earabul-sudo/GBDP_CERN_Robot/Renders/20200414_IntegratedModel_EA_15_00_2020-May-28_08-21-39AM-000_CustomizedView31010884164_png.png

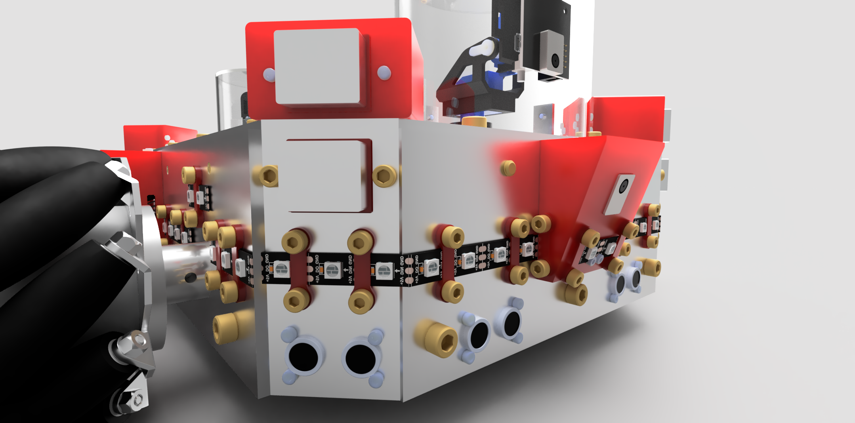
Renders/20200414_IntegratedModel_EA_15_00_2020-May-28_08-21-39AM-000_CustomizedView31010884164_png.png
