earabul-sudo/GBDP_CERN_Robot/Renders/20200414_IntegratedModel_EA_1600_2020-May-26_11-13-54AM-000_CustomizedView11686190738_png.png

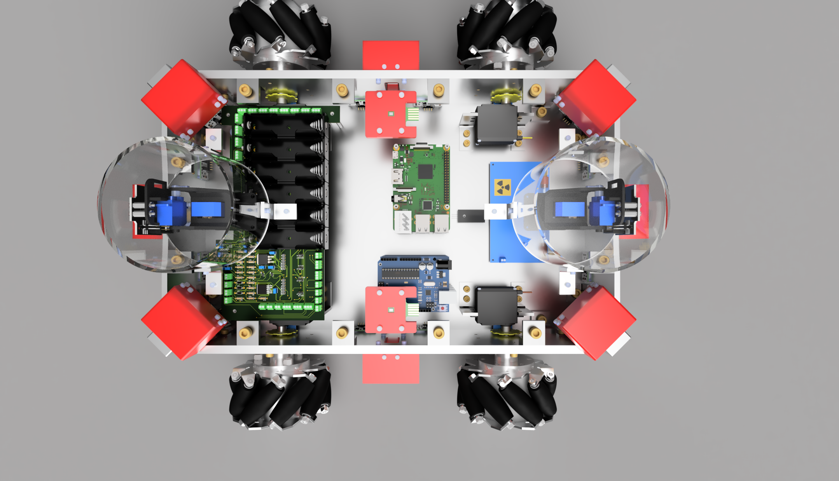
Renders/20200414_IntegratedModel_EA_1600_2020-May-26_11-13-54AM-000_CustomizedView11686190738_png.png
