earabul-sudo/GBDP_CERN_Robot/README.md

# GBDP_CERN_Robot

The report "20200524_PMReport_EA_04.pdf" can be read as the overview of the project.

The Complete CAD model can be found in;

https://a360.co/3e9NEjW

For any issues, please contact -> ea485@bath.ac.uk
