earabul-sudo/GBDP_CERN_Robot/Schematics_Drawings/LTC4150_Coulomb_Counter_BOB-master/documentation/spreadsheet.ods

Calculate the max current given the sense resistor
sense resistor | Rsense | 0.05 | ohm
max current | Imax | 1 | A
Calculate the sense resistor given the max current
max current | Imax | 1 | A
sense resistor | Rsense | 0.05 | ohm
Run the numbers
max current | Imax | 1 | A
sense resistor | Rsense | 0.05 | ohm
voltage gain | Vgf | 32.55 | Hz/V (from datasheet)
your current through Rs | I | 1 | A
frequency out | f | 1.63 | Hz
= one pulse every |  | 0.61 | s
one pulse equal to |  | 0.61 | coulomb
one pulse equal to |  | 0.0001707 | Ah
one amp-hour equals | 1 Ah = | 5859 | pulses
Calculate minimum pull-up resistor
computer supply | Vcc | 3.3 | V
Minimum pullup resistor | Rl > | 1750 | ohm
R1 |  | 75000 | ohm
R2 |  | 47000 | ohm
Eq 12 |  | 122000 | >= | 87500
Eq 13 | 1.9 <= | 2.03 | <= VDDmin (lowest batt V)
