earabul-sudo/GBDP_CERN_Robot/Renders/20200406_FrontBoard_EA_04_2020-May-25_08-08-47AM-000_CustomizedView26765888059_png.png

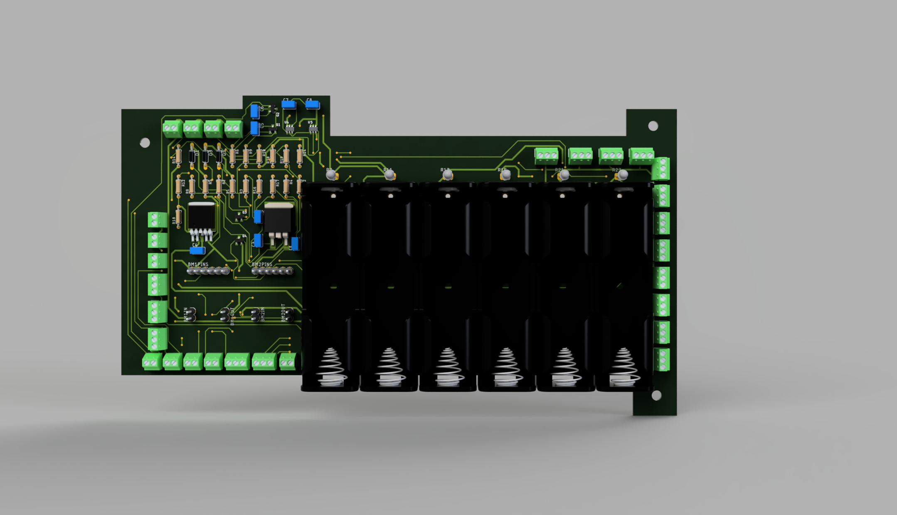
Renders/20200406_FrontBoard_EA_04_2020-May-25_08-08-47AM-000_CustomizedView26765888059_png.png
