earabul-sudo/GBDP_CERN_Robot/Renders/20200413_RaspberryPiStack_EA_00_2020-May-25_08-18-17AM-000_CustomizedView22463231648_png.png

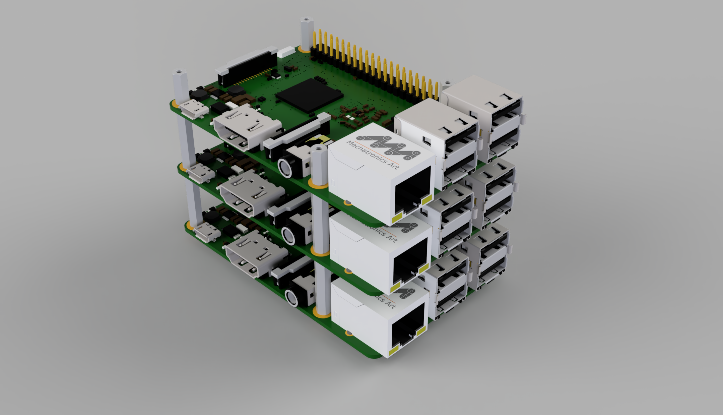
Renders/20200413_RaspberryPiStack_EA_00_2020-May-25_08-18-17AM-000_CustomizedView22463231648_png.png
