earabul-sudo/GBDP_CERN_Robot/Renders/20200414_ArduinoStack_EA_00_2020-May-25_08-23-36AM-000_CustomizedView26771065186_png.png

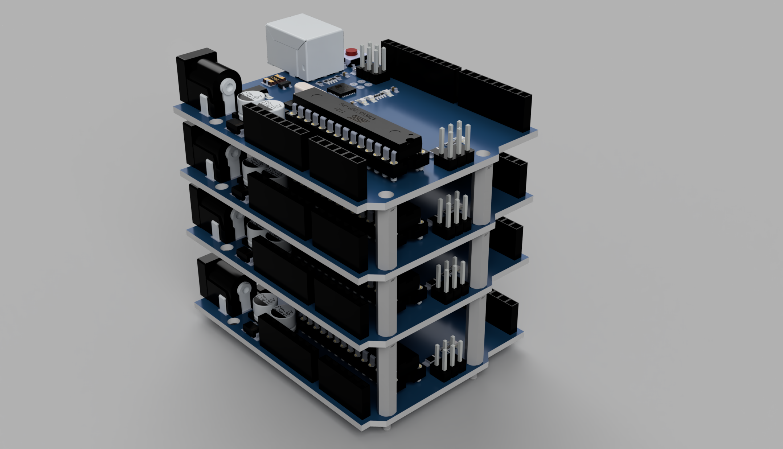
Renders/20200414_ArduinoStack_EA_00_2020-May-25_08-23-36AM-000_CustomizedView26771065186_png.png
