earabul-sudo/GBDP_CERN_Robot/Renders/20200414_IntegratedModel_EA_15_00_2020-Jun-01_04-20-42PM-000_CustomizedView44419950994_png.png

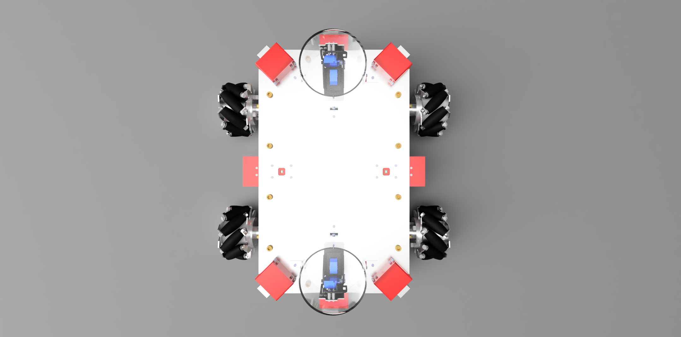
Renders/20200414_IntegratedModel_EA_15_00_2020-Jun-01_04-20-42PM-000_CustomizedView44419950994_png.png
