earabul-sudo/GBDP_CERN_Robot/Renders/20200414_IntegratedModel_EA_15_00_2020-Jun-02_04-21-08PM-000_CustomizedView185871683_png.png

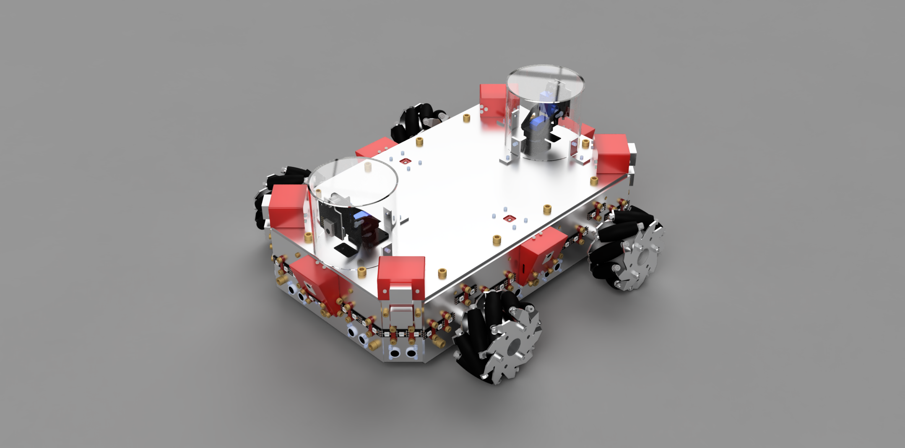
Renders/20200414_IntegratedModel_EA_15_00_2020-Jun-02_04-21-08PM-000_CustomizedView185871683_png.png
