earabul-sudo/GBDP_CERN_Robot/Renders/20200414_IntegratedModel_EA_15_00_2020-Jun-05_02-10-19PM-000_CustomizedView28039964760_png.png

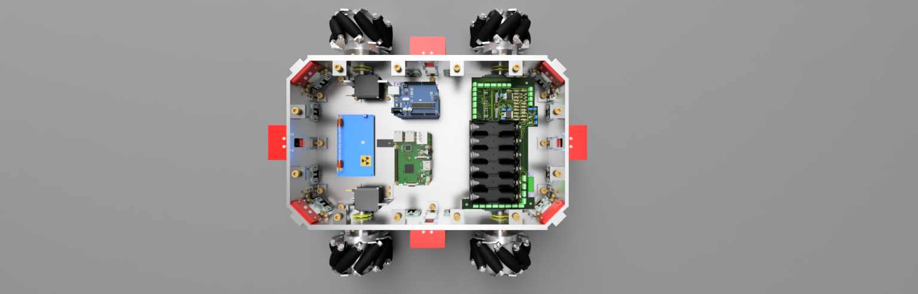
Renders/20200414_IntegratedModel_EA_15_00_2020-Jun-05_02-10-19PM-000_CustomizedView28039964760_png.png
