earabul-sudo/GBDP_CERN_Robot/Renders/20200414_IntegratedModel_EA_15_00_2020-Jun-05_02-23-30PM-000_CustomizedView17358813709_png.png

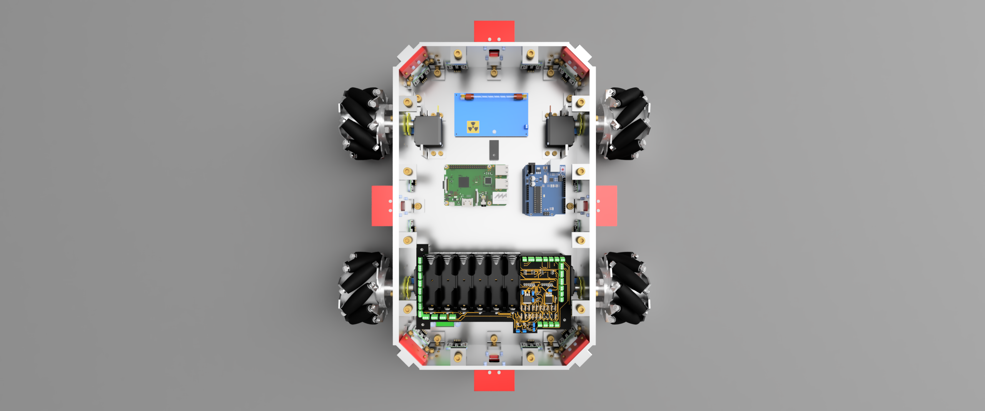
Renders/20200414_IntegratedModel_EA_15_00_2020-Jun-05_02-23-30PM-000_CustomizedView17358813709_png.png
