earabul-sudo/GBDP_CERN_Robot/Renders/20200414_IntegratedModel_EA_15_00_2020-May-24_08-03-37PM-000_CustomizedView12571228953_png.png

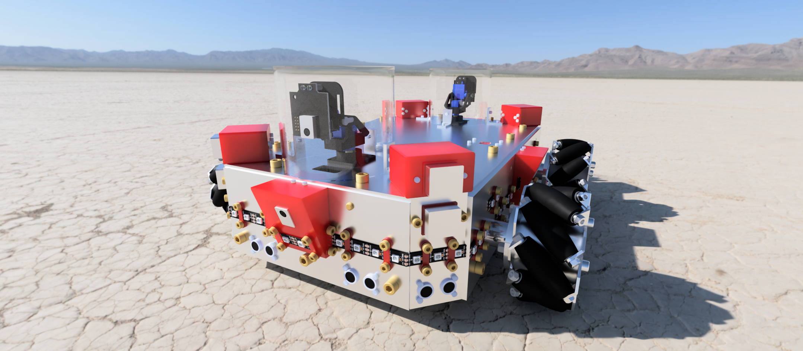
Renders/20200414_IntegratedModel_EA_15_00_2020-May-24_08-03-37PM-000_CustomizedView12571228953_png.png
