earabul-sudo/GBDP_CERN_Robot/Renders/20200414_IntegratedModel_EA_15_00_2020-May-25_07-35-35AM-000_CustomizedView1277902568_png.png

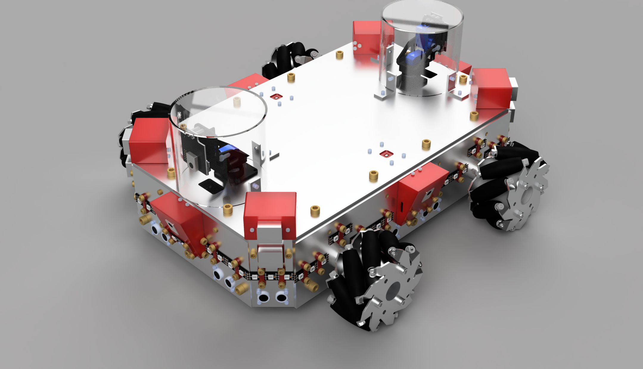
Renders/20200414_IntegratedModel_EA_15_00_2020-May-25_07-35-35AM-000_CustomizedView1277902568_png.png
