earabul-sudo/GBDP_CERN_Robot/Renders/20200414_IntegratedModel_EA_15_00_2020-May-25_08-12-26AM-000_CustomizedView5717836970_png.png

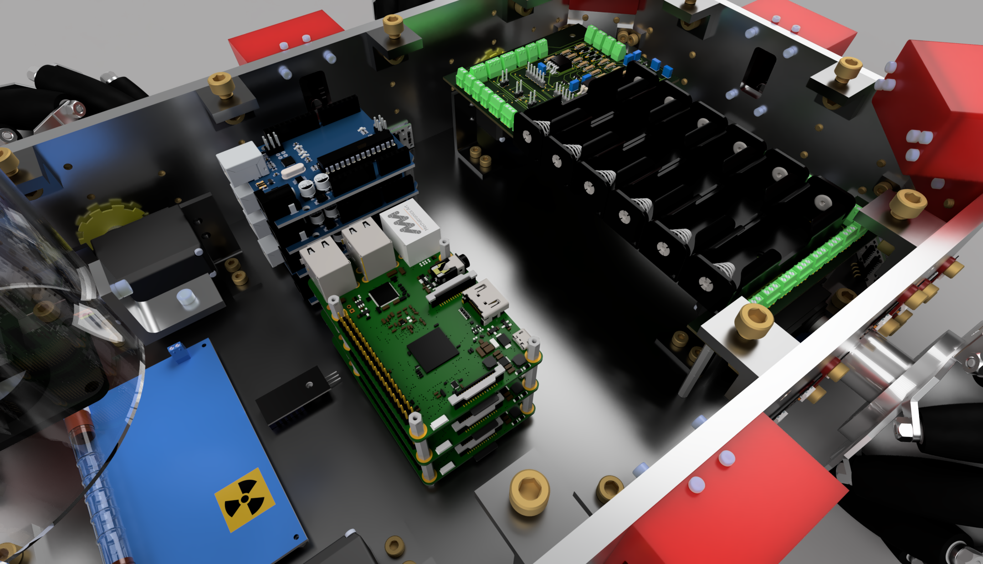
Renders/20200414_IntegratedModel_EA_15_00_2020-May-25_08-12-26AM-000_CustomizedView5717836970_png.png
