earabul-sudo/GBDP_CERN_Robot/Renders/20200414_IntegratedModel_EA_15_00_2020-May-28_08-05-02AM-000_CustomizedView13526864953_png.png

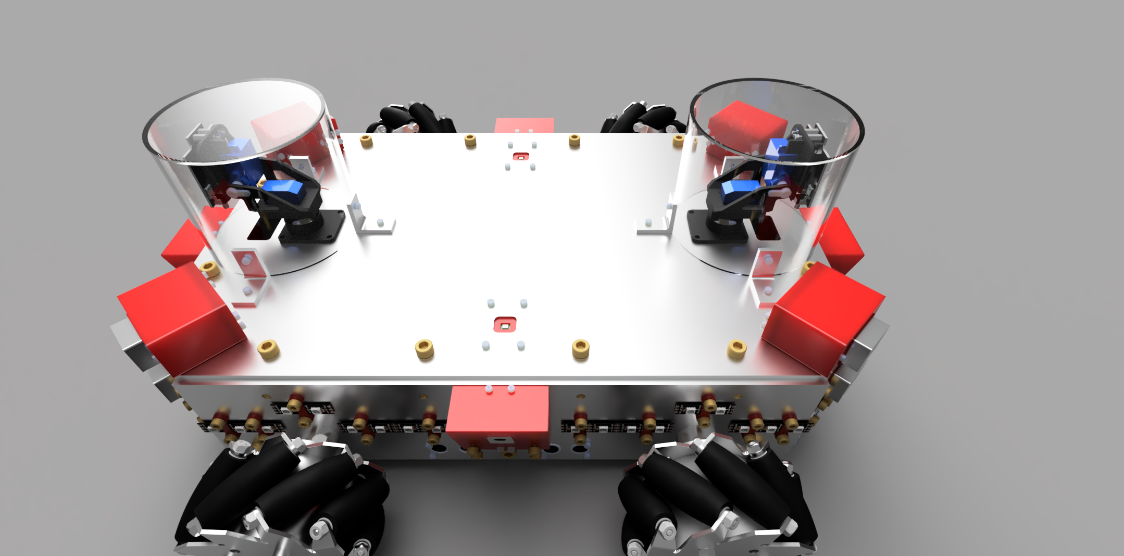
Renders/20200414_IntegratedModel_EA_15_00_2020-May-28_08-05-02AM-000_CustomizedView13526864953_png.png
