earabul-sudo/GBDP_CERN_Robot/Renders/20200414_IntegratedModel_EA_15_00_2020-May-28_08-20-58AM-000_CustomizedView8640977240_png.png

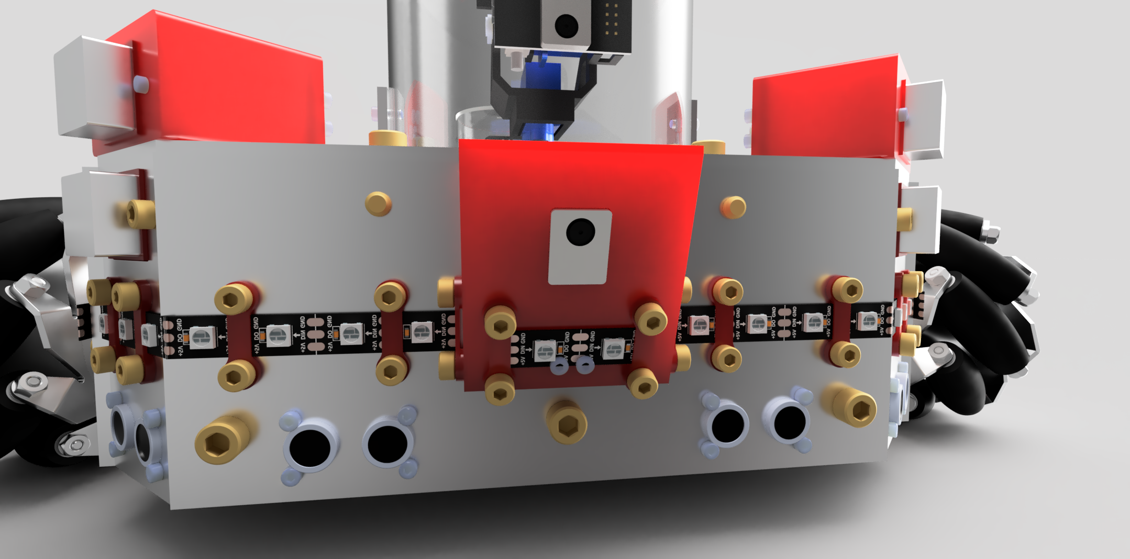
Renders/20200414_IntegratedModel_EA_15_00_2020-May-28_08-20-58AM-000_CustomizedView8640977240_png.png
