earabul-sudo/GBDP_CERN_Robot/Renders/20200414_IntegratedModel_EA_1600_2020-May-26_05-35-03PM-000_CustomizedView29689438640_png.png

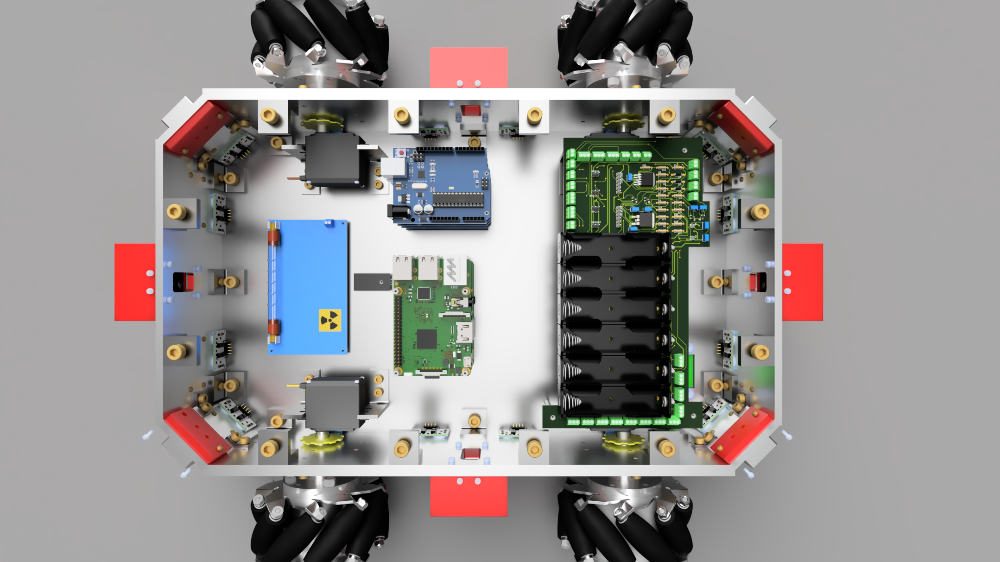
Renders/20200414_IntegratedModel_EA_1600_2020-May-26_05-35-03PM-000_CustomizedView29689438640_png.png
