earabul-sudo/GBDP_CERN_Robot/Renders/20200414_IntegratedModel_EA_1600_2020-May-26_11-09-33AM-000_CustomizedView14897361486_png.png

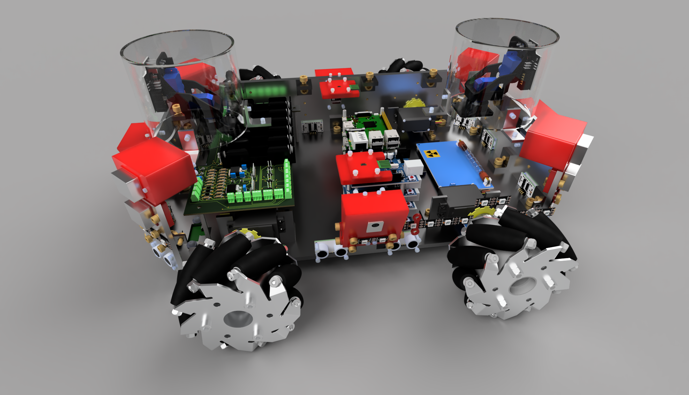
Renders/20200414_IntegratedModel_EA_1600_2020-May-26_11-09-33AM-000_CustomizedView14897361486_png.png
