earabul-sudo/GBDP_CERN_Robot/Schematics_Drawings/Grove-Optical_Rotary_Encoder-TCUT1600X01/Grove - Optical Rotary Encoder(TCUT1600X01).pdf

A

B

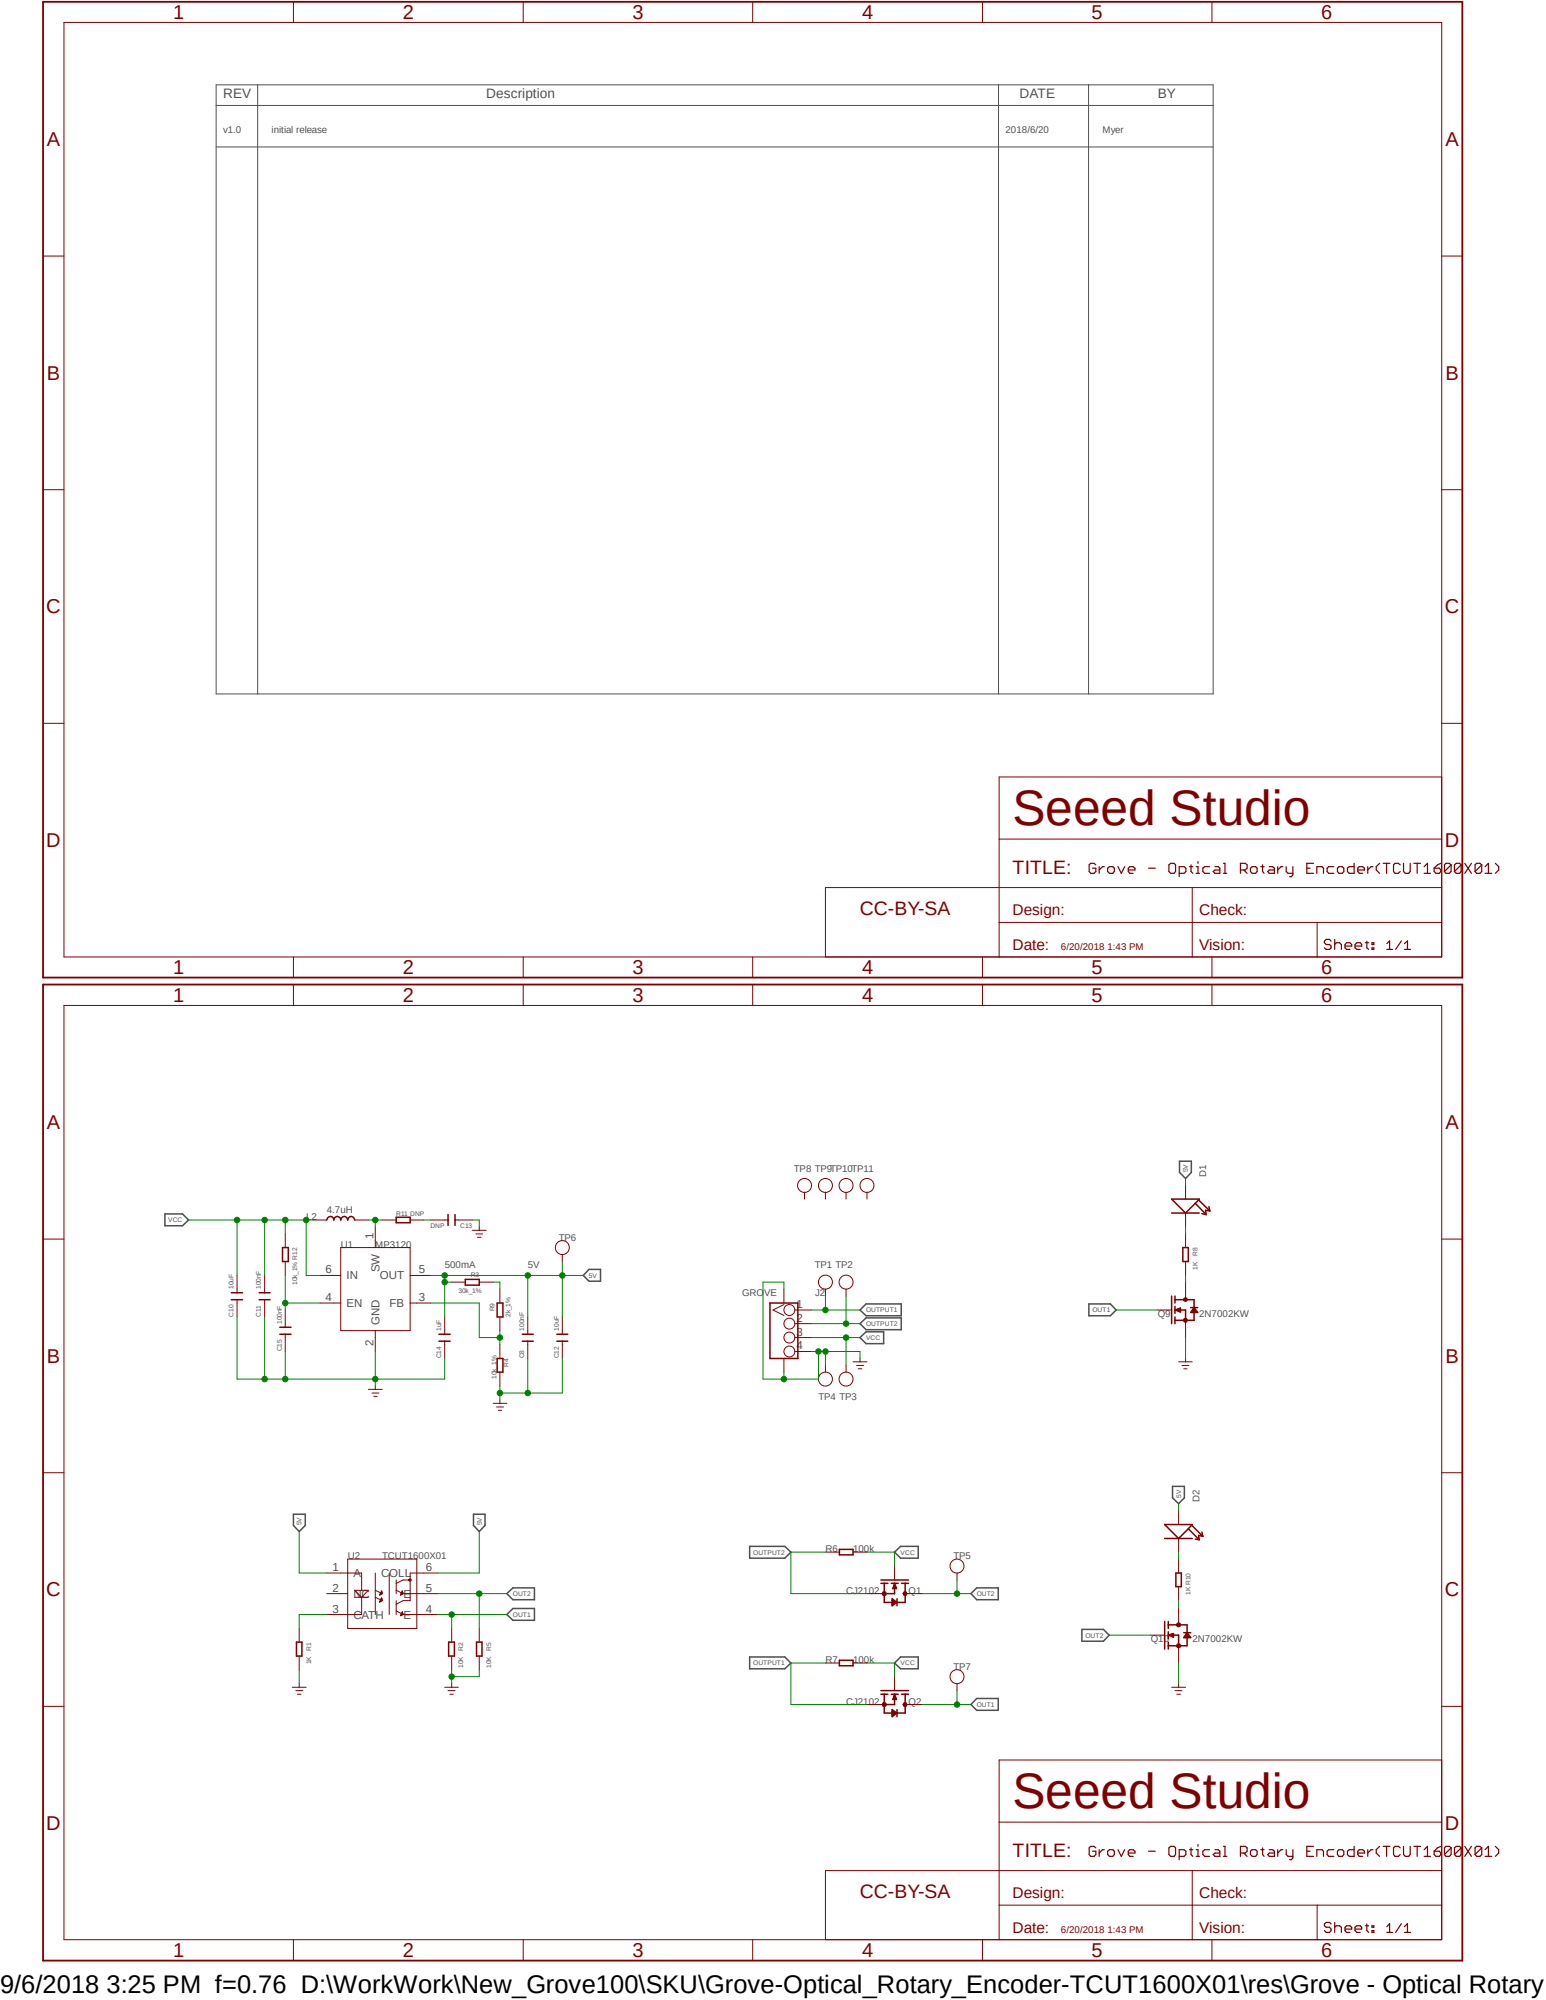
[picture p18: page 1]

9/6/2018 3:25 PM f=0.76 D:\WorkWork\New_Grove100\SKU\Grove-Optical_Rotary_Encoder-TCUT1600X01\res\Grove - Optical Rotary Encoder(TCUT1600X01).sch (Sheet: 1/1)
