earabul-sudo/GBDP_CERN_Robot/Schematics_Drawings/pdf/20200406_FrontBoard_EA_04_01.pdf

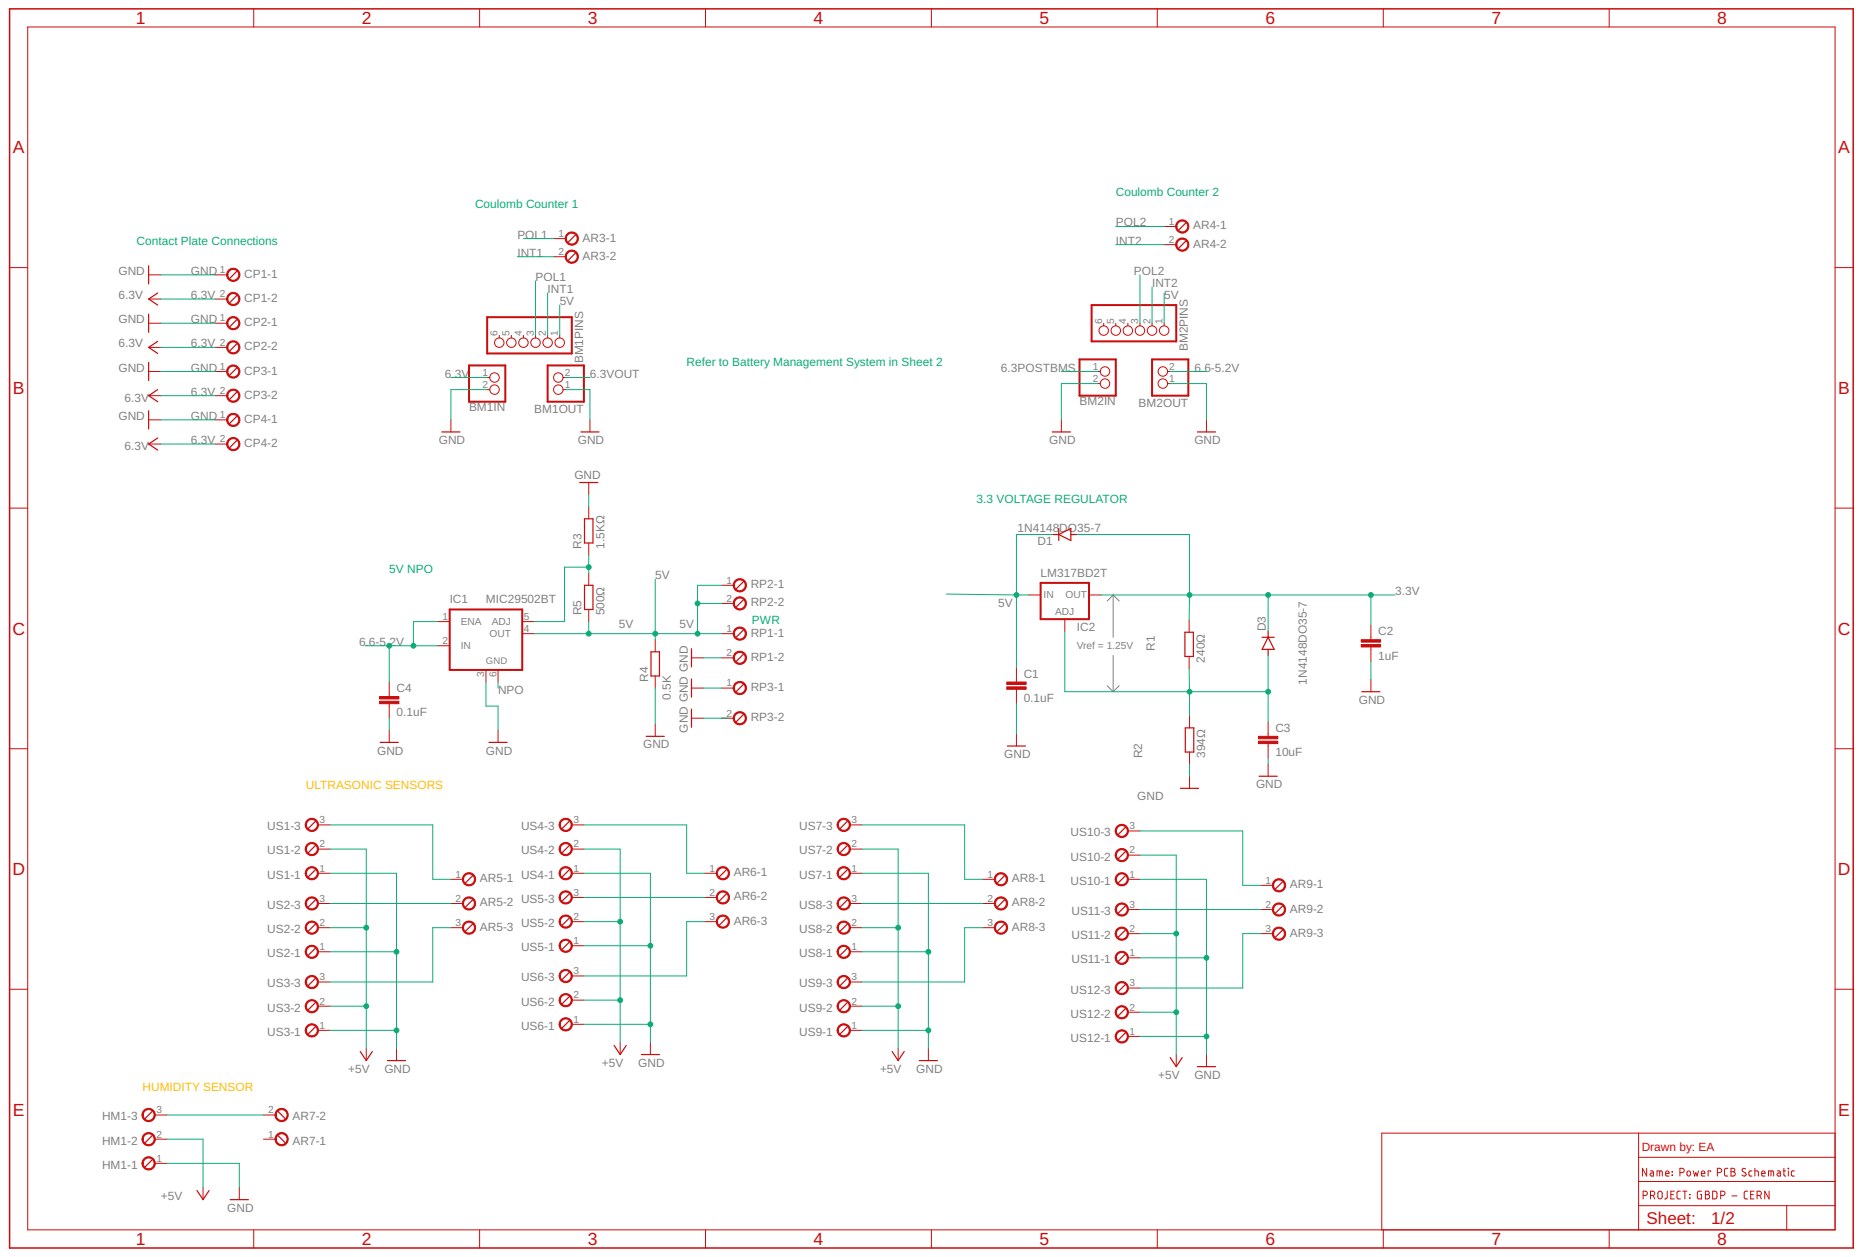
[picture p19: page 1]

Refer to Battery Management System in Sheet 2
