earabul-sudo/GBDP_CERN_Robot/Schematics_Drawings/pdf/20200413_Systems_EA_00.pdf

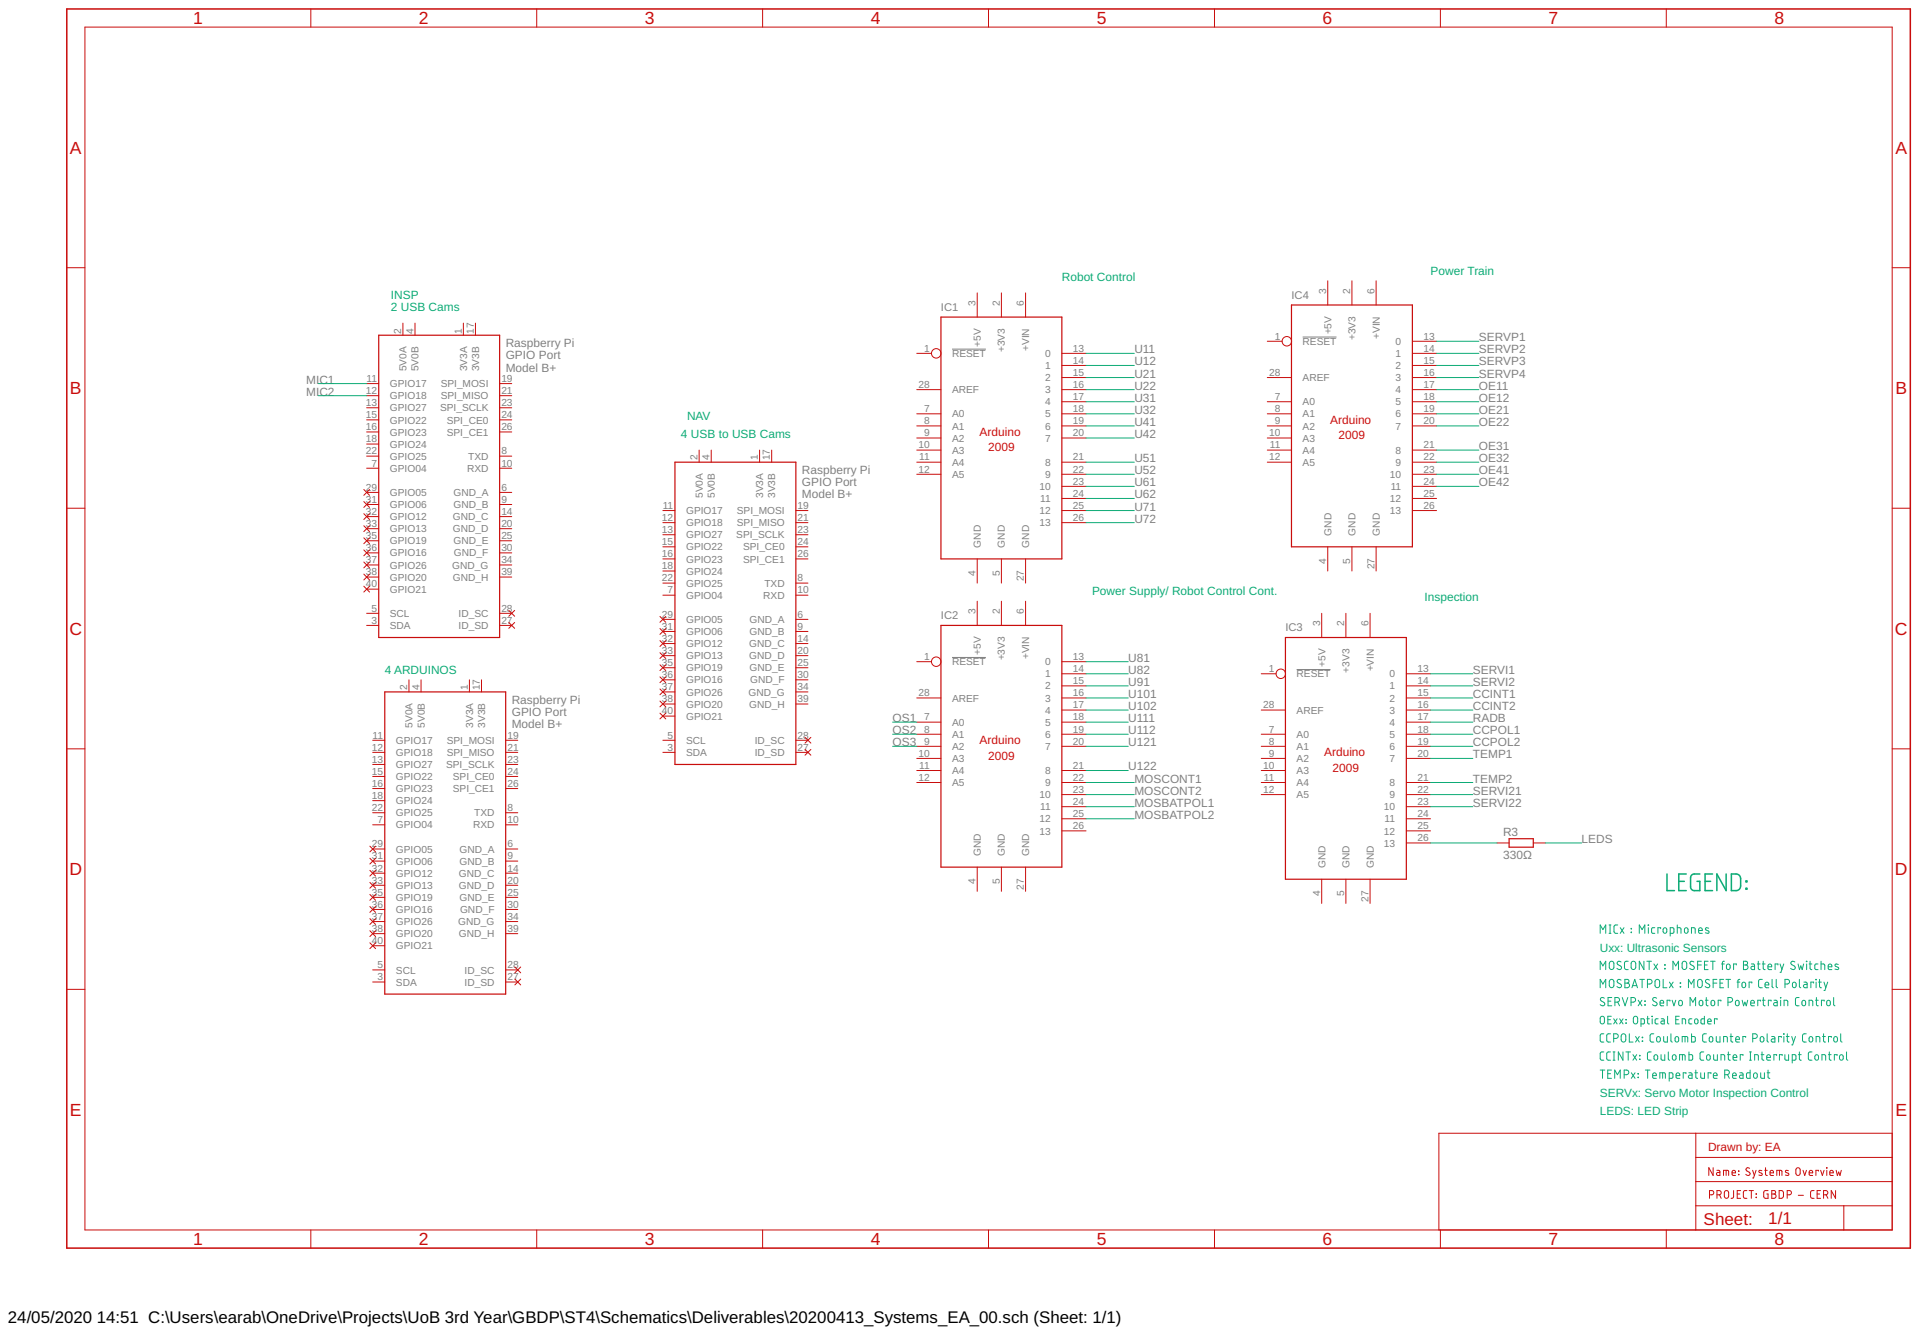
[picture p20: page 1]

4 USB to USB Cams NAV

Inspection Power Supply/ Robot Control Cont.

SERVx: Servo Motor Inspection Control
LEDS: LED Strip

24/05/2020 14:51 C:\Users\earab\OneDrive\Projects\UoB 3rd Year\GBDP\ST4\Schematics\Deliverables\20200413_Systems_EA_00.sch (Sheet: 1/1)
