earabul-sudo/GBDP_CERN_Robot/Schematics_Drawings/pdf/20200414_IntegratedModel_EA_15_01 v13.pdf

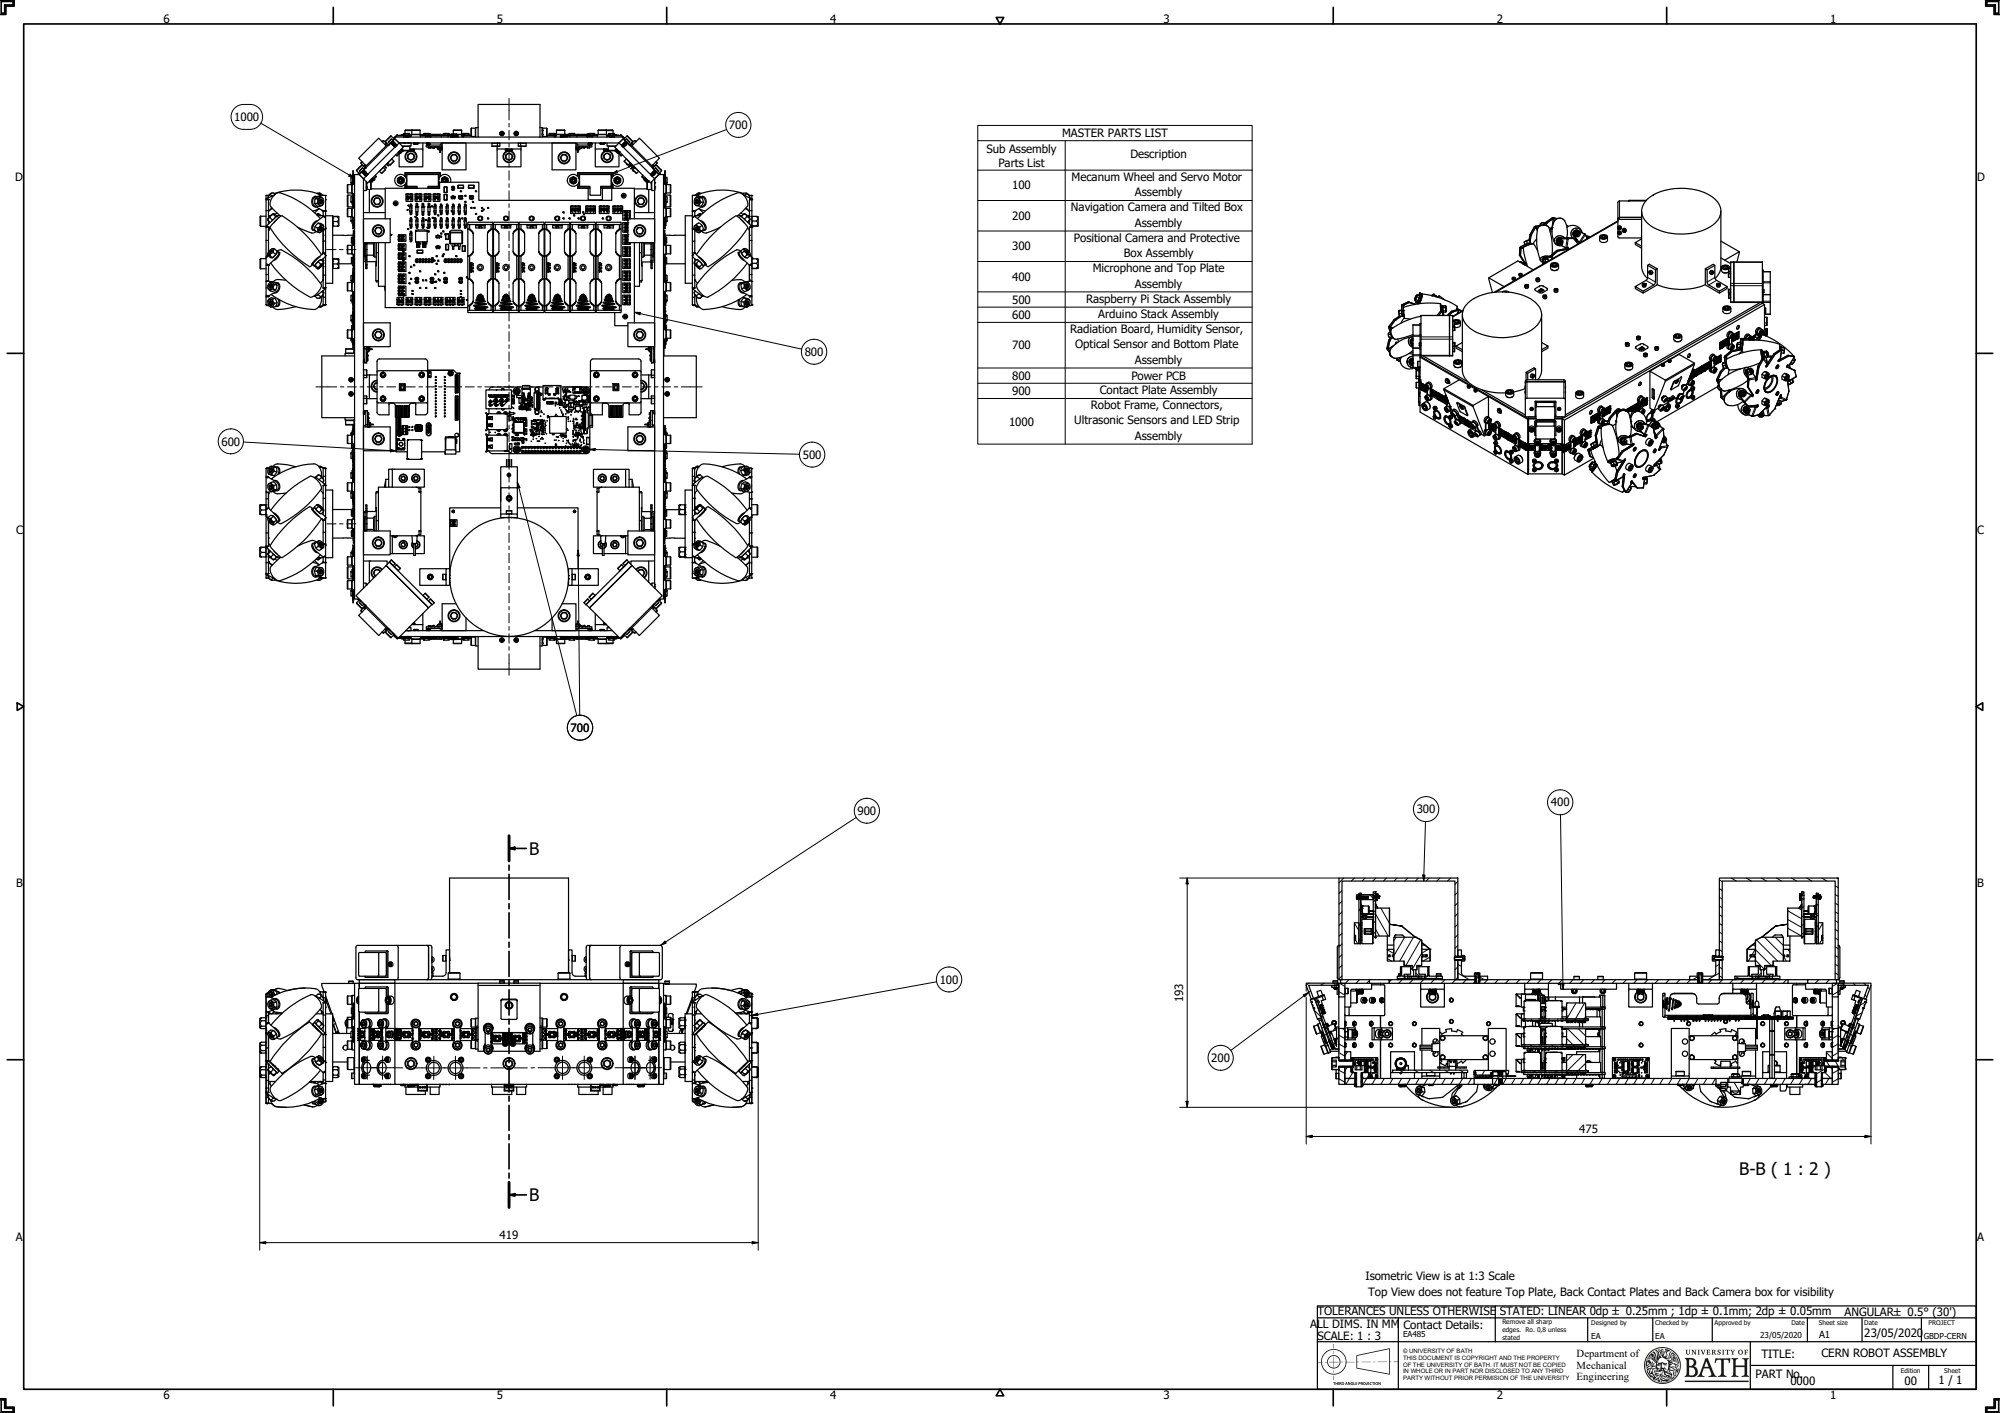
[picture p21: page 1]
Designed by; Checked by; Approved by; Date; Department of; SCALE: 1 : 3; Sheet size; PART No.; Contact Details:; TITLE:; CERN ROBOT ASSEMBLY; Sub Assembly Parts List; Raspberry Pi Stack Assembly; Arduino Stack Assembly; Power PCB; Contact Plate Assembly

MASTER PARTS LIST

Mecanum Wheel and Servo Motor

Navigation Camera and Tilted Box

Positional Camera and Protective

Box Assembly
Microphone and Top Plate

Radiation Board, Humidity Sensor,
Optical Sensor and Bottom Plate

Robot Frame, Connectors,
Ultrasonic Sensors and LED Strip

Isometric View is at 1:3 Scale
Top View does not feature Top Plate, Back Contact Plates and Back Camera box for visibility

TOLERANCES UNLESS OTHERWISE STATED: LINEAR 0dp  0.25mm ; 1dp ± 0.1mm; 2dp ± 0.05mm ANGULAR 0.5° (30')
ALL DIMS. IN MM

Remove all sharp
edges. Ro. 0,8 unless
stated

© UNIVERSITY OF BATH
THIS DOCUMENT IS COPYRIGHT AND THE PROPERTY
OF THE UNIVERSITY OF BATH. IT MUST NOT BE COPIED
IN WHOLE OR IN PART NOR DISCLOSED TO ANY THIRD
PARTY WITHOUT PRIOR PERMISION OF THE UNIVERSITY
