earabul-sudo/GBDP_CERN_Robot/Schematics_Drawings/pdf/20200523_ArduinoStackAssembly.pdf

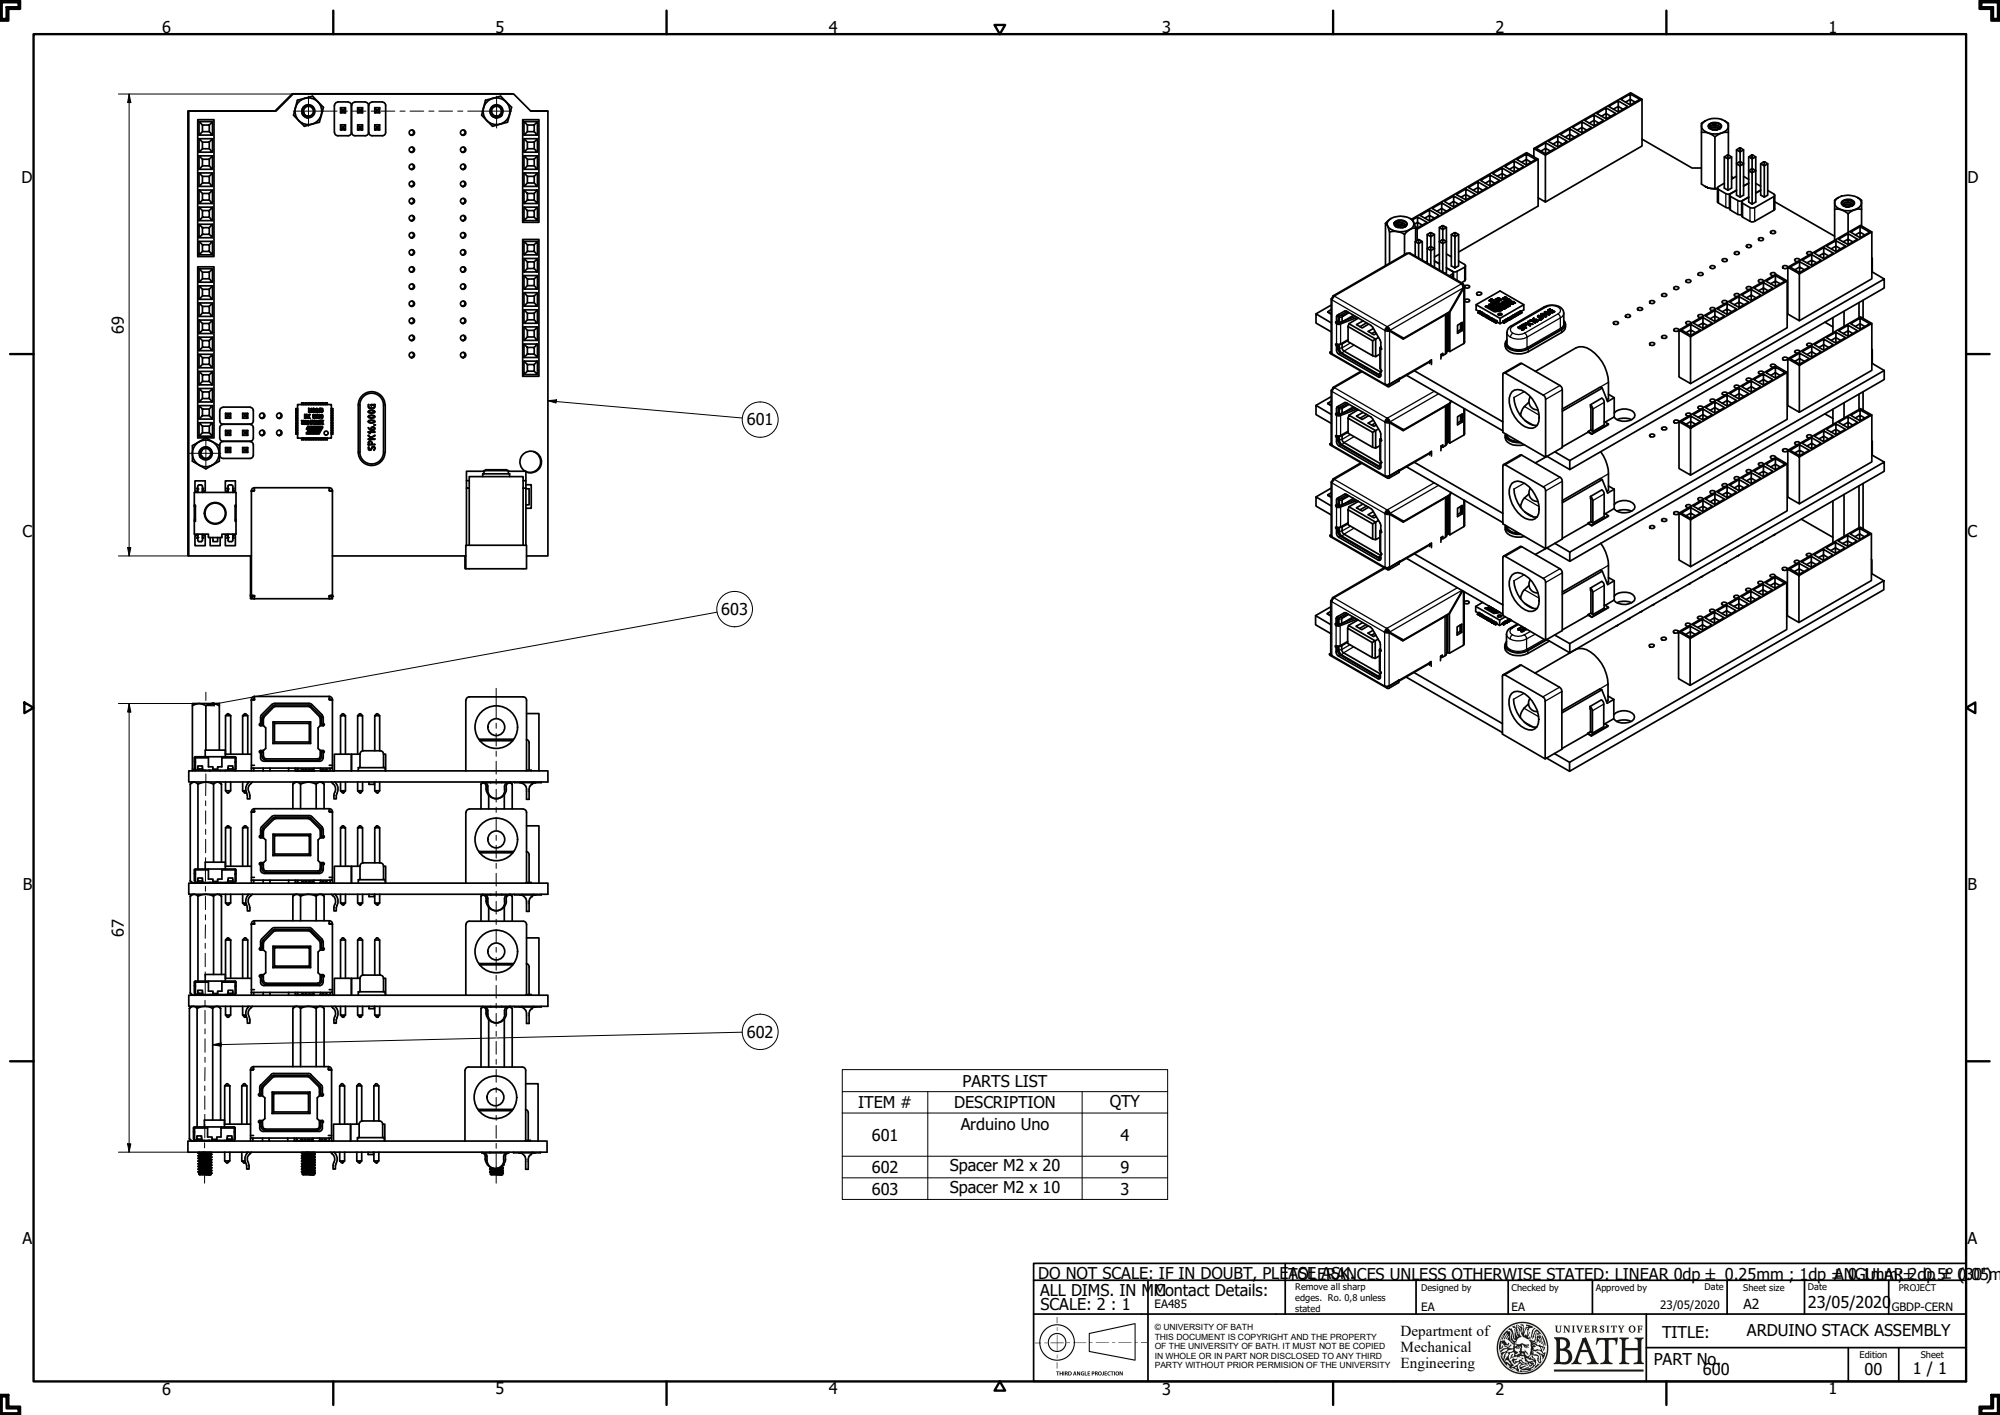
[picture p22: page 1]
PARTS LIST

ITEM # | DESCRIPTION | QTY
601 | Arduino Uno | 4

602 | Spacer M2 x 20 | 9
603 | Spacer M2 x 10 | 3

DO NOT SCALE: IF IN DOUBT, PLEASE ASK.
ALL DIMS. IN MM SCALE: 2 : 1 | Contact Details: EA485 | Remove all sharp edges. Ro. 0,8 unless stated | Designed by EA | Checked by EA | Approved by Date 23/05/2020 | Sheet size A2 | Date 23/05/2020 | PROJECT GBDP-CERN

TOLERANCES UNLESS OTHERWISE STATED: LINEAR 0dp  0.25mm ; 1dp ±AN0G.1UmLAmR;2d0p.5±° 0(3.005')mm

© UNIVERSITY OF BATH THIS DOCUMENT IS COPYRIGHT AND THE PROPERTY OF THE UNIVERSITY OF BATH. IT MUST NOT BE COPIED IN WHOLE OR IN PART NOR DISCLOSED TO ANY THIRD PARTY WITHOUT PRIOR PERMISION OF THE UNIVERSITY | Department of Mechanical Engineering | TITLE: ARDUINO STACK ASSEMBLY

PART No. 600 | Edition 00 | Sheet 1 / 1
