earabul-sudo/GBDP_CERN_Robot/Schematics_Drawings/pdf/20200523_MicrophoneandMountingAssembly_EA_00.pdf

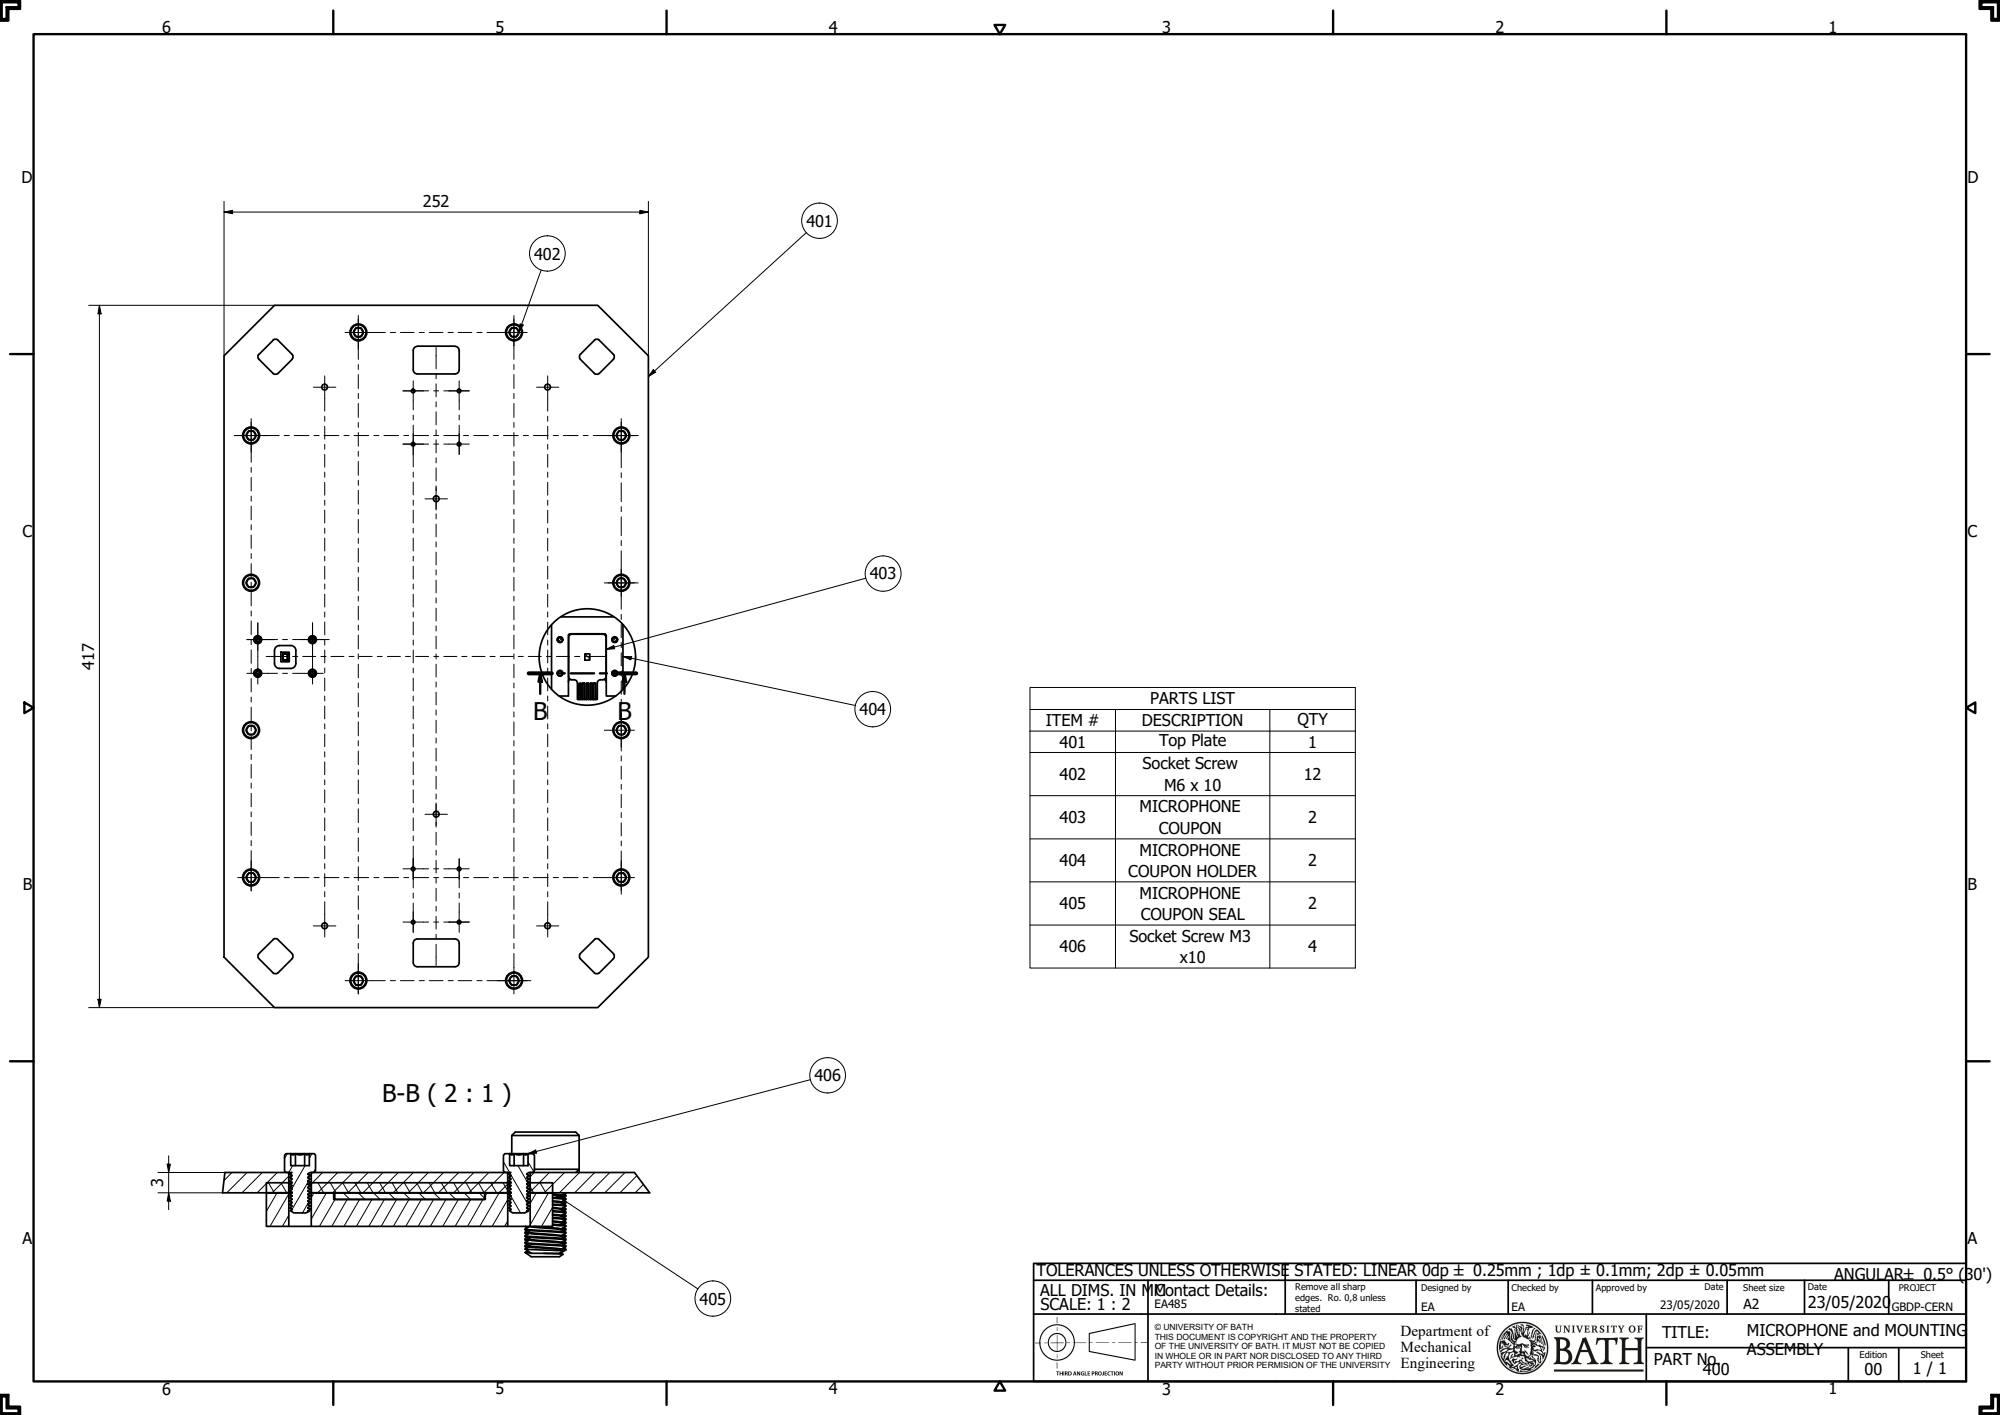
[picture p24: page 1]
PARTS LIST

ITEM # | DESCRIPTION | QTY
401 | Top Plate | 1
402 | Socket Screw M6 x 10 | 12

403 | MICROPHONE COUPON | 2

404 | MICROPHONE COUPON HOLDER | 2

405 | MICROPHONE COUPON SEAL | 2

406 | Socket Screw M3 x10 | 4

LERANCES UNLESS OTHERWISE STATED: LINEAR 0dp  0.25mm ; 1dp ± 0.1mm; 2dp ± 0.05mm
ALL DIMS. IN MM SCALE: 1 : 2 | Contact Details: EA485 | Remove all sharp edges. Ro. 0,8 unless stated | Designed by EA | Checked by EA | Approved by Date 23/05/2020 | Sheet size A2 | Date 23/05/2020 | PROJECT GBDP-CERN

© UNIVERSITY OF BATH THIS DOCUMENT IS COPYRIGHT AND THE PROPERTY OF THE UNIVERSITY OF BATH. IT MUST NOT BE COPIED IN WHOLE OR IN PART NOR DISCLOSED TO ANY THIRD PARTY WITHOUT PRIOR PERMISION OF THE UNIVERSITY | Department of Mechanical Engineering | MICROPHONE and MOUNTING TITLE:

ASSEMBLY PART No. 400 | Edition 00 | Sheet 1 / 1
