earabul-sudo/GBDP_CERN_Robot/Schematics_Drawings/pdf/20200523_NavigationCameraandTiltedBoxAssembly_EA_00.pdf

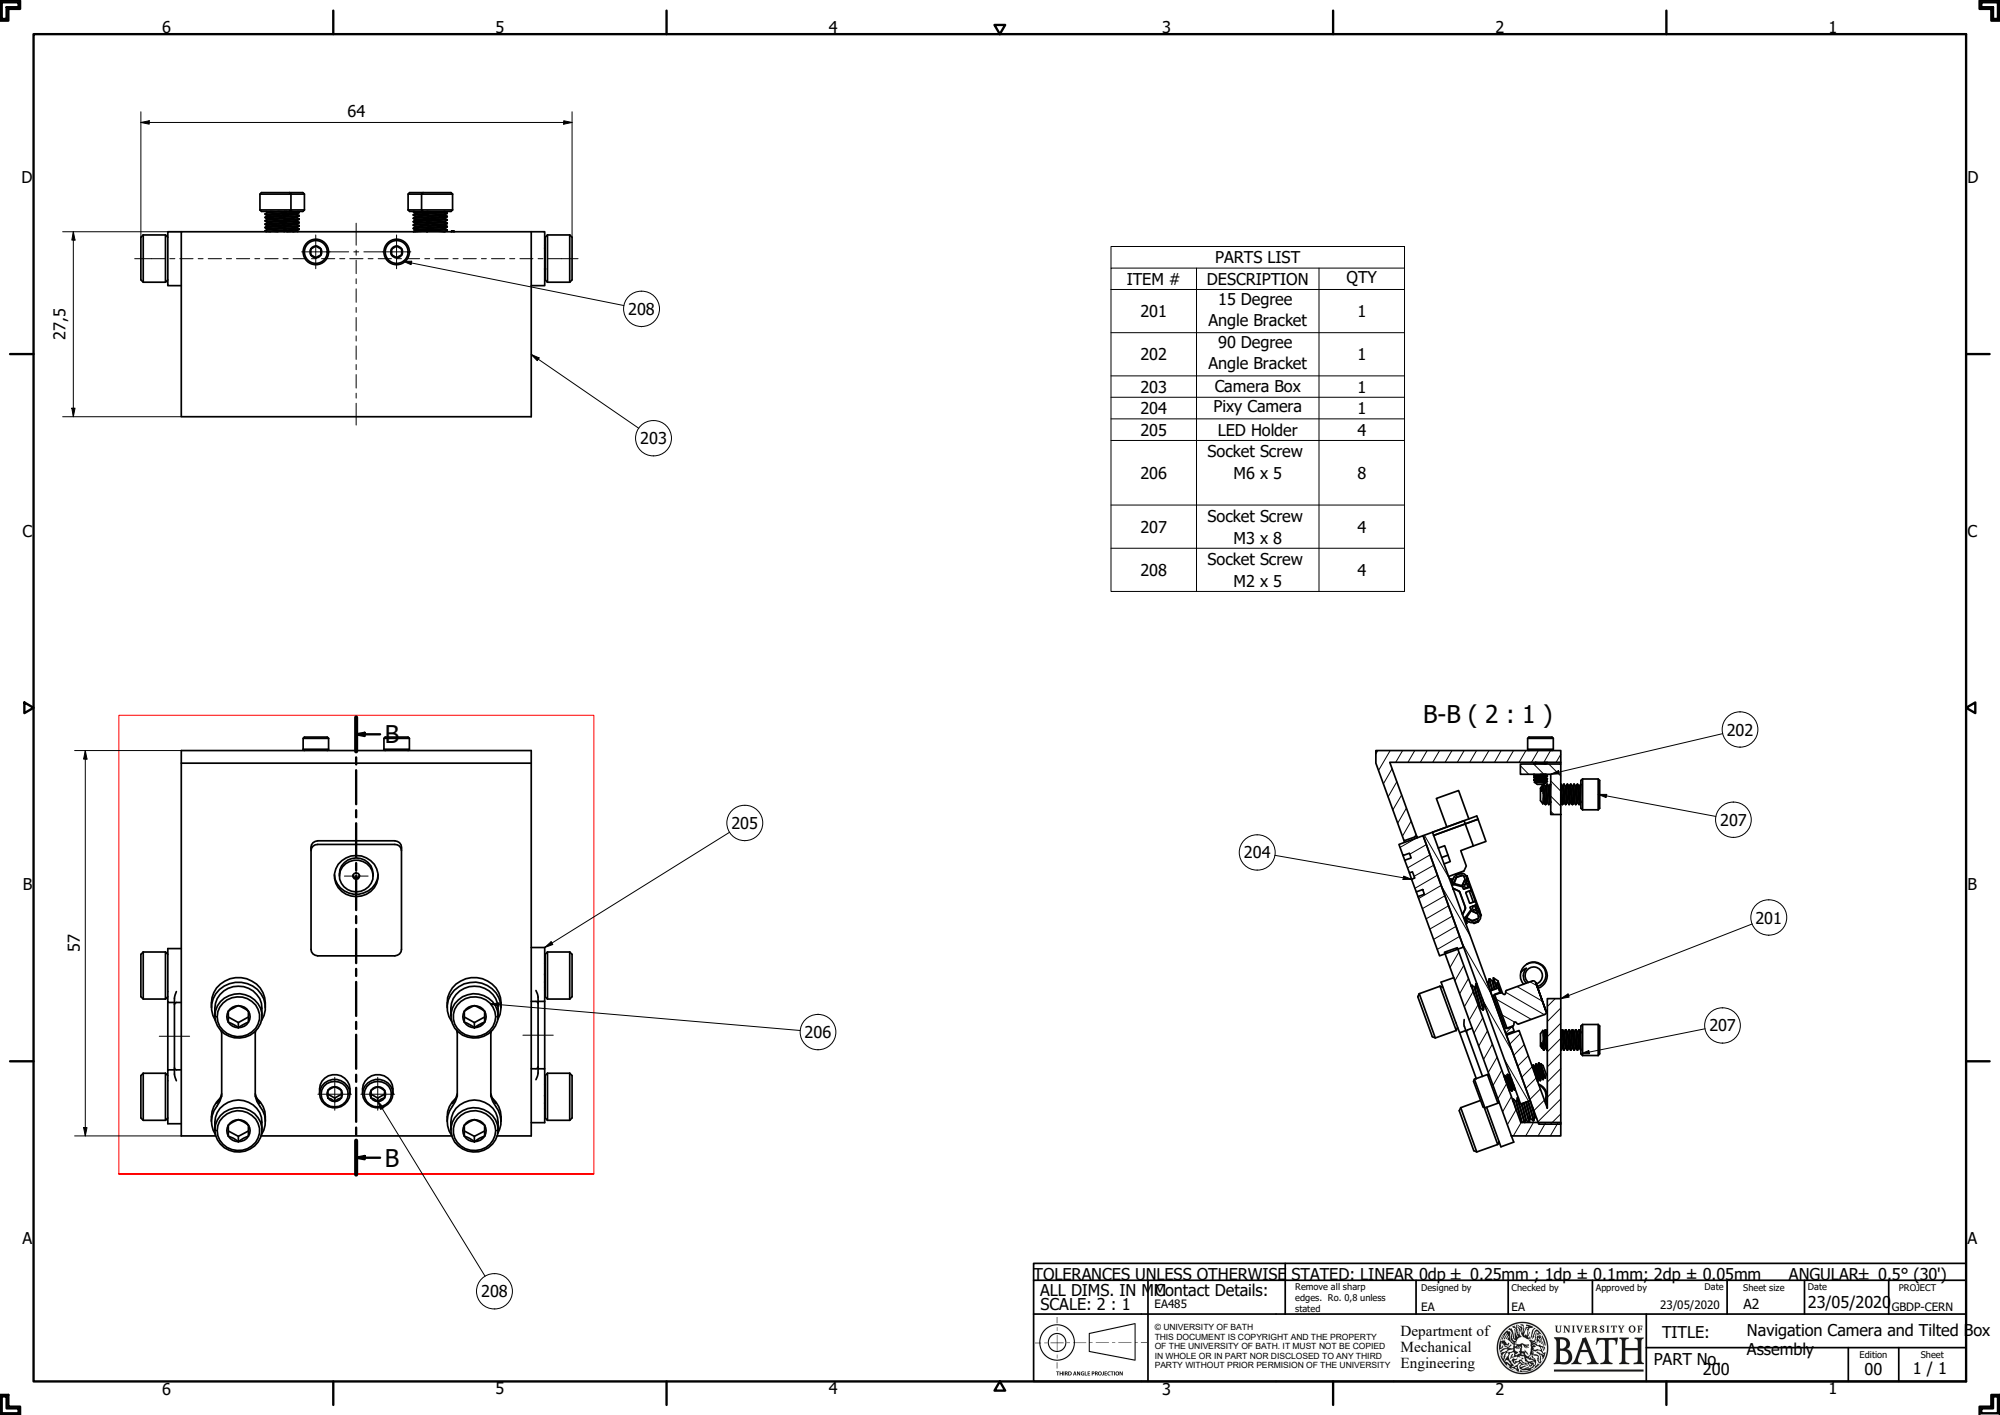
[picture p25: page 1]
PARTS LIST

ITEM # | DESCRIPTION | QTY
201 | 15 Degree Angle Bracket | 1

202 | 90 Degree Angle Bracket | 1

203 | Camera Box | 1
204 | Pixy Camera | 1
205 | LED Holder | 4
206 | Socket Screw M6 x 5 | 8

207 | Socket Screw M3 x 8 | 4

208 | Socket Screw M2 x 5 | 4

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

Navigation Camera and Tilted Box

Assembly PART No. 200 | Edition 00 | Sheet 1 / 1
