earabul-sudo/GBDP_CERN_Robot/Schematics_Drawings/pdf/20200523_PositionalCameraandProtectiveBoxAssembly_EA_00.pdf

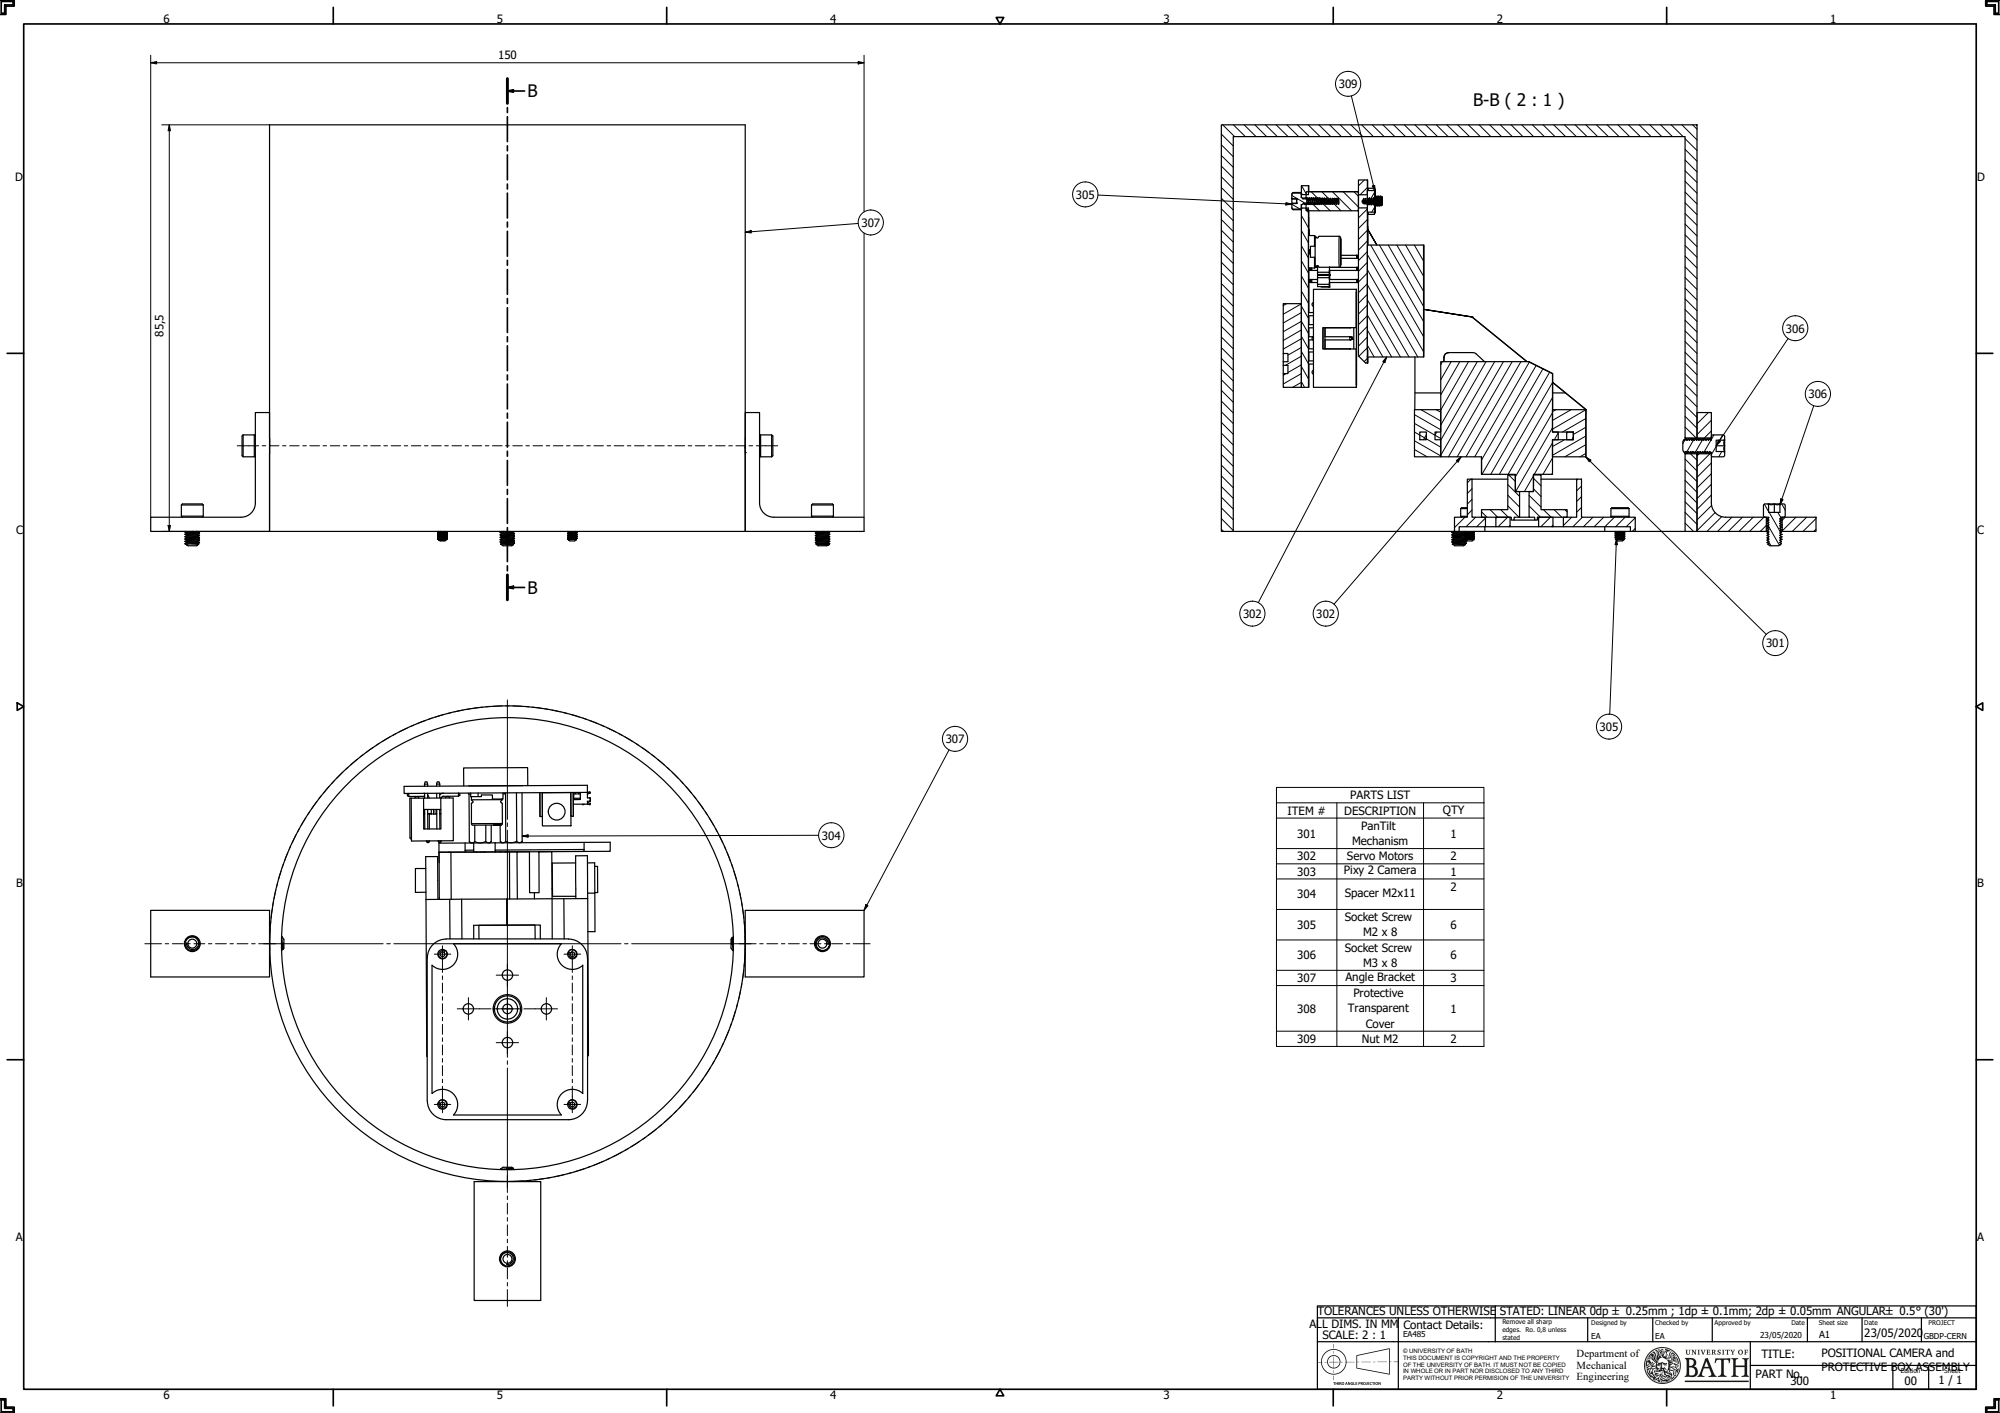
[picture p26: page 1]
PARTS LIST

ITEM # | DESCRIPTION | QTY
301 | PanTilt Mechanism | 1

302 | Servo Motors | 2
303 | Pixy 2 Camera | 1
304 | Spacer M2x11 | 2

305 | Socket Screw M2 x 8 | 6

306 | Socket Screw M3 x 8 | 6

307 | Angle Bracket | 3
308 | Protective Transparent Cover | 1

309 | Nut M2 | 2

TOLERANCES UNLESS OTHERWISE STATED: LINEAR 0dp  0.25mm ; 1dp ± 0.1mm; 2dp ± 0.05mm ANGULAR 0.5° (30')
SCALE: 2 : 1 | Contact Details: EA485 | Remove all sharp edges. Ro. 0,8 unless stated | Designed by EA | Checked by EA | Approved by Date 23/05/2020 | Sheet size A1 | Date 23/05/2020 | PROJECT GBDP-CERN

ALL DIMS. IN MM

© UNIVERSITY OF BATH THIS DOCUMENT IS COPYRIGHT AND THE PROPERTY OF THE UNIVERSITY OF BATH. IT MUST NOT BE COPIED IN WHOLE OR IN PART NOR DISCLOSED TO ANY THIRD PARTY WITHOUT PRIOR PERMISION OF THE UNIVERSITY | Department of Mechanical Engineering | TITLE: POSITIONAL CAMERA and

PROTECTIVE BOX ASSEMBLY PART No. 300 | Edition 00 | Sheet 1 / 1
