earabul-sudo/GBDP_CERN_Robot/Schematics_Drawings/pdf/20200523_PowerPCB_EA_00.pdf

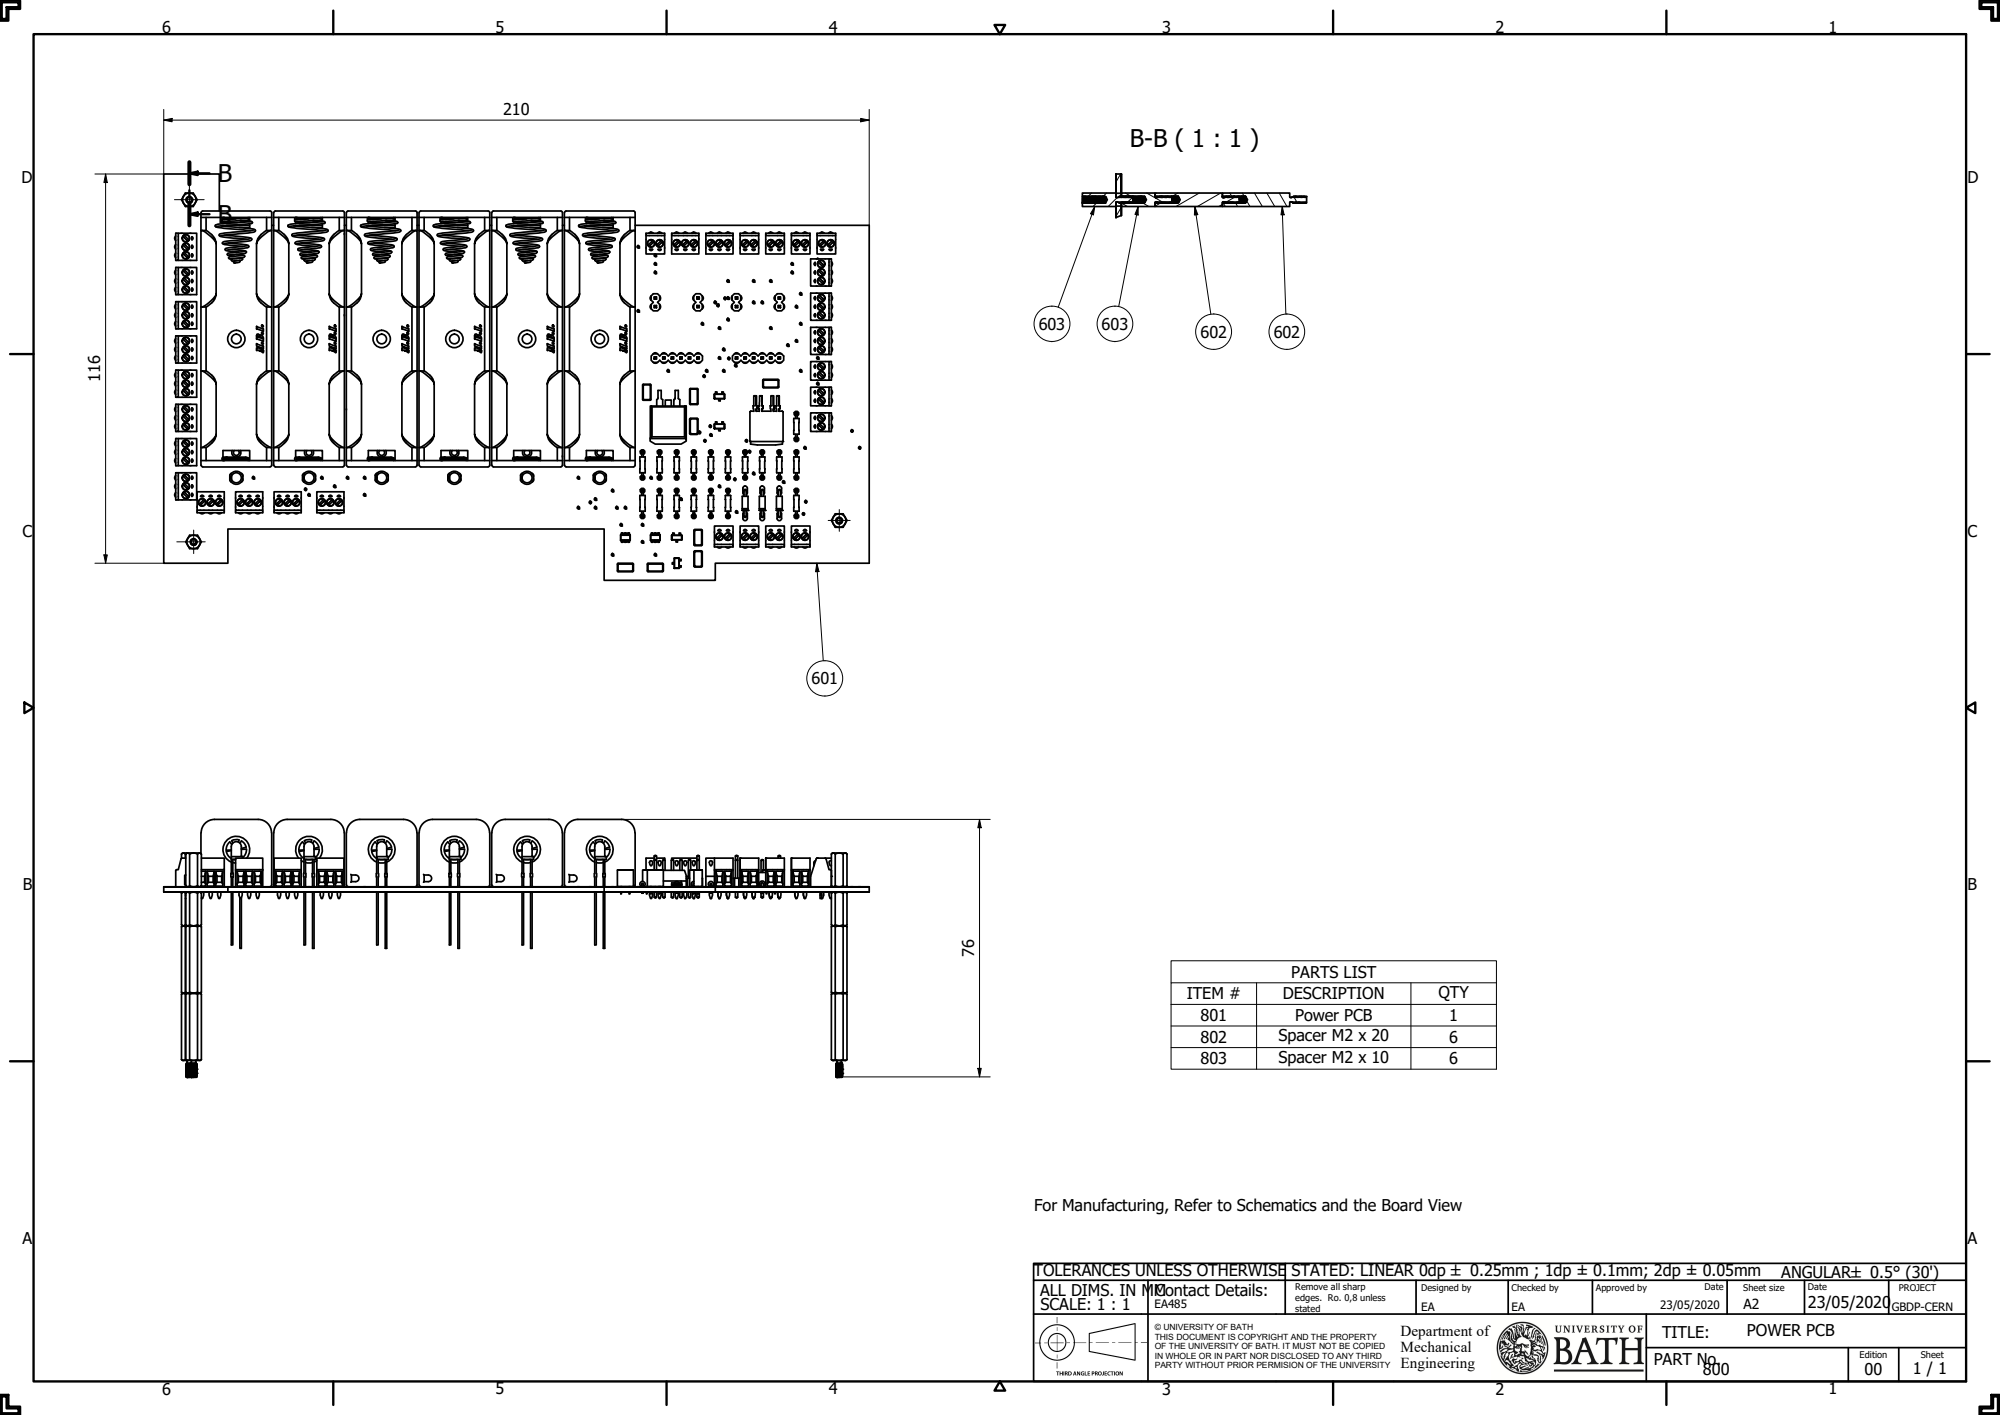
[picture p27: page 1]
Designed by; Checked by; Approved by; Date; Department of; SCALE: 1 : 1; Sheet size; PART No.; Contact Details:; TITLE:; POWER PCB; PARTS LIST; ITEM #; DESCRIPTION; QTY; Power PCB; Spacer M2 x 20; Spacer M2 x 10

For Manufacturing, Refer to Schematics and the Board View

ALL DIMS. IN MM

Remove all sharp
edges. Ro. 0,8 unless
stated

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
