earabul-sudo/GBDP_CERN_Robot/Schematics_Drawings/pdf/20200523_RadiationBoardHumiditySensorOpticalSensorandBottomPlate_EA_00.pdf

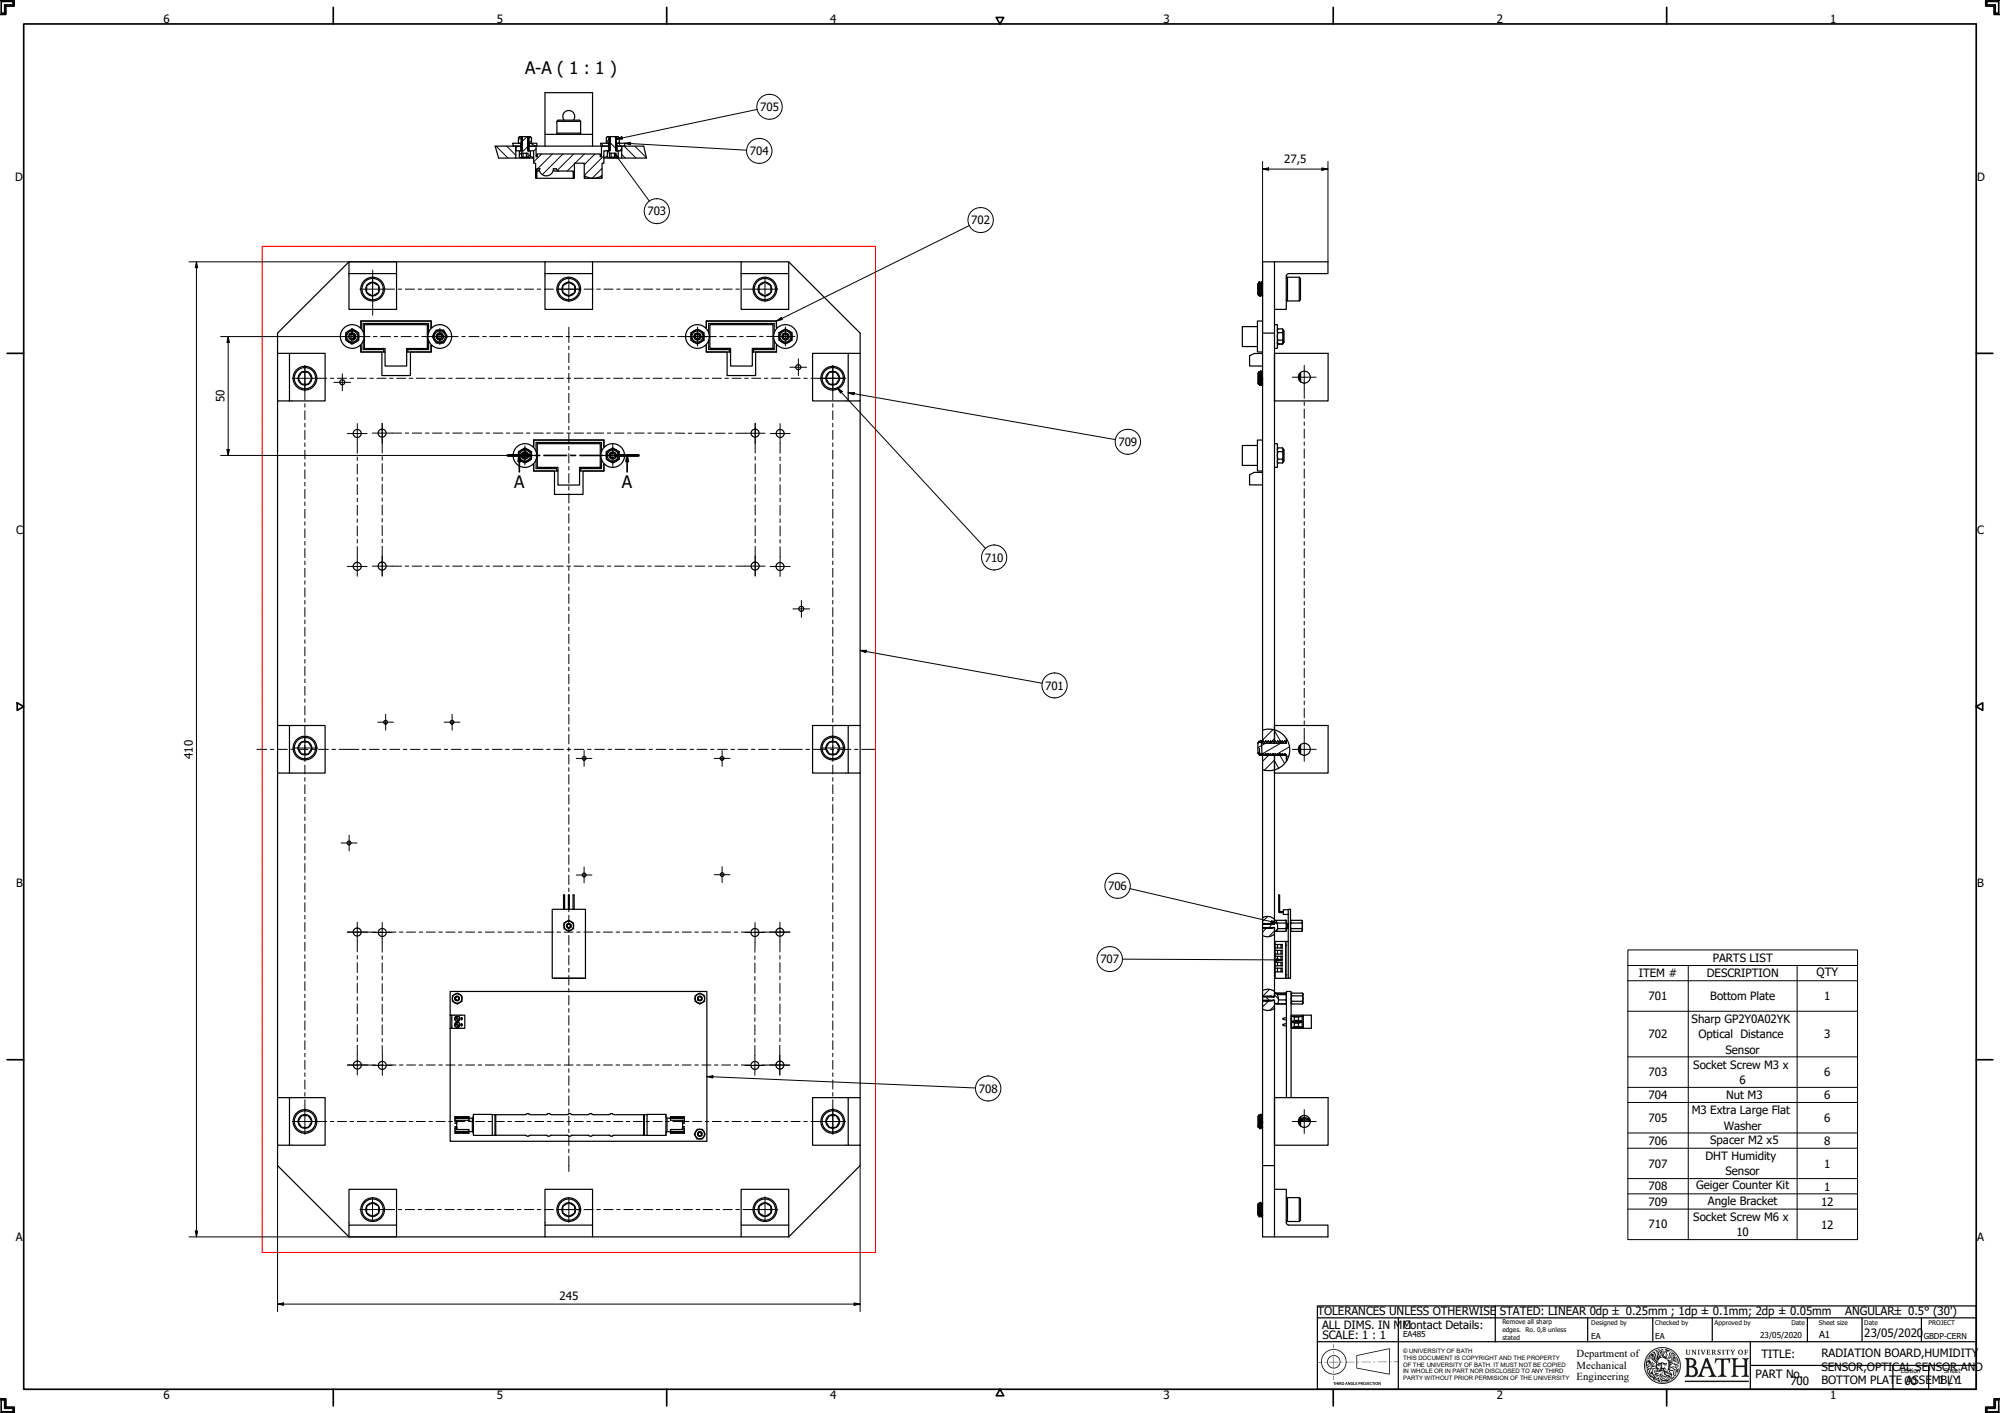
[picture p28: page 1]
PARTS LIST

ITEM # | DESCRIPTION | QTY

701 | Bottom Plate | 1

702 | Sharp GP2Y0A02YK Optical Distance Sensor | 3

703 | Socket Screw M3 x 6 | 6

704 | Nut M3 | 6
705 | M3 Extra Large Flat Washer | 6

706 | Spacer M2 x5 | 8
707 | DHT Humidity Sensor | 1

708 | Geiger Counter Kit | 1
709 | Angle Bracket | 12
710 | Socket Screw M6 x 10 | 12

TOLERANCES UNLESS OTHERWISE STATED: LINEAR 0dp  0.25mm ; 1dp ± 0.1mm; 2dp ± 0.05mm | ANGULAR 0.5° (30')
ALL DIMS. IN MM SCALE: 1 : 1 | Contact Details: EA485 | Remove all sharp edges. Ro. 0,8 unless stated | Designed by EA | Checked by EA | Approved by Date 23/05/2020 | Sheet size A1 | Date 23/05/2020 | PROJECT GBDP-CERN

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

RADIATION BOARD,HUMIDITY
SENSOR,OPTICAL SENSOR AND

PART No. BOTTOM PLATE ASSEMBLY 700 | Edition 00 | Sheet 1 / 1
