earabul-sudo/GBDP_CERN_Robot/Schematics_Drawings/pdf/20200523_RaspberryPiStackAssembly_EA_00.pdf

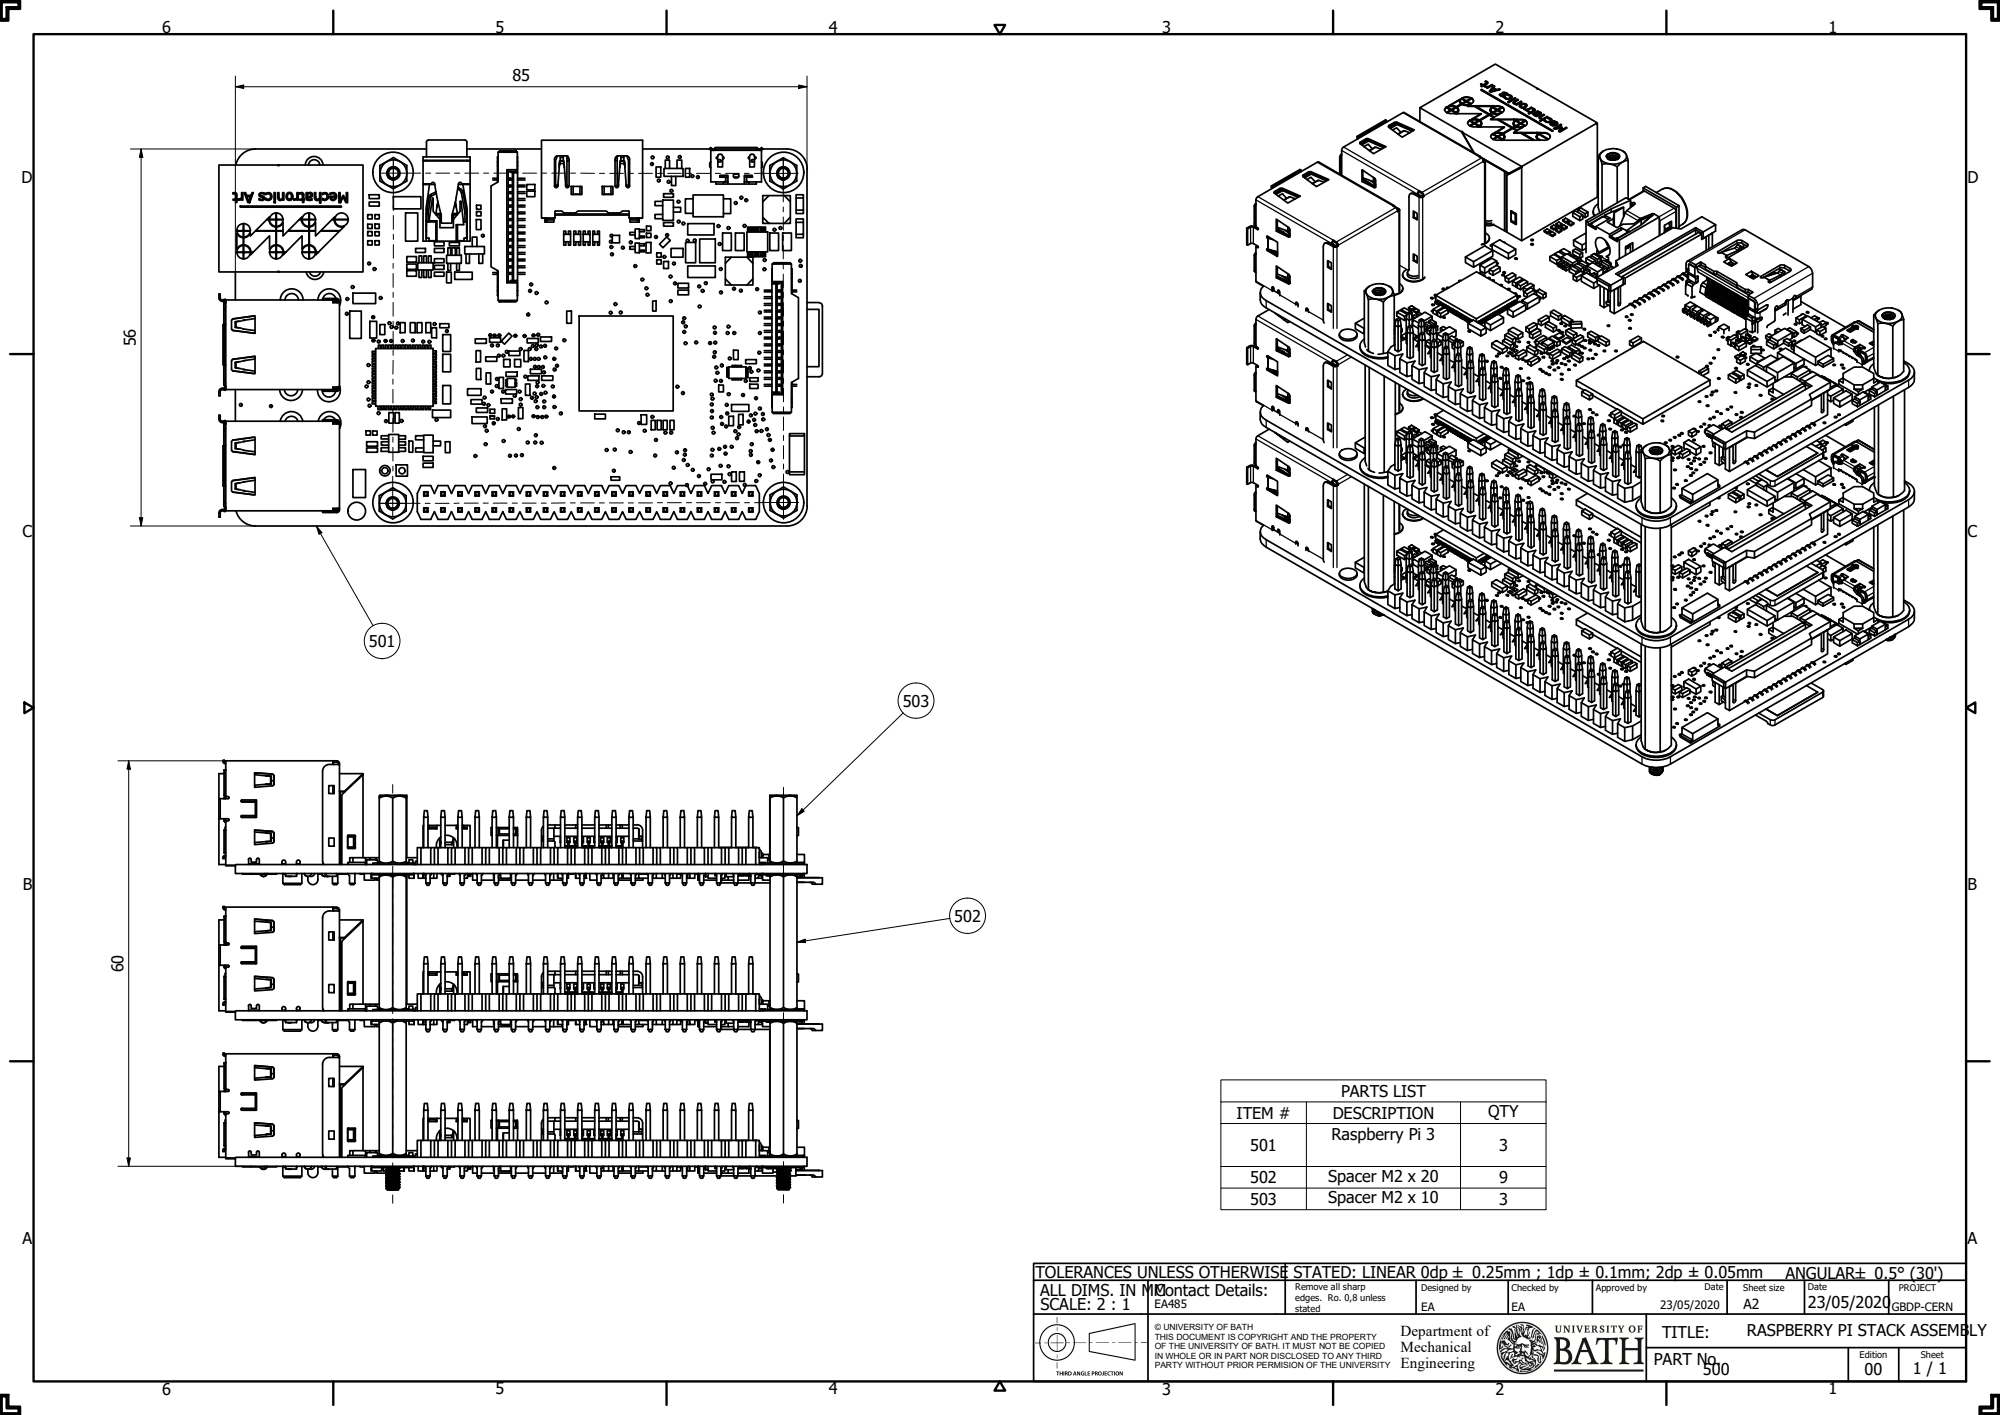
[picture p29: page 1]
Designed by; Checked by; Approved by; Date; Department of; SCALE: 2 : 1; Sheet size; PART No.; Contact Details:; TITLE:; RASPBERRY PI STACK ASSEMBLY; PARTS LIST; ITEM #; DESCRIPTION; QTY; Raspberry Pi 3; Spacer M2 x 20; Spacer M2 x 10

ALL DIMS. IN MM

Remove all sharp
edges. Ro. 0,8 unless
stated

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
