earabul-sudo/GBDP_CERN_Robot/Schematics_Drawings/pdf/20200523_RobotFrameUltrasonicSensorandLEDStripAssembly.pdf

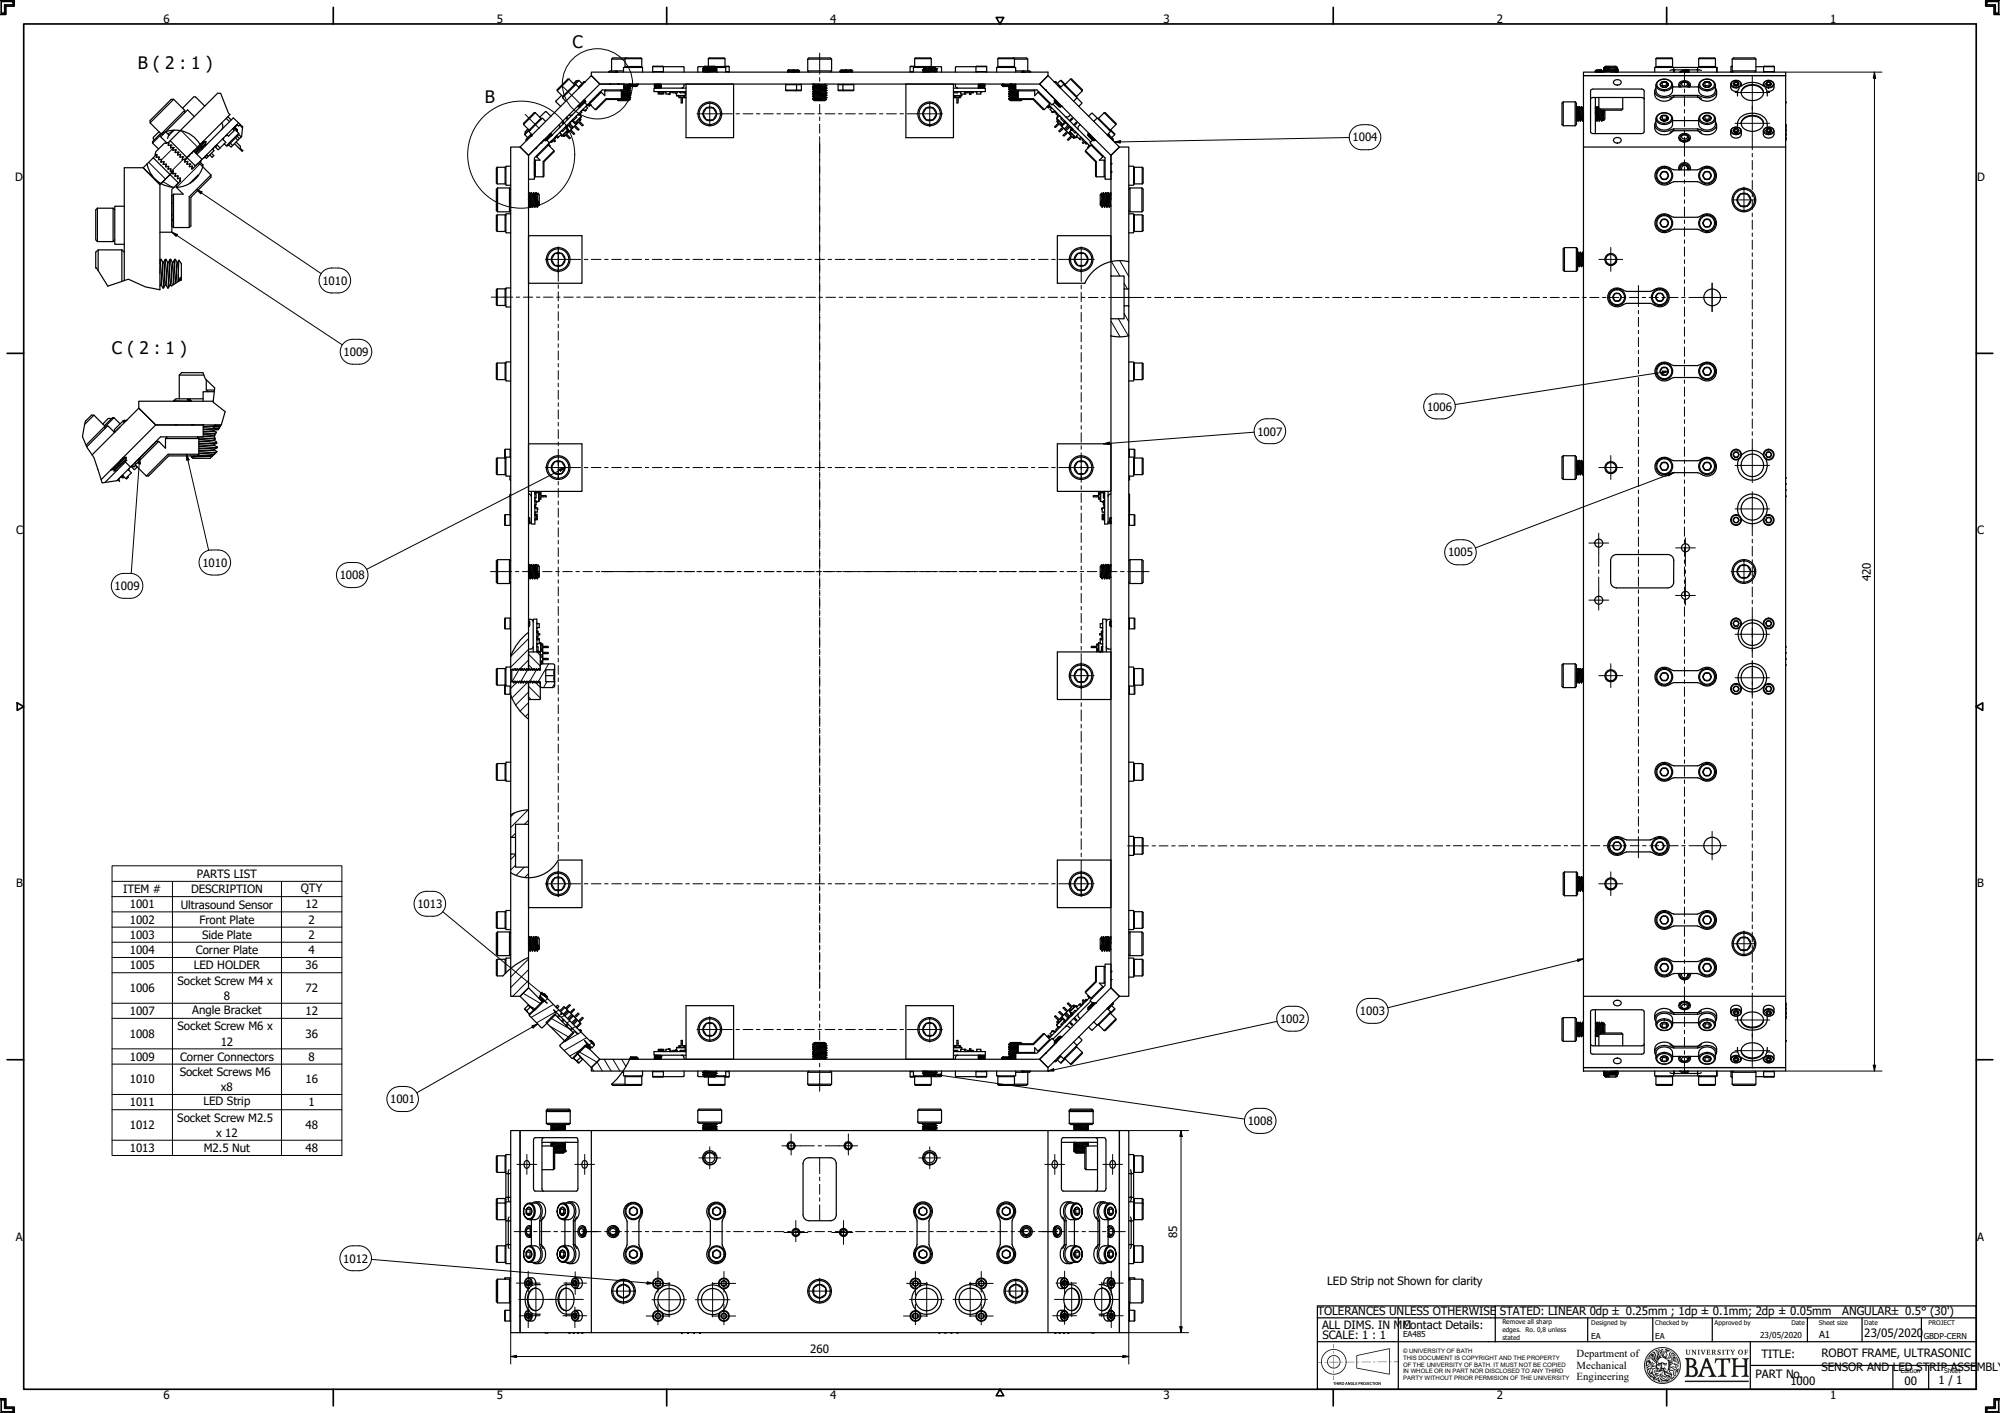
[picture p30: page 1]
Designed by; Checked by; Approved by; Date; Department of; SCALE: 1 : 1; Sheet size; PART No.; Contact Details:; PARTS LIST; ITEM #; DESCRIPTION; QTY; Ultrasound Sensor; Front Plate; Side Plate; Corner Plate; LED HOLDER; Socket Screw M4 x; Angle Bracket; Socket Screw M6 x; Corner Connectors; Socket Screws M6; LED Strip; Socket Screw M2.5 x 12; M2.5 Nut

LED Strip not Shown for clarity

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

Remove all sharp
edges. Ro. 0,8 unless
stated

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

ROBOT FRAME, ULTRASONIC
SENSOR AND LED STRIP ASSEMBLY
