earabul-sudo/GBDP_CERN_Robot/Schematics_Drawings/pdf/20200406_FrontBoard_EA_04_02.pdf

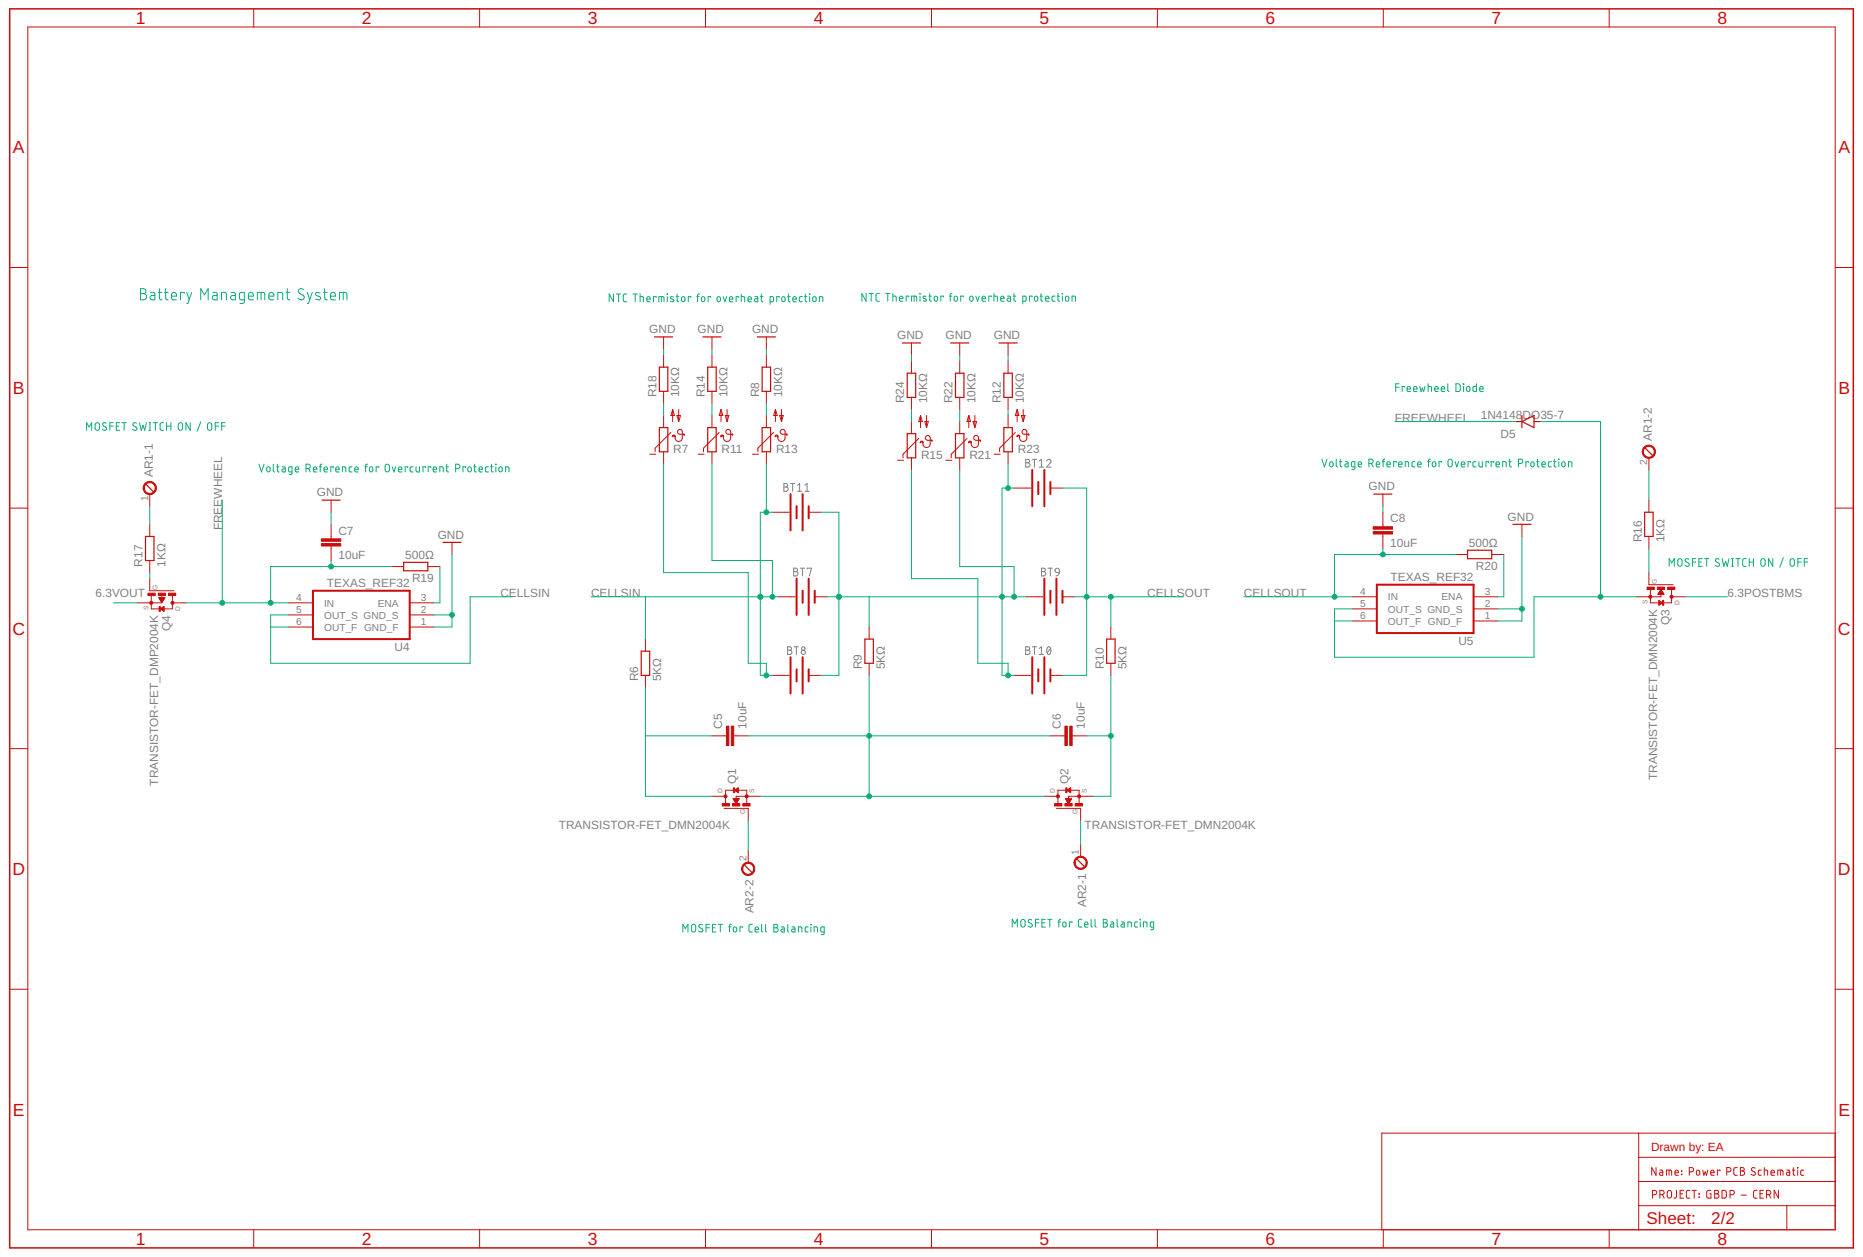
[picture p31: page 1]
