earabul-sudo/GBDP_CERN_Robot/Schematics_Drawings/pdf/20200406_FrontBoard_EA_04_Board.pdf

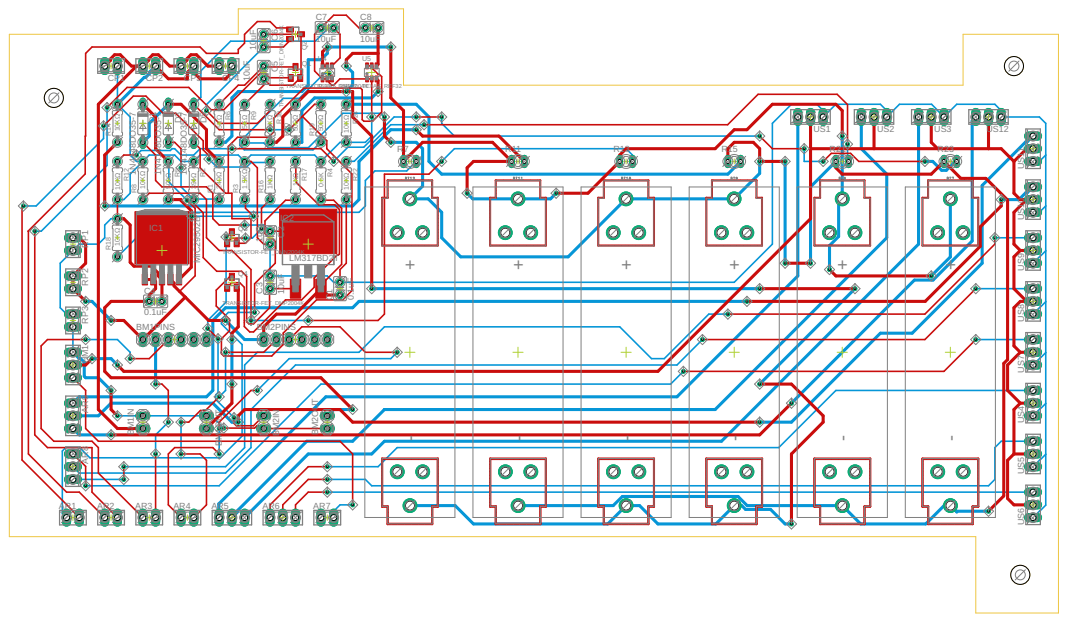
[picture p32: page 1]

+ - + - + - + - + - + - R4 C1 C2 C3 R2 R1 D1 D3 IC2 RP1 US1 US2 US3 US4 US5 US6AR6 HM1 AR5 AR7 BM1PINS BM1IN BM1OUT BM2IN BM2OUT BM2PINS AR3 AR4 C4 R3 R5 RP2 RP3 IC1 R16 Q3 Q4 R17 D5 U4 R19 C7 U5 R20 C8 R6 R9 R10 C5 C6 Q1Q2 CP1 CP2 CP3 AR1 AR2 CP4 US7 US8 US9 AR8 US10 US11 US12 AR9 R8 R12 R14 R18 R22 R24 R7 R11 R13 R15 R21 R23 0.5K 0.1uF 1uF 10uF 394Ω 240 1Ω N4148DO35-7 1N4148DO35-7 LM317BD2T 0.1uF 1.5KΩ 500Ω MIC29502BT 1KΩ TRANSISTOR-FET_DMN2004K TRANSISTOR-FET_DMP2004K1KΩ1N4148DO35-7 TEXAS_REF32 500Ω 10uF TEXAS_REF32 500Ω 10uF 5KΩ 5KΩ 5KΩ 10uF 10uF TRANSISTOR-FET_DMN2004K TRANSISTOR-FET_DMN2004K 10KΩ 10KΩ 10KΩ 10KΩ 10KΩ 10KΩ
