earabul-sudo/GBDP_CERN_Robot/Schematics_Drawings/Grove-Optical_Rotary_Encoder-TCUT1600X01/Grove - Optical Rotary Encoder(TCUT1600X01).brd

## EAGLE design Schematics_Drawings/Grove-Optical_Rotary_Encoder-TCUT1600X01/Grove - Optical Rotary Encoder(TCUT1600X01).brd (2020-06-28)

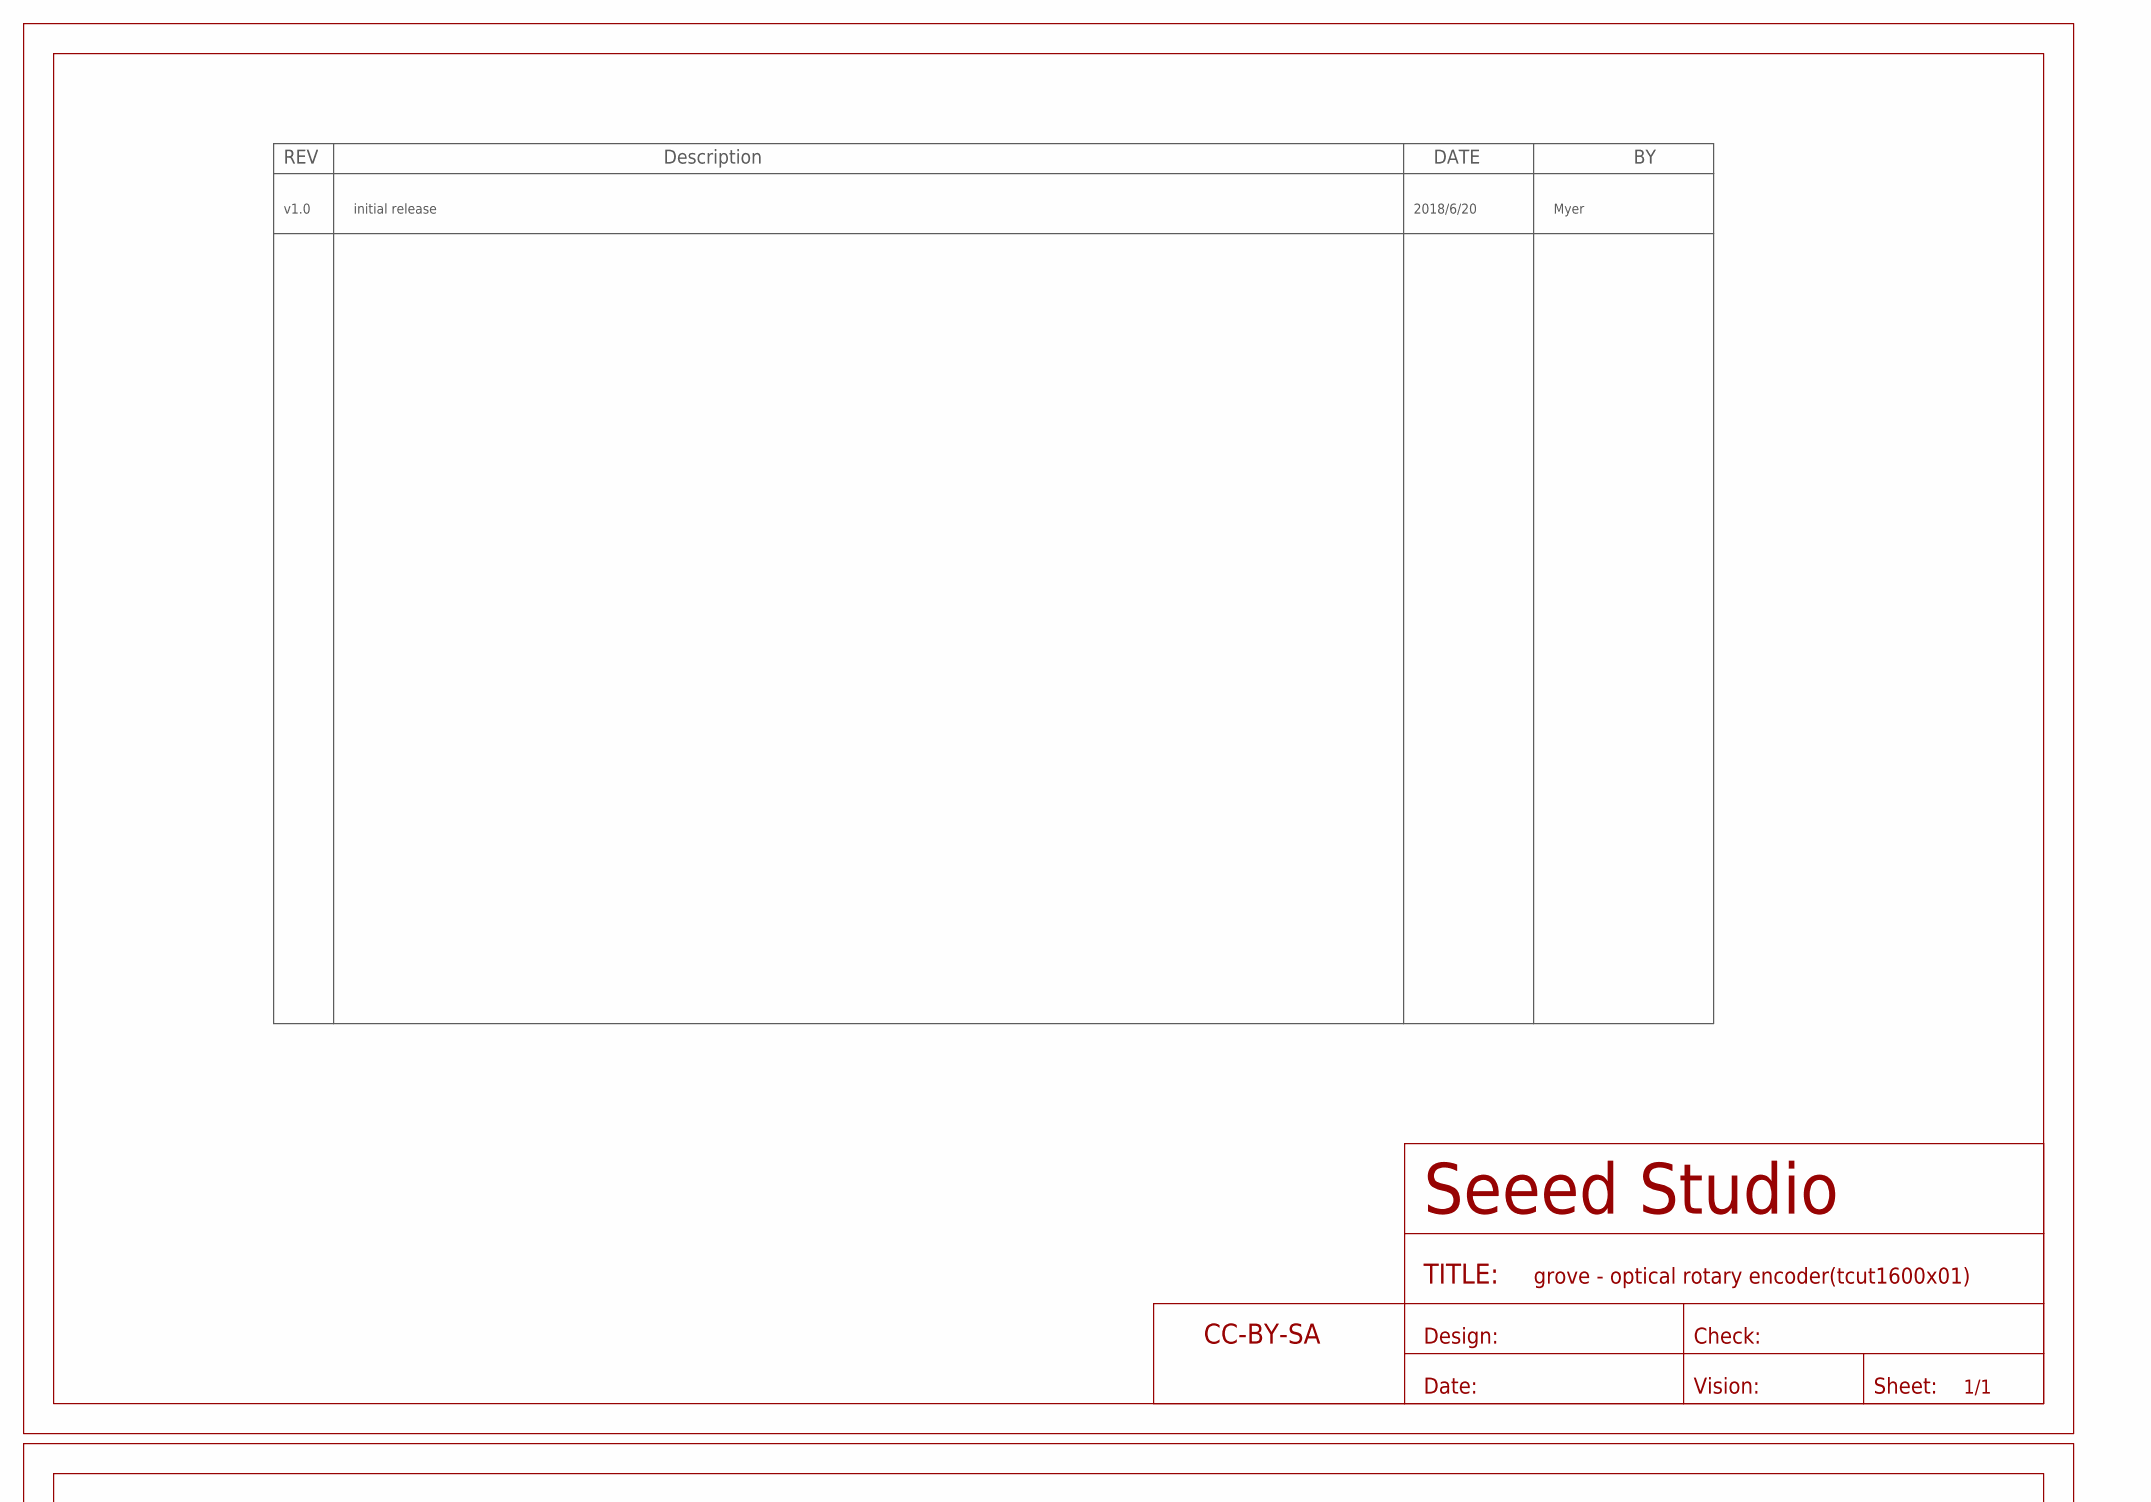
[picture p33: schematic Grove - Optical Rotary Encoder(TCUT1600X01).sch, part in row 1, column 1]

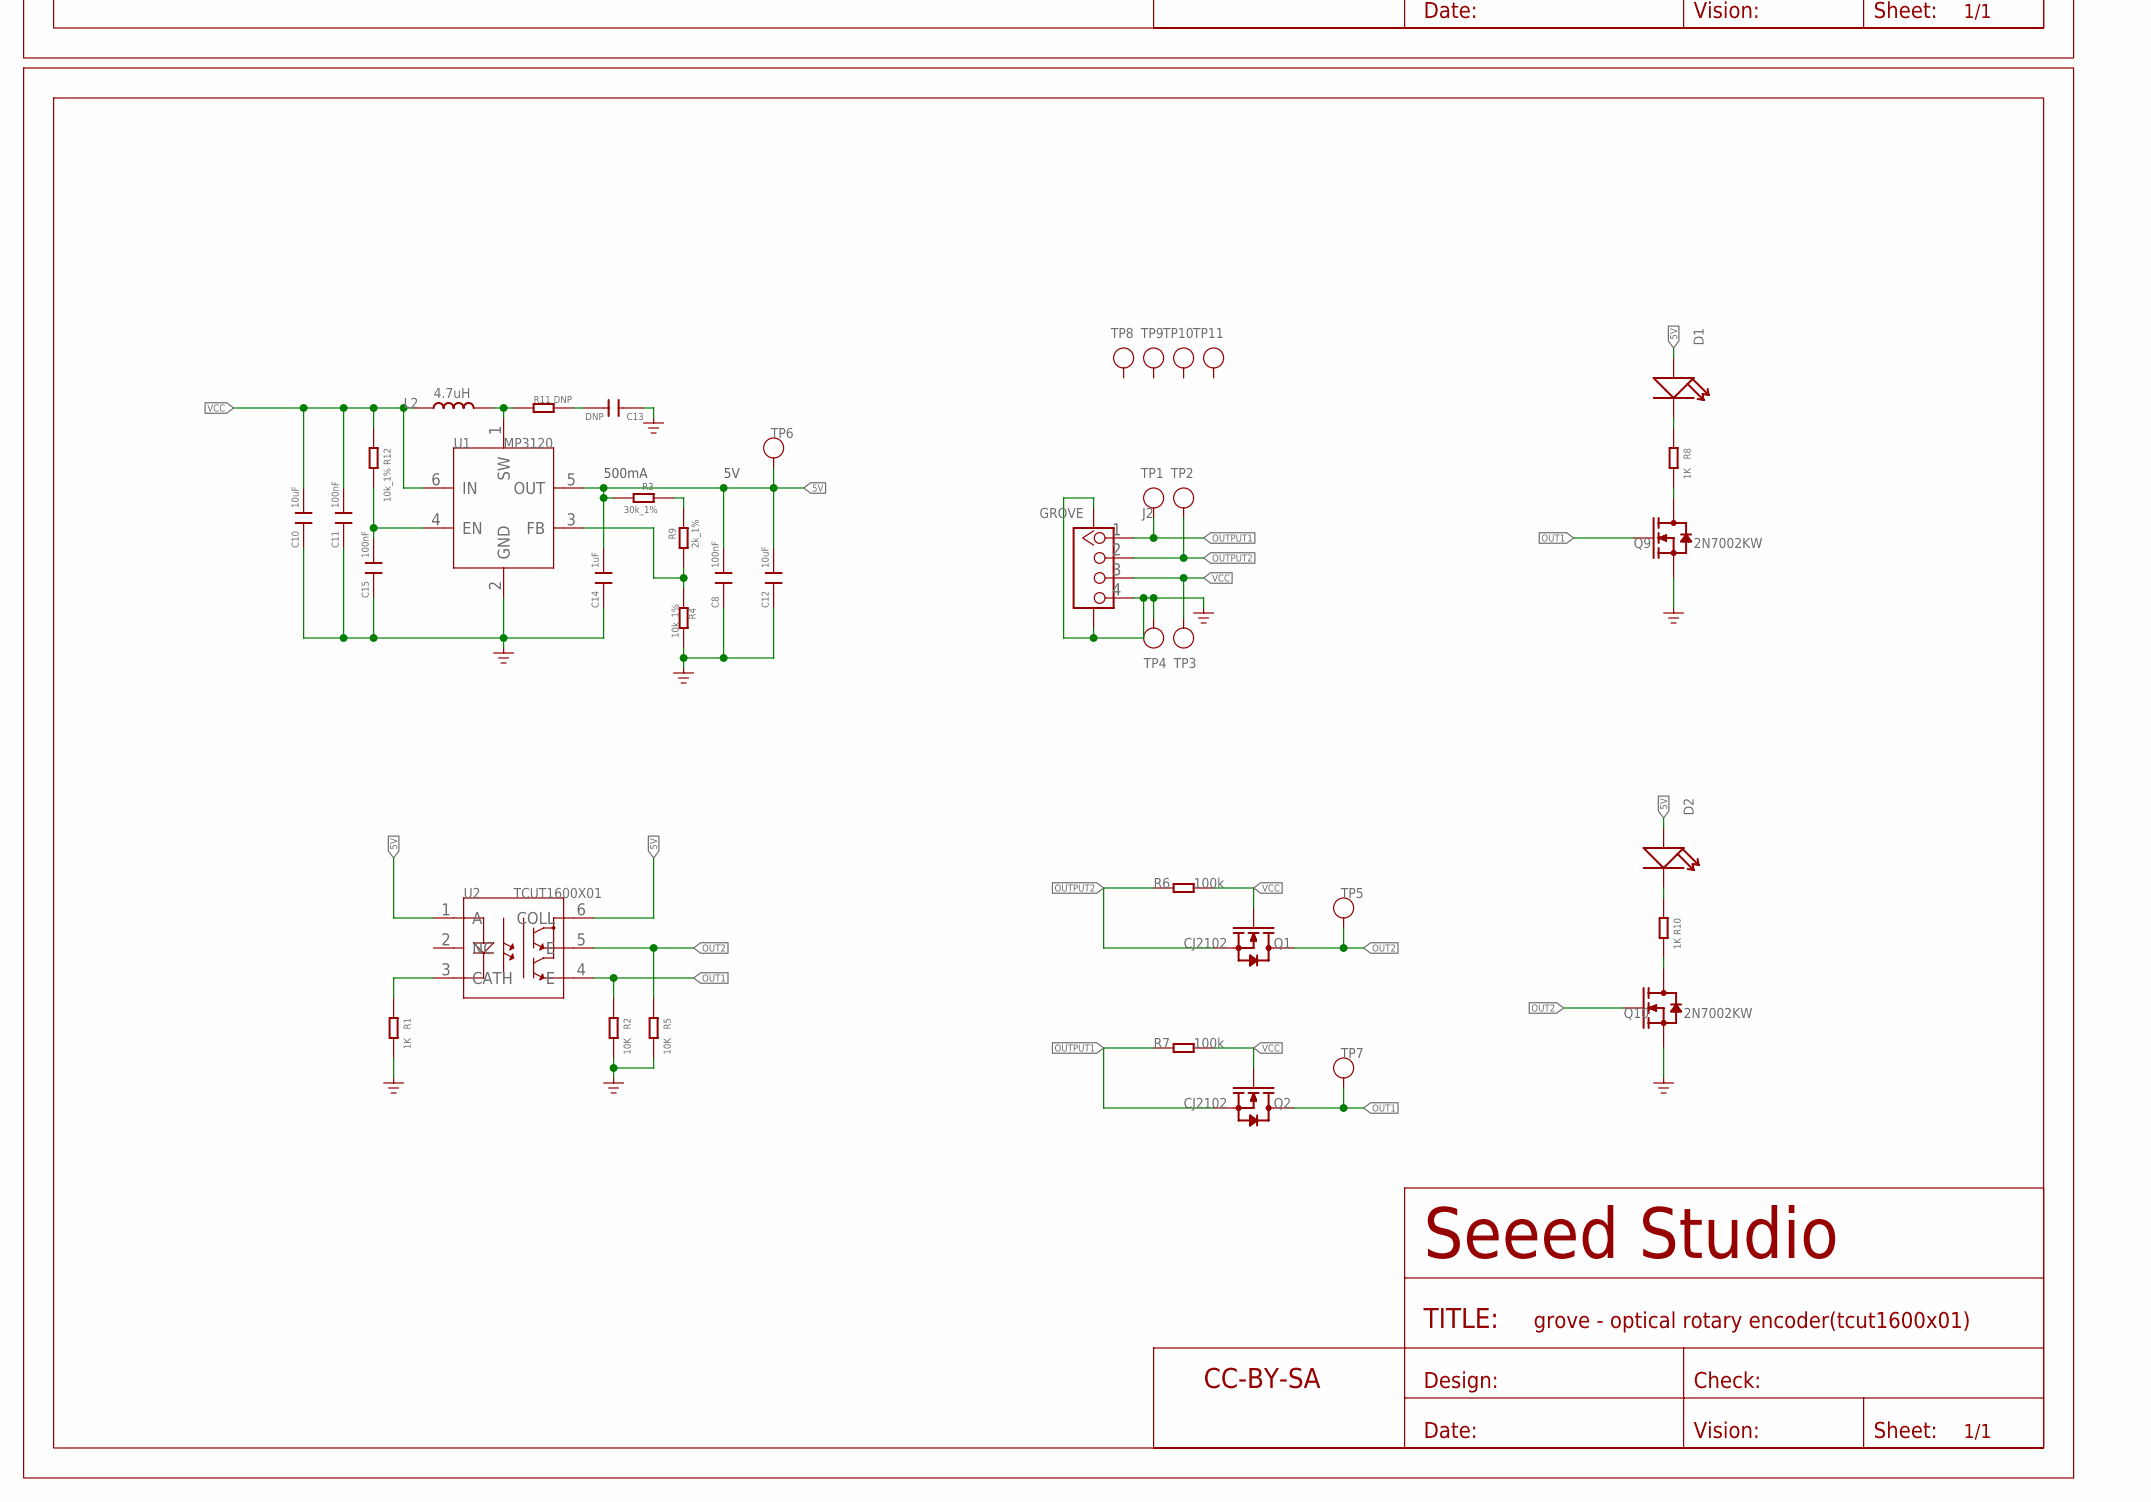
[picture p34: schematic Grove - Optical Rotary Encoder(TCUT1600X01).sch, part in row 2, column 1]

Parts:
C8, C11, C15: 100nF; C0603
C10, C12: 10uF; C0603
C13: DNP; C0603
C14: 1uF; C0603
D1, D2: LED'0603'; LED-0603
FR1: SEEEDSTUDIO-OPEN-SCH-FRAME; SEEEDSTUDIO-PCB-FRAME
J2: GROVE; HW4-SMD-2.0
L2: 4.7uH; L2016
Q1, Q2: CJ2102; SOT-23@1
Q9, Q10: 2N7002KW; SOT-323
R1, R8, R10: 1K; R0603
R2, R5: 10K; R0603
R3: 30k_1%; R0603
R4, R12: 10k_1%; R0603
R6, R7: 100k; R0603
R9: 2k_1%; R0603
R11: DNP; R0603
TP1, TP2, TP3, TP4, TP5, TP6, TP7, TP8, TP9, TP10, TP11: TEST-POINT'4545'; TP-D45MIL
U1: MP3120; SOT-23-6
U2: TCUT1600X01; SNR6-1.4-5.5X4X5.7MM
U$4: SEEEDSTUDIO-OPEN-SCH-FRAME; SEEEDSTUDIO-PCB-FRAME

Connections:
5V: C8.2, C12.2, C14.2, D1.+, D2.+, R3.2, TP6.T, U1.5 (OUT), U2.1 (A), U2.6 (COLL)
GND: C8.1, C10.1, C11.1, C12.1, C13.1, C14.1, C15.1, J2.4, J2.SS1, J2.SS2, Q9.2 (S), Q10.2 (S), R1.2, R2.2, R4.1, R5.2, TP4.T, U1.2 (GND)
unnamed: R1.1, U2.3 (CATH)
unnamed: R4.2, R9.2, U1.3 (FB)
unnamed: R3.1, R9.1
unnamed: L2.2, R11.1, U1.1 (SW)
unnamed: C13.2, R11.2
unnamed: C15.2, R12.2, U1.4 (EN)
unnamed: Q9.3 (D), R8.2
unnamed: D1.-, R8.1
unnamed: Q10.3 (D), R10.2
unnamed: D2.-, R10.1
OUT1: Q2.3 (D), Q9.1 (G), R2.1, TP7.T, U2.4 (E)
OUT2: Q1.3 (D), Q10.1 (G), R5.1, TP5.T, U2.5 (E)
OUTPUT1: J2.1, Q2.2 (S), R7.1, TP1.T
OUTPUT2: J2.2, Q1.2 (S), R6.1, TP2.T
VCC: C10.2, C11.2, J2.3, L2.1, Q1.1 (G), Q2.1 (G), R6.2, R7.2, R12.1, TP3.T, U1.6 (IN)

Notes on the sheet:
500mA
initial release
v1.0
2018/6/20
Myer

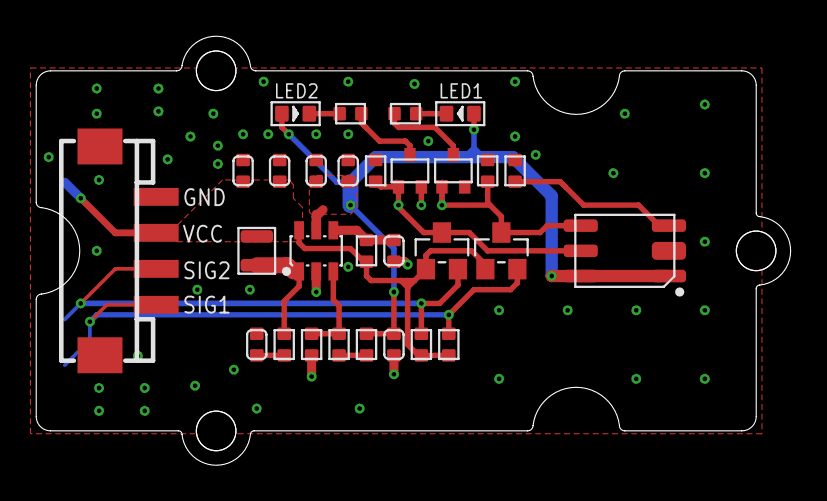
[picture p35: board Grove - Optical Rotary Encoder(TCUT1600X01).brd from above]

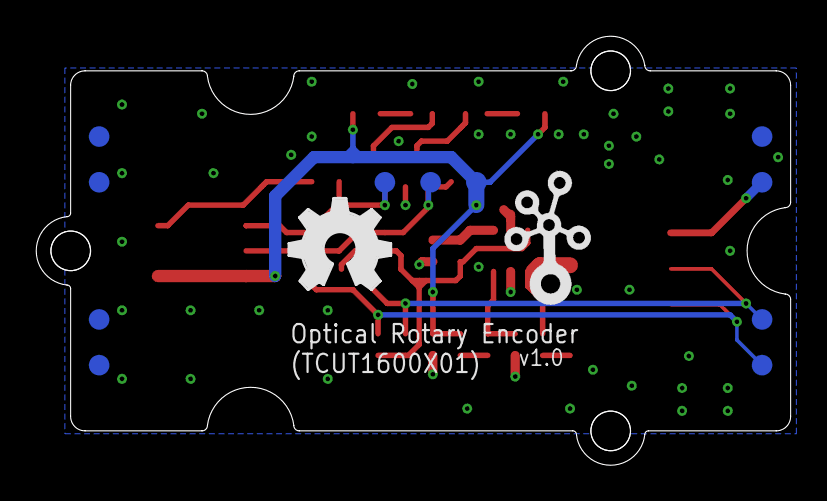
[picture p36: board Grove - Optical Rotary Encoder(TCUT1600X01).brd from below]

Board: 2 copper layers, 41.9 x 23.8 mm, 45 parts (13 on the bottom side), 17 nets.

Other parts of the board:
U$10: GROVE-1*2-TEST-PLATFORM-TOP
U$11: TWIGLOGO
U$13: OSHW_FILLX200_NOTEXT
