earabul-sudo/GBDP_CERN_Robot/Schematics_Drawings/20200406_FrontBoard_EA_04.brd

## EAGLE design Schematics_Drawings/20200406_FrontBoard_EA_04.brd (2020-06-28)

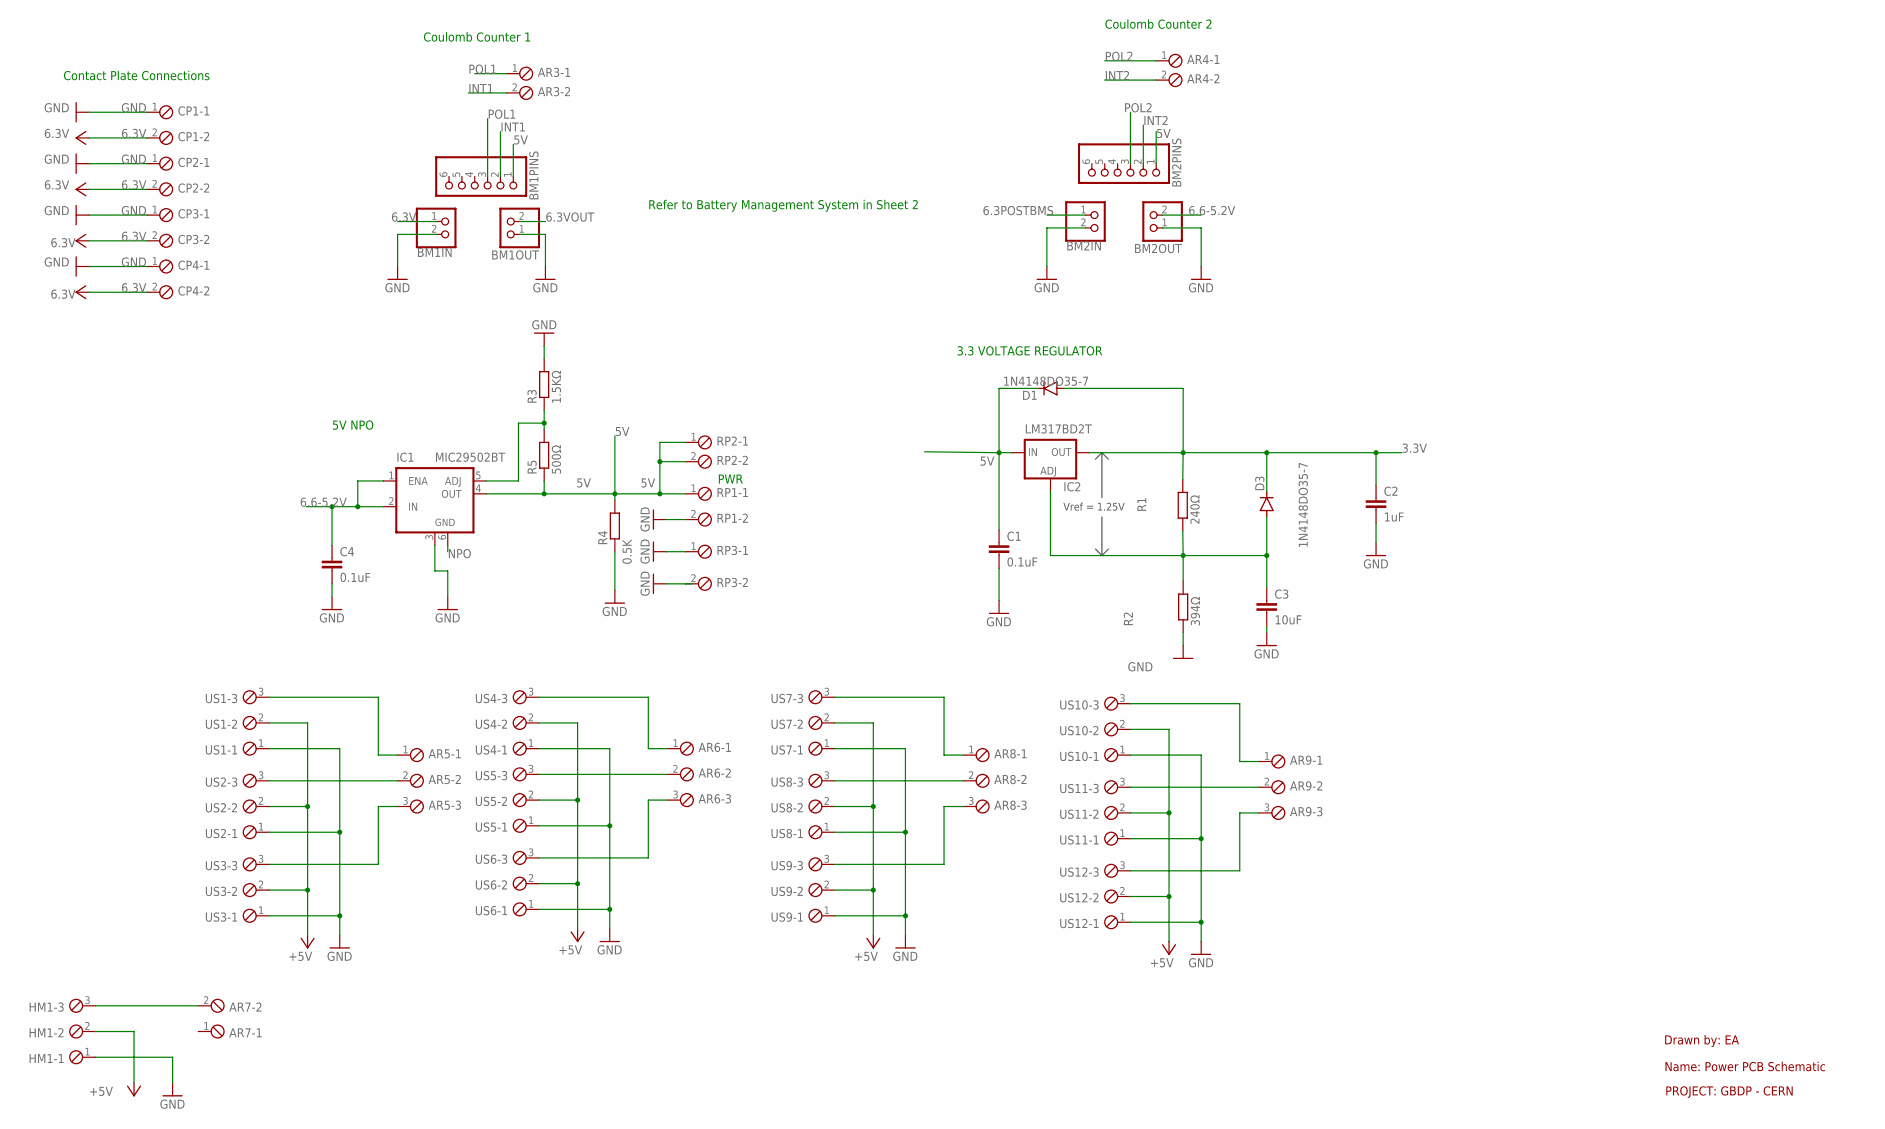
[picture p37: schematic 20200406_FrontBoard_EA_04.sch, sheet 1]

Parts:
AR3, AR4, AR7: MPT2; 2POL254
AR5, AR6, AR8, AR9: MPT3; 3POL254
BM1IN, BM1OUT, BM2IN, BM2OUT: PINHD-1X2; 1X02
BM1PINS, BM2PINS: PINHD-1X6; 1X06
C1, C4: 0.1uF; C025-025X050
C2: 1uF; C025-025X050
C3: 10uF; C025-025X050
CP1, CP2, CP3, CP4: MPT2; 2POL254
D1, D3: 1N4148DO35-7; DO35-7
HM1: MPT3; 3POL254
IC1: MIC29502BT; TO263-5
IC2: LM317BD2T; D2PACK
R1: 240Ω; 0204/7
R2: 394Ω; 0204/7
R3: 1.5KΩ; 0204/7
R4: 0.5K; 0204/7
R5: 500Ω; 0204/7
RP1, RP2, RP3: MPT2; 2POL254
US1, US2, US3, US4, US5, US6, US7, US8, US9, US10, US11, US12: MPT3; 3POL254

Connections:
3.3V: C2.1, D1.A, D3.C, IC2.2 (OUT), R1.2
5V: BM1PINS.1, BM2PINS.1, C1.1, D1.C, IC1.4 (OUT), IC2.3 (IN), R4.2, R5.1, RP1.1, RP2.1, RP2.2
6.3POSTBMS: BM2IN.1; also elsewhere on the board
6.3V: BM1IN.1, CP1.2, CP2.2, CP3.2, CP4.2
6.3VOUT: BM1OUT.2; also elsewhere on the board
6.6-5.2V: BM2OUT.2, C4.1, IC1.1 (ENA), IC1.2 (IN)
+5V: HM1.2, US1.2, US2.2, US3.2, US4.2, US5.2, US6.2, US7.2, US8.2, US9.2, US10.2, US11.2, US12.2
GND: BM1IN.2, BM1OUT.1, BM2IN.2, BM2OUT.1, C1.2, C2.2, C3.2, C4.2, CP1.1, CP2.1, CP3.1, CP4.1, HM1.1, IC1.3 (GND), R2.1, R3.2, R4.1, RP1.2, RP3.1, RP3.2, US1.1, US2.1, US3.1, US4.1, US5.1, US6.1, US7.1, US8.1, US9.1, US10.1, US11.1, US12.1; also elsewhere on the board
INT1: AR3.2, BM1PINS.2
INT2: AR4.2, BM2PINS.2
unnamed: C3.1, D3.A, IC2.1 (ADJ), R1.1, R2.2
unnamed: AR8.3, US9.3
unnamed: IC1.5 (ADJ), R3.1, R5.2
unnamed: AR5.3, US3.3
unnamed: AR5.2, US2.3
unnamed: AR5.1, US1.3
unnamed: AR6.3, US6.3
unnamed: AR6.2, US5.3
unnamed: AR6.1, US4.3
unnamed: AR7.2, HM1.3
unnamed: AR8.2, US8.3
unnamed: AR8.1, US7.3
unnamed: AR9.3, US12.3
unnamed: AR9.2, US11.3
unnamed: AR9.1, US10.3
NPO: IC1.6 (GND)
POL1: AR3.1, BM1PINS.3
POL2: AR4.1, BM2PINS.3

Notes on the sheet:
Vref = 1.25V
PWR
Contact Plate Connections
Coulomb Counter 1
Coulomb Counter 2
Refer to Battery Management System in Sheet 2
5V NPO
3.3 VOLTAGE REGULATOR
Drawn by: EA
Name: Power PCB Schematic
PROJECT: GBDP - CERN

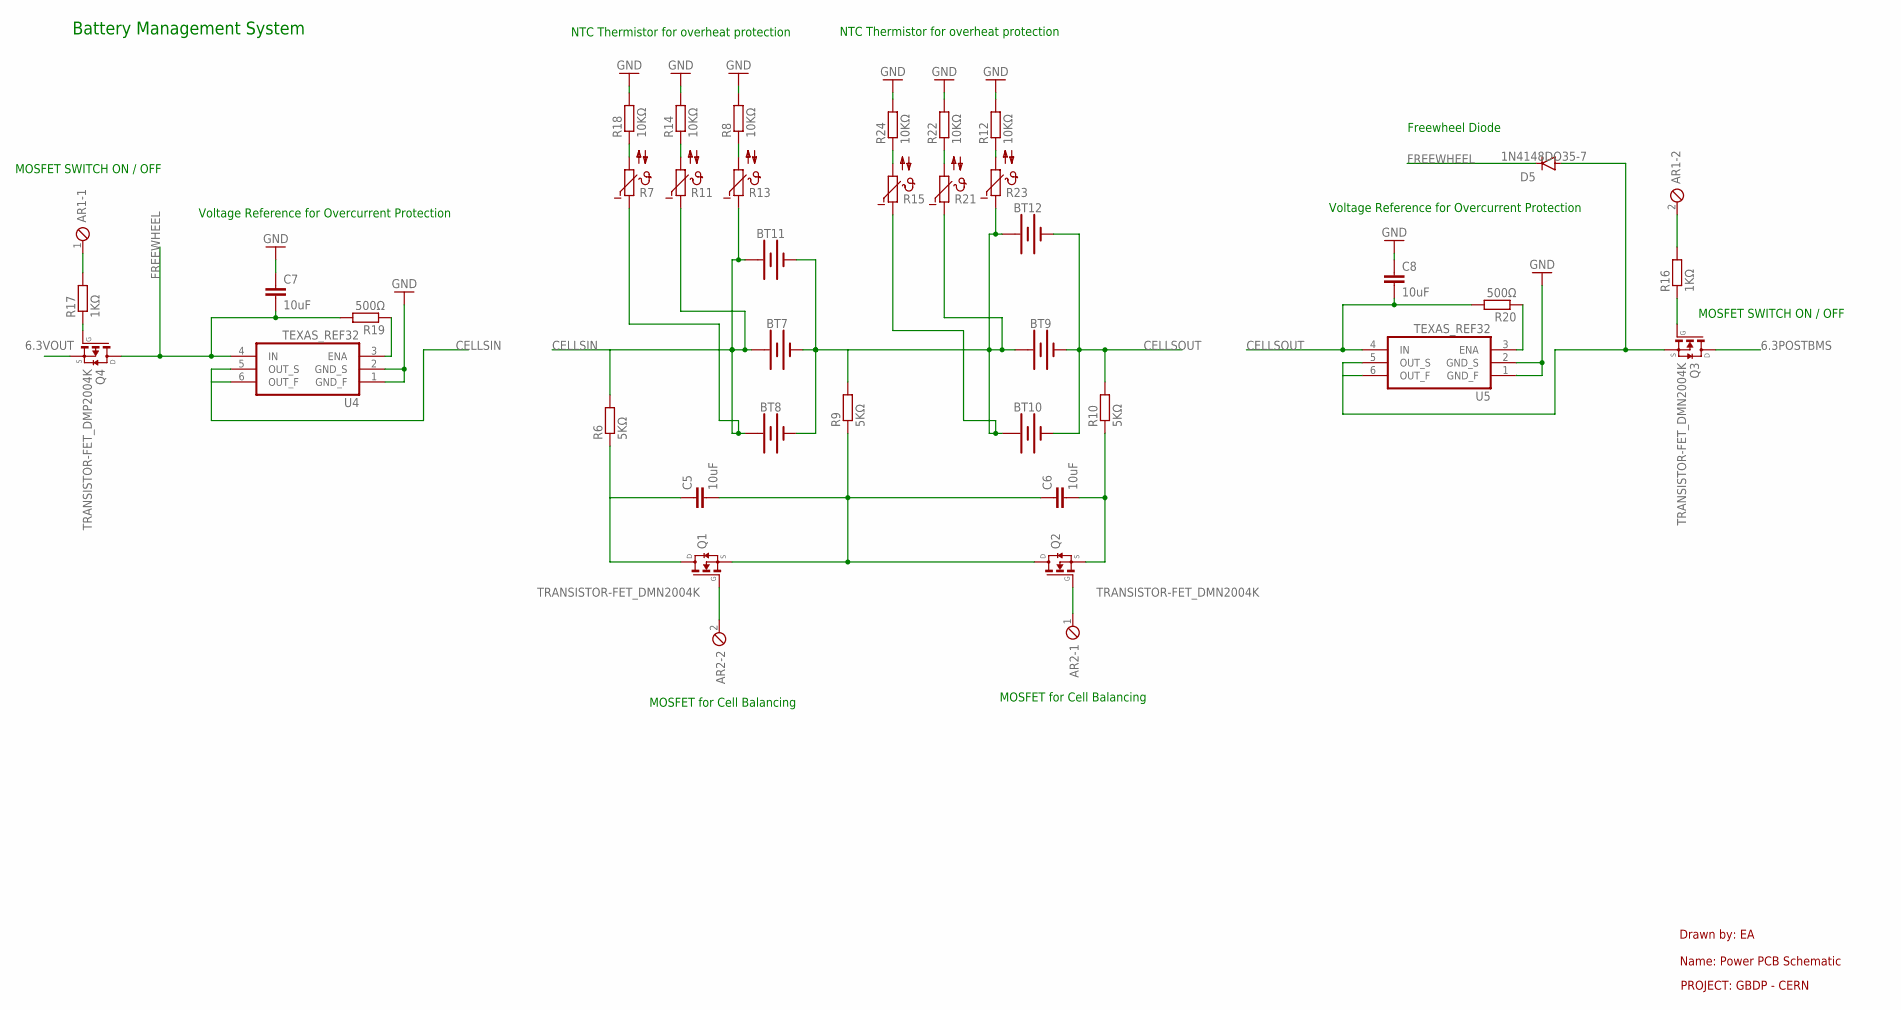
[picture p38: schematic 20200406_FrontBoard_EA_04.sch, sheet 2]

Parts:
AR1, AR2: MPT2; 2POL254
BT7, BT8, BT9, BT10, BT11, BT12: BATTERY-18650; BATTERY_18650-HOLDER
C5, C6, C7, C8: 10uF; C025-025X050
D5: 1N4148DO35-7; DO35-7
Q1, Q2, Q3: TRANSISTOR-FET_DMN2004K; TRANSISTOR-FET_SOT23
Q4: TRANSISTOR-FET_DMP2004K; TRANSISTOR-FET_SOT23
R6, R9, R10: 5KΩ; 0204/7
R7, R11, R13, R15, R21, R23: NTC640; P640
R8, R12, R14, R18, R22, R24: 10KΩ; 0204/7
R16, R17: 1KΩ; 0204/7
R19, R20: 500Ω; 0204/7
U4, U5: TEXAS_REF32; TEXAS_SOT23-6

Connections:
6.3POSTBMS: Q3.3 (D); also elsewhere on the board
6.3VOUT: Q4.2 (S); also elsewhere on the board
CELLSIN: BT7.PWR@1 (+), BT8.PWR@1 (+), BT11.PWR@1 (+), R6.2, R7.1, R11.1, R13.1, U4.5 (OUT_S), U4.6 (OUT_F)
CELLSOUT: BT9.GND@1 (-), BT10.GND@1 (-), BT12.GND@1 (-), C8.2, R10.2, R20.2, U5.4 (IN)
FREEWHEEL: C7.2, D5.C, Q4.3 (D), R19.2, U4.4 (IN)
GND: C7.1, C8.1, R8.2, R12.2, R14.2, R18.2, R22.2, R24.2, U4.1 (GND_F), U4.2 (GND_S), U5.1 (GND_F), U5.2 (GND_S); also elsewhere on the board
unnamed: C5.2, C6.1, Q1.2 (S), Q2.3 (D), R9.1
unnamed: C6.2, Q2.2 (S), R10.1
unnamed: AR2.2, Q1.1 (G)
unnamed: AR2.1, Q2.1 (G)
unnamed: AR1.2, R16.2
unnamed: D5.A, Q3.2 (S), U5.5 (OUT_S), U5.6 (OUT_F)
unnamed: Q3.1 (G), R16.1
unnamed: Q4.1 (G), R17.1
unnamed: AR1.1, R17.2
unnamed: R8.1, R13.2
unnamed: R21.2, R22.1
unnamed: C5.1, Q1.3 (D), R6.1
unnamed: R19.1, U4.3 (ENA)
unnamed: R12.1, R23.2
unnamed: R20.1, U5.3 (ENA)
unnamed: R11.2, R14.1
unnamed: R7.2, R18.1
unnamed: BT7.GND@1 (-), BT8.GND@1 (-), BT9.PWR@1 (+), BT10.PWR@1 (+), BT11.GND@1 (-), BT12.PWR@1 (+), R9.2, R15.1, R21.1, R23.1
unnamed: R15.2, R24.1

Notes on the sheet:
Drawn by: EA
Name: Power PCB Schematic
PROJECT: GBDP - CERN
MOSFET SWITCH ON / OFF
Freewheel Diode
NTC Thermistor for overheat protection
MOSFET for Cell Balancing
Voltage Reference for Overcurrent Protection
Battery Management System

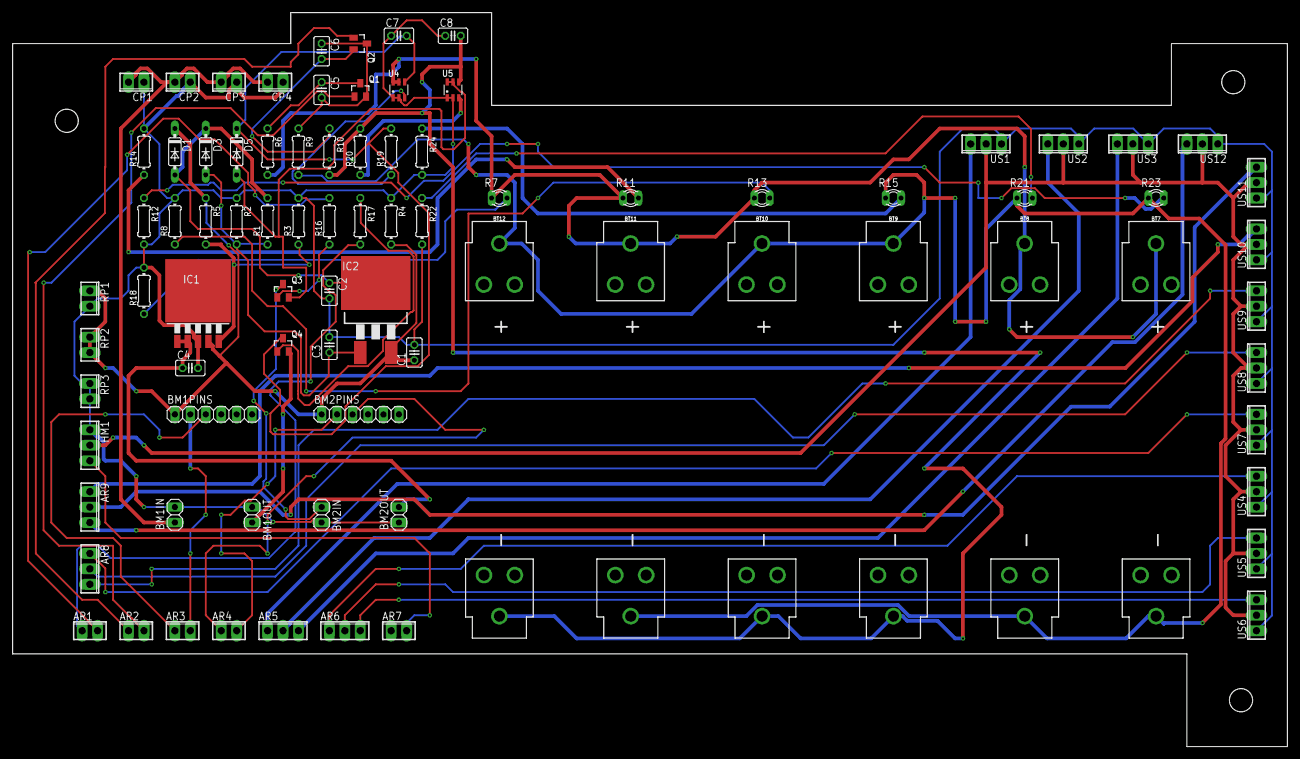
[picture p39: board 20200406_FrontBoard_EA_04.brd from above]

Board: 2 copper layers, 209.6 x 120.7 mm, 84 parts (0 on the bottom side), 49 nets.
