earabul-sudo/GBDP_CERN_Robot/Schematics_Drawings/LTC4150_Coulomb_Counter_BOB-master/hardware/LTC4150_BOB.brd

## EAGLE design Schematics_Drawings/LTC4150_Coulomb_Counter_BOB-master/hardware/LTC4150_BOB.brd (2020-06-28)

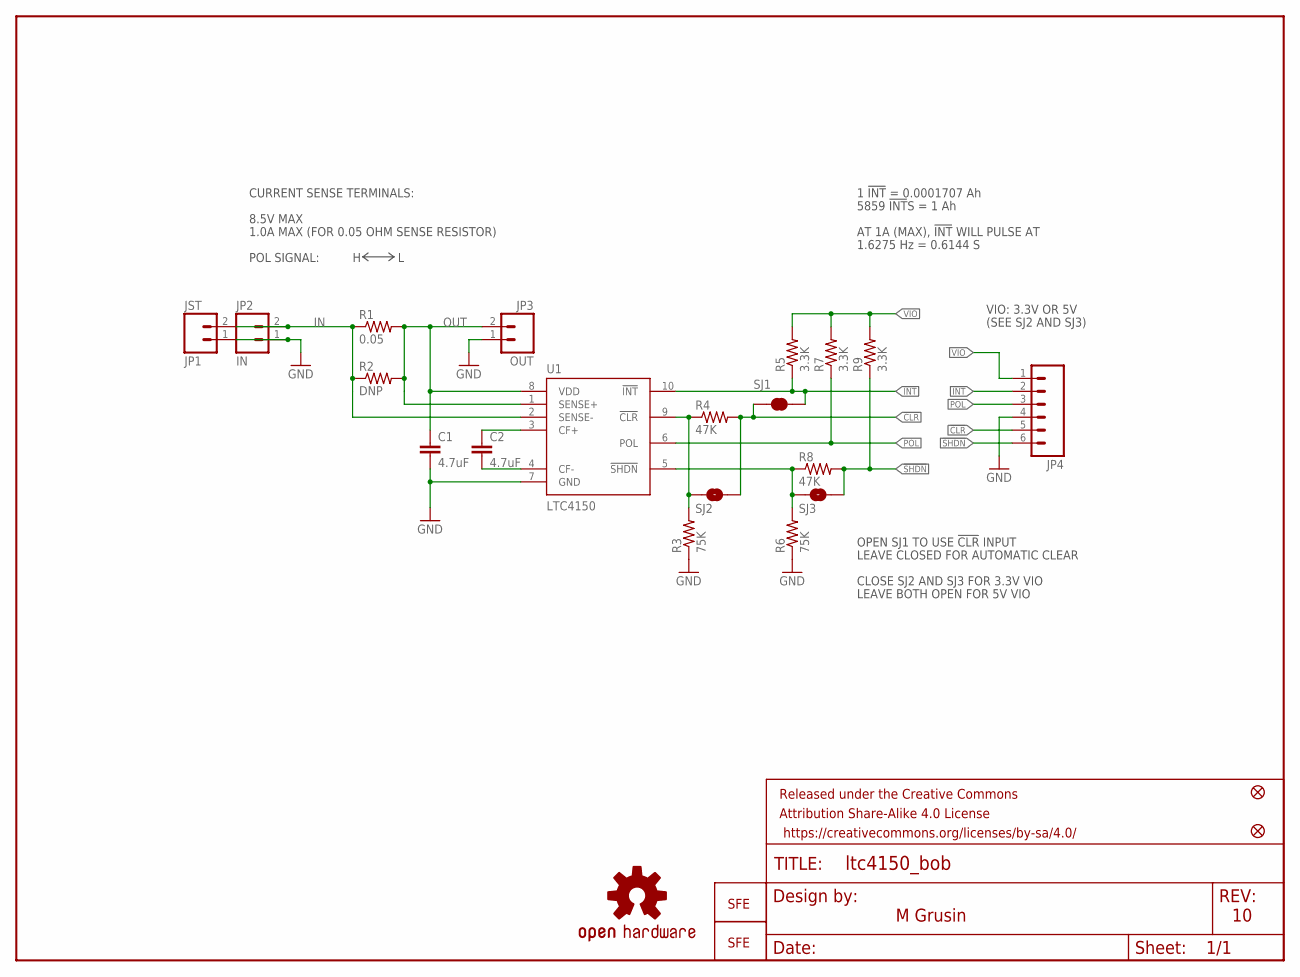
[picture p40: schematic LTC4150_BOB.sch]

Parts:
C1, C2: 4.7uF; 0603-CAP
FID1, FID2: FIDUCIAL1X2; FIDUCIAL-1X2
FRAME1: FRAME-LETTER; CREATIVE_COMMONS
JP1: JST; JST-2-SMD
JP2: IN; 1X02
JP3: OUT; 1X02
JP4: M06SIP; 1X06
LOGO1: OSHW-LOGOS; OSHW-LOGO-S
LOGO2: LOGO-SFENW2; SFE-NEW-WEB
LOGO3: LOGO-SFESK; SFE-LOGO-FLAME
R1: 0.05; 1206
R2: DNP; AXIAL-0.3
R3, R6: 75K; 0603-RES
R4, R8: 47K; 0603-RES
R5, R7, R9: 3.3K; 0603-RES
SJ1: SOLDERJUMPERNC; SJ_2S
SJ2, SJ3: SOLDERJUMPERNO; SJ_2S-NO
U1: LTC4150; MSOP10

Connections:
!CLR!: JP4.5, R4.2, SJ1.1, SJ2.2
!INT!: JP4.2, R5.1, SJ1.2, U1.10 (!INT!)
!SHDN!: JP4.6, R8.2, R9.1, SJ3.2
GND: C1.2, JP1.1 (2), JP2.1, JP3.1, JP4.4, R3.1, R6.1, U1.7 (GND)
IN: JP1.2 (1), JP2.2, R1.1, R2.P$1 (1), U1.2 (SENSE-)
unnamed: R3.2, R4.1, SJ2.1, U1.9 (!CLR!)
unnamed: C2.1, U1.3 (CF+)
unnamed: C2.2, U1.4 (CF-)
unnamed: R6.2, R8.1, SJ3.1, U1.5 (!SHDN!)
OUT: C1.1, JP3.2, R1.2, R2.P$2 (2), U1.1 (SENSE+), U1.8 (VDD)
POL: JP4.3, R7.1, U1.6 (POL)
VIO: JP4.1, R5.2, R7.2, R9.2

Notes on the sheet:
M Grusin
CLOSE SJ2 AND SJ3 FOR 3.3V VIO
CURRENT SENSE TERMINALS:
LEAVE BOTH OPEN FOR 5V VIO
AT 1A (MAX), !INT! WILL PULSE AT
1.6275 Hz = 0.6144 S
1 !INT! = 0.0001707 Ah
5859 !INT!S = 1 Ah
OPEN SJ1 TO USE !CLR! INPUT
1.0A MAX (FOR 0.05 OHM SENSE RESISTOR)
VIO: 3.3V OR 5V
(SEE SJ2 AND SJ3)
LEAVE CLOSED FOR AUTOMATIC CLEAR
8.5V MAX
POL SIGNAL:

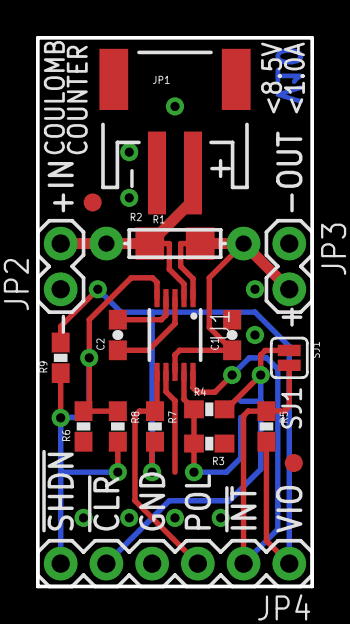
[picture p41: board LTC4150_BOB.brd from above]

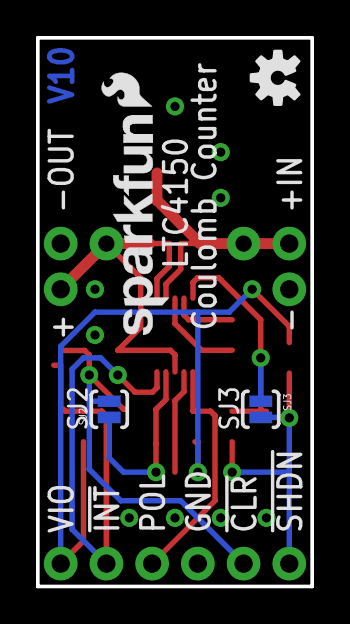
[picture p42: board LTC4150_BOB.brd from below]

Board: 2 copper layers, 15.2 x 30.5 mm, 25 parts (5 on the bottom side), 12 nets.
