earabul-sudo/GBDP_CERN_Robot/Schematics_Drawings/LTC4150_Coulomb_Counter_BOB-master/Production Files/LTC4150_BOB-Panel-v10.brd

## EAGLE design Schematics_Drawings/LTC4150_Coulomb_Counter_BOB-master/Production Files/LTC4150_BOB-Panel-v10.brd (2020-06-28)

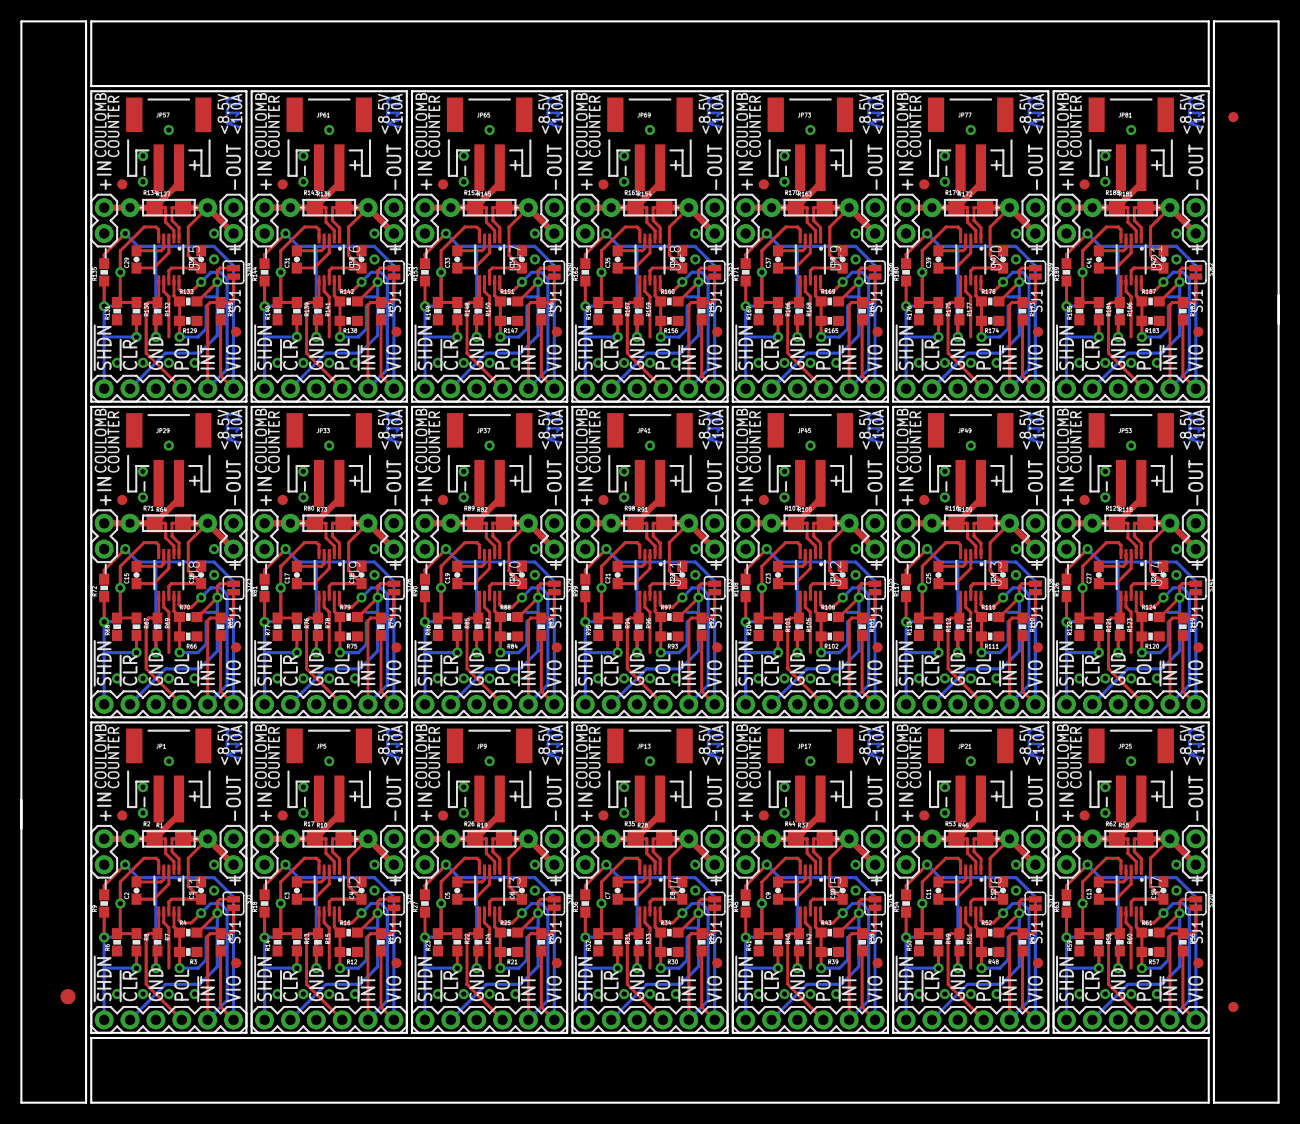
[picture p43: board LTC4150_BOB-Panel-v10.brd from above]

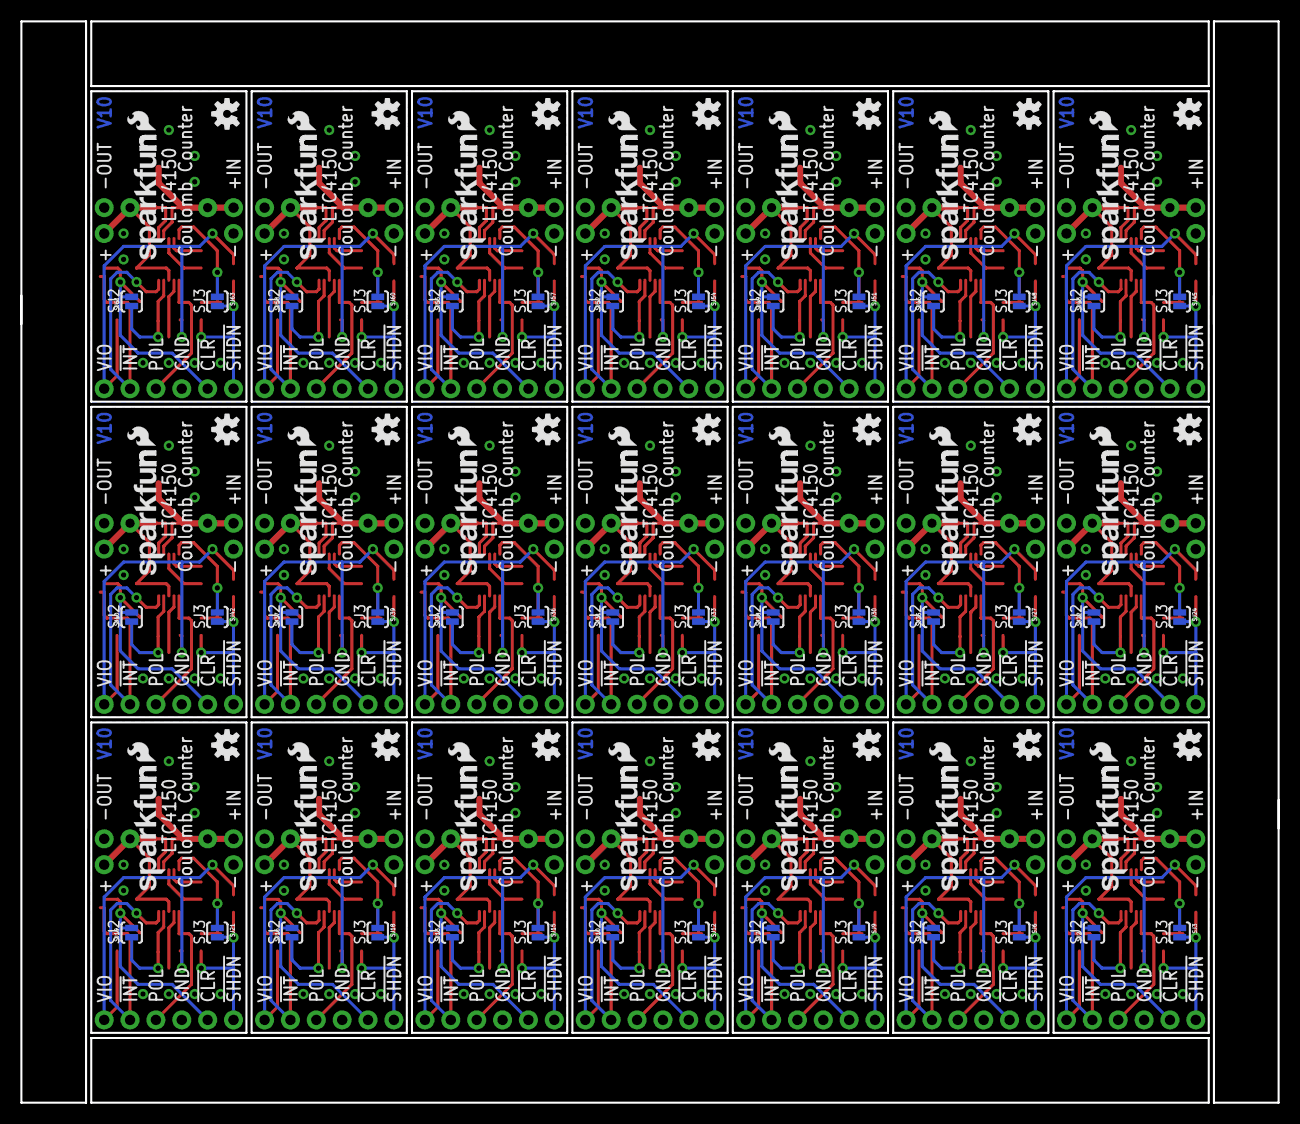
[picture p44: board LTC4150_BOB-Panel-v10.brd from below]

Board: 2 copper layers, 123.4 x 106.2 mm, 507 parts (105 on the bottom side), 252 nets.

Parts:
C1, C2, C3, C4, C5, C6, C7, C8, C9, C10, C11, C12, C13, C14, C15, C16, C17, C18, C19, C20, C21, C22, C23, C24, C25, C26, C27, C28, C29, C30, C31, C32, C33, C34, C35, C36, C37, C38, C39, C40, C41, C42: 4.7uF; 0603-CAP
E$1: FIDUCIAL-1.5X3
E$4, E$5: FIDUCIAL-1X2
FID1, FID2, FID3, FID4, FID5, FID6, FID7, FID8, FID9, FID10, FID11, FID12, FID13, FID14, FID15, FID16, FID17, FID18, FID19, FID20, FID21, FID22, FID23, FID24, FID25, FID26, FID27, FID28, FID29, FID30, FID31, FID32, FID33, FID34, FID35, FID36, FID37, FID38, FID39, FID40, FID41, FID42: FIDUCIAL1X2; FIDUCIAL-1X2
JP1, JP5, JP9, JP13, JP17, JP21, JP25, JP29, JP33, JP37, JP41, JP45, JP49, JP53, JP57, JP61, JP65, JP69, JP73, JP77, JP81: JST; JST-2-SMD
JP2, JP6, JP10, JP14, JP18, JP22, JP26, JP30, JP34, JP38, JP42, JP46, JP50, JP54, JP58, JP62, JP66, JP70, JP74, JP78, JP82: IN; 1X02
JP3, JP7, JP11, JP15, JP19, JP23, JP27, JP31, JP35, JP39, JP43, JP47, JP51, JP55, JP59, JP63, JP67, JP71, JP75, JP79, JP83: OUT; 1X02
JP4, JP8, JP12, JP16, JP20, JP24, JP28, JP32, JP36, JP40, JP44, JP48, JP52, JP56, JP60, JP64, JP68, JP72, JP76, JP80, JP84: 1X06
LOGO1, LOGO5, LOGO8, LOGO11, LOGO14, LOGO17, LOGO20, LOGO23, LOGO26, LOGO29, LOGO32, LOGO35, LOGO38, LOGO41, LOGO44, LOGO47, LOGO50, LOGO53, LOGO56, LOGO59, LOGO62: OSHW-LOGOS; OSHW-LOGO-S
LOGO2, LOGO6, LOGO9, LOGO12, LOGO15, LOGO18, LOGO21, LOGO24, LOGO27, LOGO30, LOGO33, LOGO36, LOGO39, LOGO42, LOGO45, LOGO48, LOGO51, LOGO54, LOGO57, LOGO60, LOGO63: LOGO-SFENW2; SFE-NEW-WEB
LOGO3, LOGO4, LOGO7, LOGO10, LOGO13, LOGO16, LOGO19, LOGO22, LOGO25, LOGO28, LOGO31, LOGO34, LOGO37, LOGO40, LOGO43, LOGO46, LOGO49, LOGO52, LOGO55, LOGO58, LOGO61: LOGO-SFESK; SFE-LOGO-FLAME
R1, R10, R19, R28, R37, R46, R55, R64, R73, R82, R91, R100, R109, R118, R127, R136, R145, R154, R163, R172, R181: 0.05; 1206
R2, R17, R26, R35, R44, R53, R62, R71, R80, R89, R98, R107, R116, R125, R134, R143, R152, R161, R170, R179, R188: DNP; AXIAL-0.3
R3, R6, R12, R14, R21, R23, R30, R32, R39, R41, R48, R50, R57, R59, R66, R68, R75, R77, R84, R86, R93, R95, R102, R104, R111, R113, R120, R122, R129, R131, R138, R140, R147, R149, R156, R158, R165, R167, R174, R176, R183, R185: 75K; 0603-RES
R4, R8, R13, R16, R22, R25, R31, R34, R40, R43, R49, R52, R58, R61, R67, R70, R76, R79, R85, R88, R94, R97, R103, R106, R112, R115, R121, R124, R130, R133, R139, R142, R148, R151, R157, R160, R166, R169, R175, R178, R184, R187: 47K; 0603-RES
R5, R7, R9, R11, R15, R18, R20, R24, R27, R29, R33, R36, R38, R42, R45, R47, R51, R54, R56, R60, R63, R65, R69, R72, R74, R78, R81, R83, R87, R90, R92, R96, R99, R101, R105, R108, R110, R114, R117, R119, R123, R126, R128, R132, R135, R137, R141, R144, R146, R150, R153, R155, R159, R162, R164, R168, R171, R173, R177, R180, R182, R186, R189: 3.3K; 0603-RES
SJ1, SJ5, SJ8, SJ11, SJ14, SJ17, SJ20, SJ23, SJ26, SJ29, SJ32, SJ35, SJ38, SJ41, SJ44, SJ47, SJ50, SJ53, SJ56, SJ59, SJ62: SJ_2S
SJ2, SJ3, SJ4, SJ6, SJ7, SJ9, SJ10, SJ12, SJ13, SJ15, SJ16, SJ18, SJ19, SJ21, SJ22, SJ24, SJ25, SJ27, SJ28, SJ30, SJ31, SJ33, SJ34, SJ36, SJ37, SJ39, SJ40, SJ42, SJ43, SJ45, SJ46, SJ48, SJ49, SJ51, SJ52, SJ54, SJ55, SJ57, SJ58, SJ60, SJ61, SJ63: SJ_2S-NO
U1, U2, U3, U4, U5, U6, U7, U8, U9, U10, U11, U12, U13, U14, U15, U16, U17, U18, U19, U20, U21: LTC4150; MSOP10

Connections:
!CLR!: JP4.5, R4.2, SJ1.1, SJ2.2
!CLR!1: JP8.5, R16.2, SJ4.2, SJ5.1
!CLR!2: JP12.5, R25.2, SJ7.2, SJ8.1
!CLR!3: JP16.5, R34.2, SJ10.2, SJ11.1
!CLR!4: JP20.5, R43.2, SJ13.2, SJ14.1
!CLR!5: JP24.5, R52.2, SJ16.2, SJ17.1
!CLR!6: JP28.5, R61.2, SJ19.2, SJ20.1
!CLR!7: JP32.5, R70.2, SJ22.2, SJ23.1
!CLR!8: JP36.5, R79.2, SJ25.2, SJ26.1
!CLR!9: JP40.5, R88.2, SJ28.2, SJ29.1
!CLR!10: JP44.5, R97.2, SJ31.2, SJ32.1
!CLR!11: JP48.5, R106.2, SJ34.2, SJ35.1
!CLR!12: JP52.5, R115.2, SJ37.2, SJ38.1
!CLR!13: JP56.5, R124.2, SJ40.2, SJ41.1
!CLR!14: JP60.5, R133.2, SJ43.2, SJ44.1
!CLR!15: JP64.5, R142.2, SJ46.2, SJ47.1
!CLR!16: JP68.5, R151.2, SJ49.2, SJ50.1
!CLR!17: JP72.5, R160.2, SJ52.2, SJ53.1
!CLR!18: JP76.5, R169.2, SJ55.2, SJ56.1
!CLR!19: JP80.5, R178.2, SJ58.2, SJ59.1
!CLR!20: JP84.5, R187.2, SJ61.2, SJ62.1
!INT!: JP4.2, R5.1, SJ1.2, U1.10
!INT!1: JP8.2, R11.1, SJ5.2, U2.10
!INT!2: JP12.2, R20.1, SJ8.2, U3.10
!INT!3: JP16.2, R29.1, SJ11.2, U4.10
!INT!4: JP20.2, R38.1, SJ14.2, U5.10
!INT!5: JP24.2, R47.1, SJ17.2, U6.10
!INT!6: JP28.2, R56.1, SJ20.2, U7.10
!INT!7: JP32.2, R65.1, SJ23.2, U8.10
!INT!8: JP36.2, R74.1, SJ26.2, U9.10
!INT!9: JP40.2, R83.1, SJ29.2, U10.10
!INT!10: JP44.2, R92.1, SJ32.2, U11.10
!INT!11: JP48.2, R101.1, SJ35.2, U12.10
!INT!12: JP52.2, R110.1, SJ38.2, U13.10
!INT!13: JP56.2, R119.1, SJ41.2, U14.10
!INT!14: JP60.2, R128.1, SJ44.2, U15.10
!INT!15: JP64.2, R137.1, SJ47.2, U16.10
!INT!16: JP68.2, R146.1, SJ50.2, U17.10
!INT!17: JP72.2, R155.1, SJ53.2, U18.10
!INT!18: JP76.2, R164.1, SJ56.2, U19.10
!INT!19: JP80.2, R173.1, SJ59.2, U20.10
!INT!20: JP84.2, R182.1, SJ62.2, U21.10
!SHDN!: JP4.6, R8.2, R9.1, SJ3.2
!SHDN!1: JP8.6, R13.2, R18.1, SJ6.2
!SHDN!2: JP12.6, R22.2, R27.1, SJ9.2
!SHDN!3: JP16.6, R31.2, R36.1, SJ12.2
!SHDN!4: JP20.6, R40.2, R45.1, SJ15.2
!SHDN!5: JP24.6, R49.2, R54.1, SJ18.2
!SHDN!6: JP28.6, R58.2, R63.1, SJ21.2
!SHDN!7: JP32.6, R67.2, R72.1, SJ24.2
!SHDN!8: JP36.6, R76.2, R81.1, SJ27.2
!SHDN!9: JP40.6, R85.2, R90.1, SJ30.2
!SHDN!10: JP44.6, R94.2, R99.1, SJ33.2
!SHDN!11: JP48.6, R103.2, R108.1, SJ36.2
!SHDN!12: JP52.6, R112.2, R117.1, SJ39.2
!SHDN!13: JP56.6, R121.2, R126.1, SJ42.2
!SHDN!14: JP60.6, R130.2, R135.1, SJ45.2
!SHDN!15: JP64.6, R139.2, R144.1, SJ48.2
!SHDN!16: JP68.6, R148.2, R153.1, SJ51.2
!SHDN!17: JP72.6, R157.2, R162.1, SJ54.2
!SHDN!18: JP76.6, R166.2, R171.1, SJ57.2
!SHDN!19: JP80.6, R175.2, R180.1, SJ60.2
!SHDN!20: JP84.6, R184.2, R189.1, SJ63.2
GND: C1.2, JP1.1, JP2.1, JP3.1, JP4.4, R3.1, R6.1, U1.7
GND1: C4.2, JP5.1, JP6.1, JP7.1, JP8.4, R12.1, R14.1, U2.7
GND2: C6.2, JP9.1, JP10.1, JP11.1, JP12.4, R21.1, R23.1, U3.7
GND3: C8.2, JP13.1, JP14.1, JP15.1, JP16.4, R30.1, R32.1, U4.7
GND4: C10.2, JP17.1, JP18.1, JP19.1, JP20.4, R39.1, R41.1, U5.7
GND5: C12.2, JP21.1, JP22.1, JP23.1, JP24.4, R48.1, R50.1, U6.7
GND6: C14.2, JP25.1, JP26.1, JP27.1, JP28.4, R57.1, R59.1, U7.7
GND7: C16.2, JP29.1, JP30.1, JP31.1, JP32.4, R66.1, R68.1, U8.7
GND8: C18.2, JP33.1, JP34.1, JP35.1, JP36.4, R75.1, R77.1, U9.7
GND9: C20.2, JP37.1, JP38.1, JP39.1, JP40.4, R84.1, R86.1, U10.7
GND10: C22.2, JP41.1, JP42.1, JP43.1, JP44.4, R93.1, R95.1, U11.7
GND11: C24.2, JP45.1, JP46.1, JP47.1, JP48.4, R102.1, R104.1, U12.7
GND12: C26.2, JP49.1, JP50.1, JP51.1, JP52.4, R111.1, R113.1, U13.7
GND13: C28.2, JP53.1, JP54.1, JP55.1, JP56.4, R120.1, R122.1, U14.7
GND14: C30.2, JP57.1, JP58.1, JP59.1, JP60.4, R129.1, R131.1, U15.7
GND15: C32.2, JP61.1, JP62.1, JP63.1, JP64.4, R138.1, R140.1, U16.7
GND16: C34.2, JP65.1, JP66.1, JP67.1, JP68.4, R147.1, R149.1, U17.7
GND17: C36.2, JP69.1, JP70.1, JP71.1, JP72.4, R156.1, R158.1, U18.7
GND18: C38.2, JP73.1, JP74.1, JP75.1, JP76.4, R165.1, R167.1, U19.7
GND19: C40.2, JP77.1, JP78.1, JP79.1, JP80.4, R174.1, R176.1, U20.7
GND20: C42.2, JP81.1, JP82.1, JP83.1, JP84.4, R183.1, R185.1, U21.7
IN: JP1.2, JP2.2, R1.1, R2.P$1, U1.2
IN1: JP5.2, JP6.2, R10.1, R17.P$1, U2.2
IN2: JP9.2, JP10.2, R19.1, R26.P$1, U3.2
IN3: JP13.2, JP14.2, R28.1, R35.P$1, U4.2
IN4: JP17.2, JP18.2, R37.1, R44.P$1, U5.2
IN5: JP21.2, JP22.2, R46.1, R53.P$1, U6.2
IN6: JP25.2, JP26.2, R55.1, R62.P$1, U7.2
IN7: JP29.2, JP30.2, R64.1, R71.P$1, U8.2
IN8: JP33.2, JP34.2, R73.1, R80.P$1, U9.2
IN9: JP37.2, JP38.2, R82.1, R89.P$1, U10.2
IN10: JP41.2, JP42.2, R91.1, R98.P$1, U11.2
IN11: JP45.2, JP46.2, R100.1, R107.P$1, U12.2
IN12: JP49.2, JP50.2, R109.1, R116.P$1, U13.2
IN13: JP53.2, JP54.2, R118.1, R125.P$1, U14.2
IN14: JP57.2, JP58.2, R127.1, R134.P$1, U15.2
IN15: JP61.2, JP62.2, R136.1, R143.P$1, U16.2
IN16: JP65.2, JP66.2, R145.1, R152.P$1, U17.2
IN17: JP69.2, JP70.2, R154.1, R161.P$1, U18.2
IN18: JP73.2, JP74.2, R163.1, R170.P$1, U19.2
IN19: JP77.2, JP78.2, R172.1, R179.P$1, U20.2
IN20: JP81.2, JP82.2, R181.1, R188.P$1, U21.2
unnamed: R3.2, R4.1, SJ2.1, U1.9
unnamed: C3.1, U2.3
unnamed: C2.1, U1.3
unnamed: C2.2, U1.4
unnamed: C3.2, U2.4
unnamed: R13.1, R14.2, SJ6.1, U2.5
unnamed: R12.2, R16.1, SJ4.1, U2.9
unnamed: C5.1, U3.3
unnamed: R6.2, R8.1, SJ3.1, U1.5
unnamed: C5.2, U3.4
unnamed: R22.1, R23.2, SJ9.1, U3.5
unnamed: R21.2, R25.1, SJ7.1, U3.9
unnamed: C7.1, U4.3
unnamed: C7.2, U4.4
unnamed: R31.1, R32.2, SJ12.1, U4.5
unnamed: R30.2, R34.1, SJ10.1, U4.9
unnamed: C9.1, U5.3
unnamed: C9.2, U5.4
unnamed: R40.1, R41.2, SJ15.1, U5.5
unnamed: R39.2, R43.1, SJ13.1, U5.9
unnamed: C11.1, U6.3
unnamed: C11.2, U6.4
unnamed: R49.1, R50.2, SJ18.1, U6.5
unnamed: R48.2, R52.1, SJ16.1, U6.9
unnamed: C13.1, U7.3
unnamed: C13.2, U7.4
unnamed: R58.1, R59.2, SJ21.1, U7.5
unnamed: R57.2, R61.1, SJ19.1, U7.9
unnamed: C15.1, U8.3
unnamed: C15.2, U8.4
unnamed: R67.1, R68.2, SJ24.1, U8.5
unnamed: R66.2, R70.1, SJ22.1, U8.9
unnamed: C17.1, U9.3
unnamed: C17.2, U9.4
unnamed: R76.1, R77.2, SJ27.1, U9.5
unnamed: R75.2, R79.1, SJ25.1, U9.9
unnamed: C19.1, U10.3
unnamed: C19.2, U10.4
unnamed: R85.1, R86.2, SJ30.1, U10.5
unnamed: R84.2, R88.1, SJ28.1, U10.9
unnamed: C21.1, U11.3
unnamed: C21.2, U11.4
unnamed: R94.1, R95.2, SJ33.1, U11.5
unnamed: R93.2, R97.1, SJ31.1, U11.9
unnamed: C23.1, U12.3
unnamed: C23.2, U12.4
unnamed: R103.1, R104.2, SJ36.1, U12.5
unnamed: R102.2, R106.1, SJ34.1, U12.9
unnamed: C25.1, U13.3
unnamed: C25.2, U13.4
unnamed: R112.1, R113.2, SJ39.1, U13.5
unnamed: R111.2, R115.1, SJ37.1, U13.9
unnamed: C27.1, U14.3
unnamed: C27.2, U14.4
unnamed: R121.1, R122.2, SJ42.1, U14.5
unnamed: R120.2, R124.1, SJ40.1, U14.9
unnamed: C29.1, U15.3
unnamed: C29.2, U15.4
unnamed: R130.1, R131.2, SJ45.1, U15.5
unnamed: R129.2, R133.1, SJ43.1, U15.9
unnamed: C31.1, U16.3
unnamed: C31.2, U16.4
unnamed: R139.1, R140.2, SJ48.1, U16.5
unnamed: R138.2, R142.1, SJ46.1, U16.9
unnamed: C33.1, U17.3
unnamed: C33.2, U17.4
unnamed: R148.1, R149.2, SJ51.1, U17.5
unnamed: R147.2, R151.1, SJ49.1, U17.9
unnamed: C35.1, U18.3
unnamed: C35.2, U18.4
unnamed: R157.1, R158.2, SJ54.1, U18.5
unnamed: R156.2, R160.1, SJ52.1, U18.9
unnamed: C37.1, U19.3
unnamed: C37.2, U19.4
unnamed: R166.1, R167.2, SJ57.1, U19.5
unnamed: R165.2, R169.1, SJ55.1, U19.9
unnamed: C39.1, U20.3
unnamed: C39.2, U20.4
unnamed: R175.1, R176.2, SJ60.1, U20.5
unnamed: R174.2, R178.1, SJ58.1, U20.9
unnamed: C41.1, U21.3
unnamed: C41.2, U21.4
unnamed: R184.1, R185.2, SJ63.1, U21.5
unnamed: R183.2, R187.1, SJ61.1, U21.9
OUT: C1.1, JP3.2, R1.2, R2.P$2, U1.1, U1.8
OUT1: C4.1, JP7.2, R10.2, R17.P$2, U2.1, U2.8
OUT2: C6.1, JP11.2, R19.2, R26.P$2, U3.1, U3.8
OUT3: C8.1, JP15.2, R28.2, R35.P$2, U4.1, U4.8
OUT4: C10.1, JP19.2, R37.2, R44.P$2, U5.1, U5.8
OUT5: C12.1, JP23.2, R46.2, R53.P$2, U6.1, U6.8
OUT6: C14.1, JP27.2, R55.2, R62.P$2, U7.1, U7.8
OUT7: C16.1, JP31.2, R64.2, R71.P$2, U8.1, U8.8
OUT8: C18.1, JP35.2, R73.2, R80.P$2, U9.1, U9.8
OUT9: C20.1, JP39.2, R82.2, R89.P$2, U10.1, U10.8
OUT10: C22.1, JP43.2, R91.2, R98.P$2, U11.1, U11.8
OUT11: C24.1, JP47.2, R100.2, R107.P$2, U12.1, U12.8
OUT12: C26.1, JP51.2, R109.2, R116.P$2, U13.1, U13.8
OUT13: C28.1, JP55.2, R118.2, R125.P$2, U14.1, U14.8
OUT14: C30.1, JP59.2, R127.2, R134.P$2, U15.1, U15.8
OUT15: C32.1, JP63.2, R136.2, R143.P$2, U16.1, U16.8
OUT16: C34.1, JP67.2, R145.2, R152.P$2, U17.1, U17.8
OUT17: C36.1, JP71.2, R154.2, R161.P$2, U18.1, U18.8
OUT18: C38.1, JP75.2, R163.2, R170.P$2, U19.1, U19.8
OUT19: C40.1, JP79.2, R172.2, R179.P$2, U20.1, U20.8
OUT20: C42.1, JP83.2, R181.2, R188.P$2, U21.1, U21.8
POL: JP4.3, R7.1, U1.6
POL1: JP8.3, R15.1, U2.6
POL2: JP12.3, R24.1, U3.6
POL3: JP16.3, R33.1, U4.6
POL4: JP20.3, R42.1, U5.6
POL5: JP24.3, R51.1, U6.6
POL6: JP28.3, R60.1, U7.6
POL7: JP32.3, R69.1, U8.6
POL8: JP36.3, R78.1, U9.6
POL9: JP40.3, R87.1, U10.6
POL10: JP44.3, R96.1, U11.6
POL11: JP48.3, R105.1, U12.6
POL12: JP52.3, R114.1, U13.6
POL13: JP56.3, R123.1, U14.6
POL14: JP60.3, R132.1, U15.6
POL15: JP64.3, R141.1, U16.6
POL16: JP68.3, R150.1, U17.6
POL17: JP72.3, R159.1, U18.6
POL18: JP76.3, R168.1, U19.6
POL19: JP80.3, R177.1, U20.6
POL20: JP84.3, R186.1, U21.6
VIO: JP4.1, R5.2, R7.2, R9.2
VIO1: JP8.1, R11.2, R15.2, R18.2
VIO2: JP12.1, R20.2, R24.2, R27.2
VIO3: JP16.1, R29.2, R33.2, R36.2
VIO4: JP20.1, R38.2, R42.2, R45.2
VIO5: JP24.1, R47.2, R51.2, R54.2
VIO6: JP28.1, R56.2, R60.2, R63.2
VIO7: JP32.1, R65.2, R69.2, R72.2
VIO8: JP36.1, R74.2, R78.2, R81.2
VIO9: JP40.1, R83.2, R87.2, R90.2
VIO10: JP44.1, R92.2, R96.2, R99.2
VIO11: JP48.1, R101.2, R105.2, R108.2
VIO12: JP52.1, R110.2, R114.2, R117.2
VIO13: JP56.1, R119.2, R123.2, R126.2
VIO14: JP60.1, R128.2, R132.2, R135.2
VIO15: JP64.1, R137.2, R141.2, R144.2
VIO16: JP68.1, R146.2, R150.2, R153.2
VIO17: JP72.1, R155.2, R159.2, R162.2
VIO18: JP76.1, R164.2, R168.2, R171.2
VIO19: JP80.1, R173.2, R177.2, R180.2
VIO20: JP84.1, R182.2, R186.2, R189.2
